RandoL26/ENMT301_RoboCup/Solidworks/Drawings/CraneArm.JPG

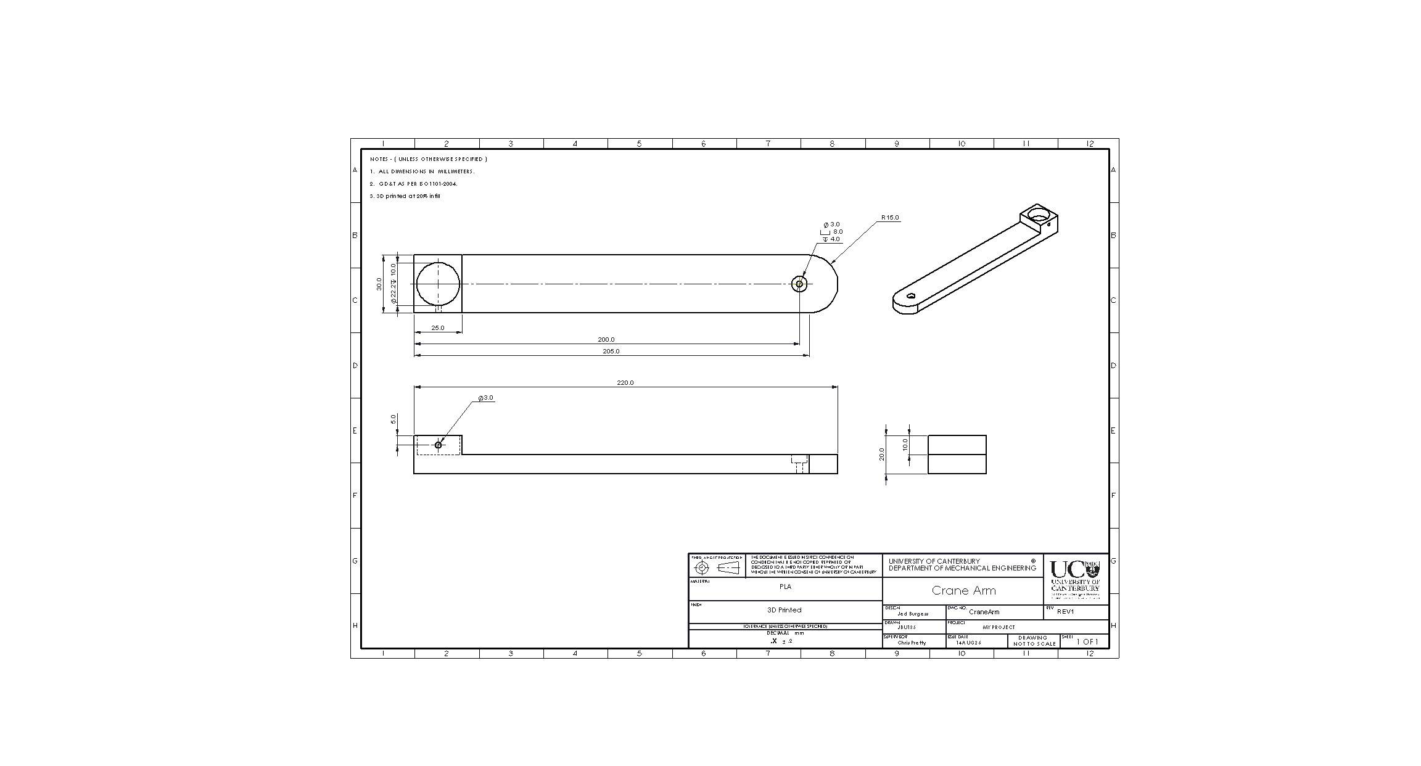
Solidworks/Drawings/CraneArm.JPG
