RandoL26/ENMT301_RoboCup/Solidworks/Drawings/Electronics Bay Upper.JPG

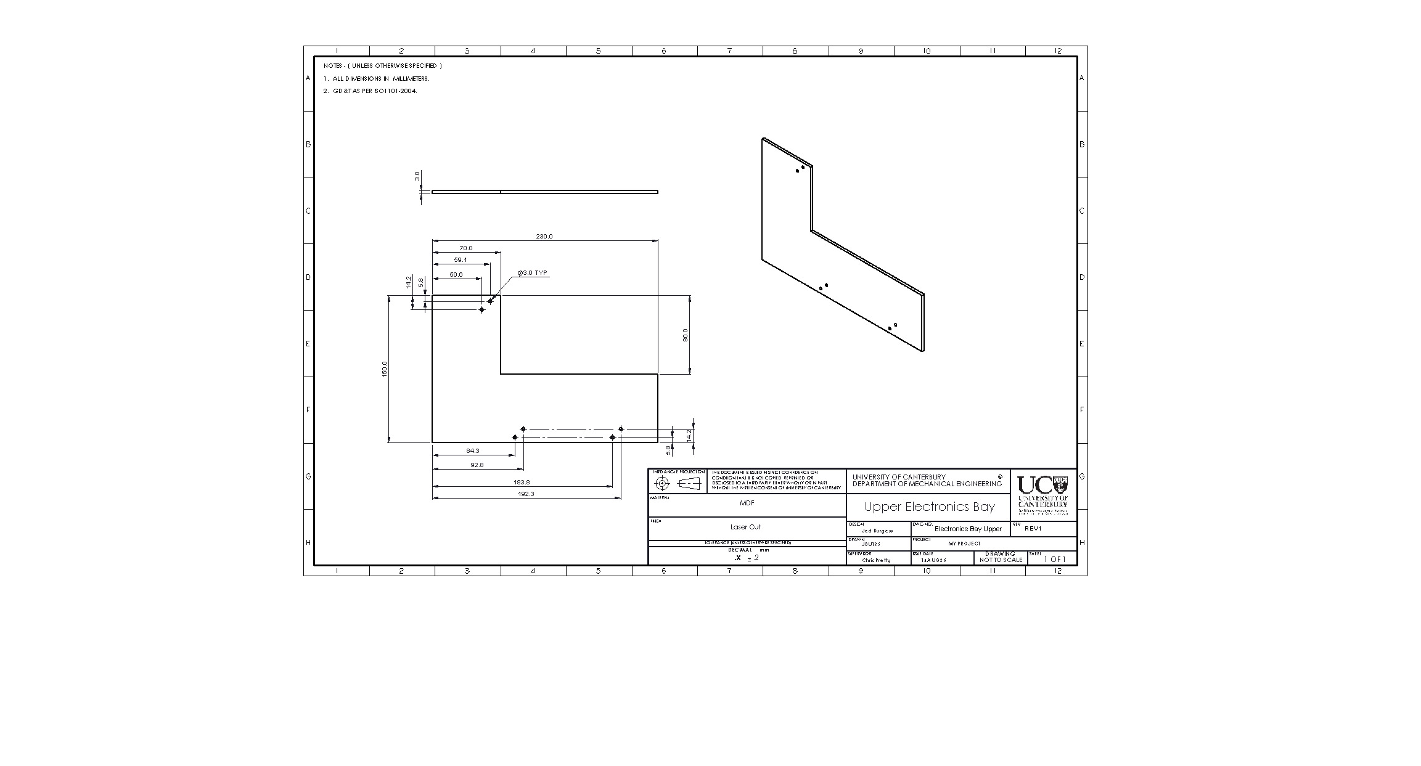
Solidworks/Drawings/Electronics Bay Upper.JPG
