RandoL26/ENMT301_RoboCup/Solidworks/Robot main chassis support 223.5mm_SP.SLDPRT

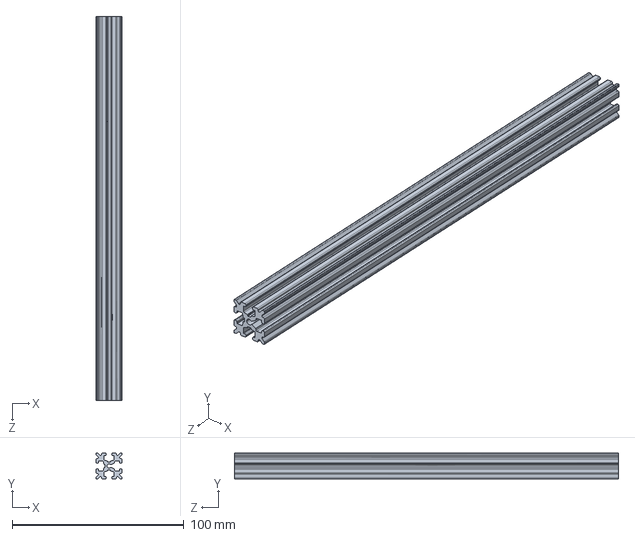
[picture p3: CAD file, 2026-06-23]
Solidworks/Robot main chassis support 223.5mm_SP.SLDPRT
15.0 x 15.0 x 223.5 mm
