RandoL26/ENMT301_RoboCup/Solidworks/Storage/Storage Assembly.SLDASM

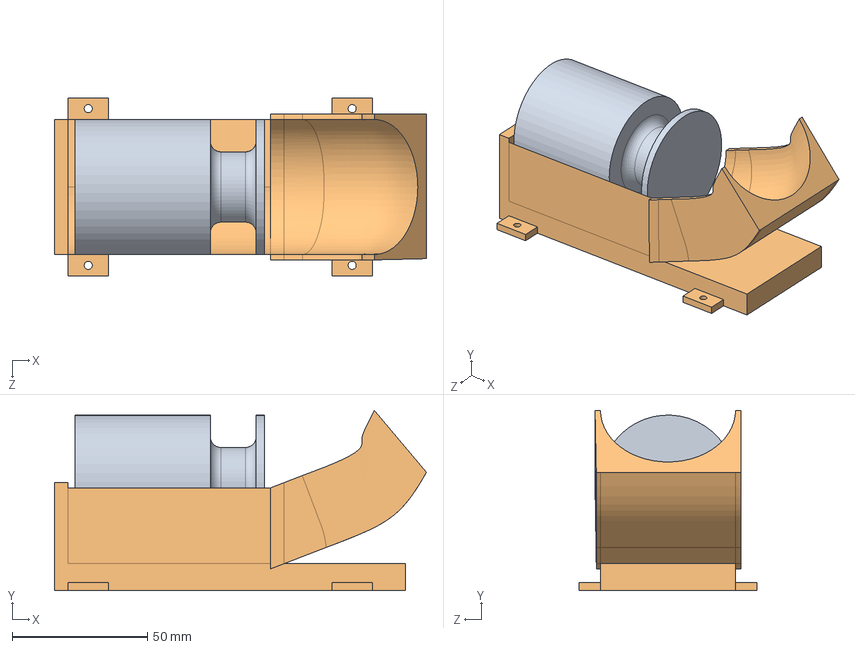
[picture p4: CAD file, 2026-08-28]
Solidworks/Storage/Storage Assembly.SLDASM
137.7 x 66.8 x 66.0 mm
Storage
WeightModel
