RandoL26/ENMT301_RoboCup/Solidworks/Weight Rejection/WeightRejectionAssembly.SLDASM

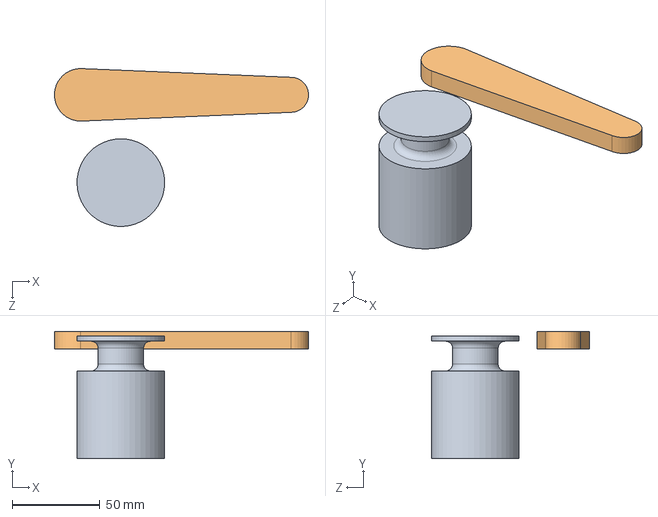
[picture p5: CAD file, 2026-08-07]
Solidworks/Weight Rejection/WeightRejectionAssembly.SLDASM
144.9 x 72.6 x 90.1 mm
RejectionArm
WeightModel
