RandoL26/ENMT301_RoboCup/Solidworks/Storage/StorageAssemblyV2.SLDASM

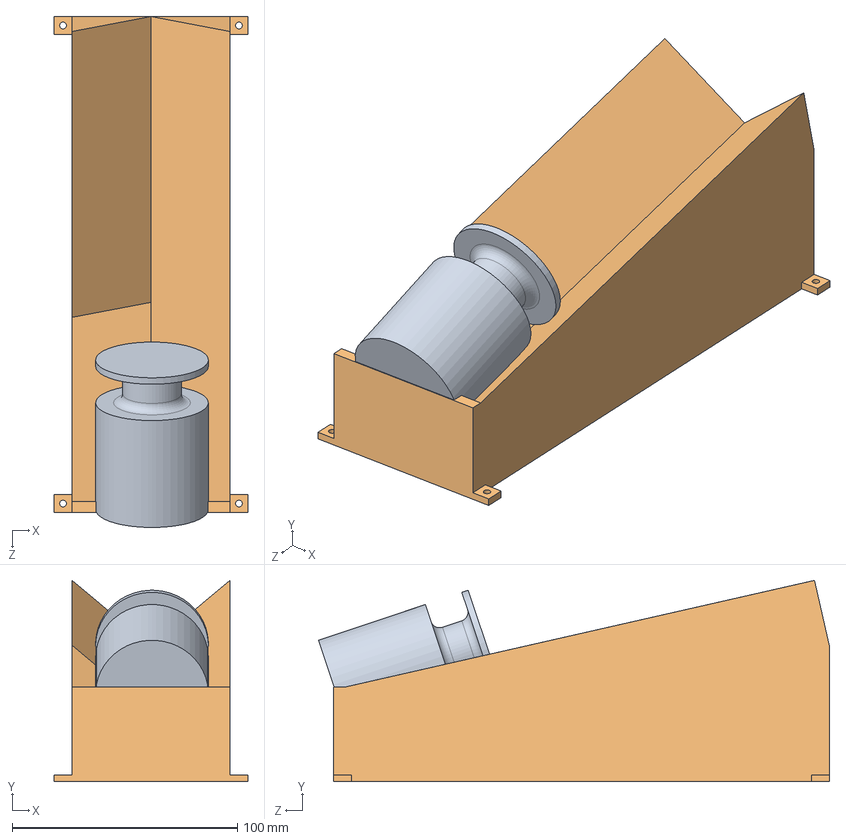
[picture p6: CAD file, 2026-08-28]
Solidworks/Storage/StorageAssemblyV2.SLDASM
86.0 x 89.3 x 226.6 mm
StorageV2
WeightModel
