RandoL26/ENMT301_RoboCup/Solidworks/MainAssembly/Custom Chassis Base.SLDPRT

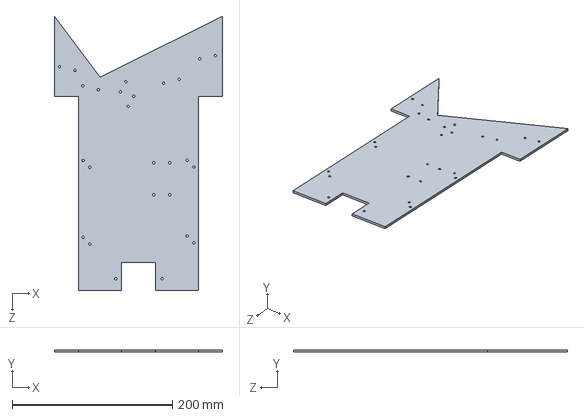
[picture p7: CAD file, 2026-09-27]
Solidworks/MainAssembly/Custom Chassis Base.SLDPRT
210.0 x 3.00 x 343.0 mm
