RandoL26/ENMT301_RoboCup/Solidworks/Printing/10 Teeth Gear 22mm bearing, drivebelt meshing.SLDPRT

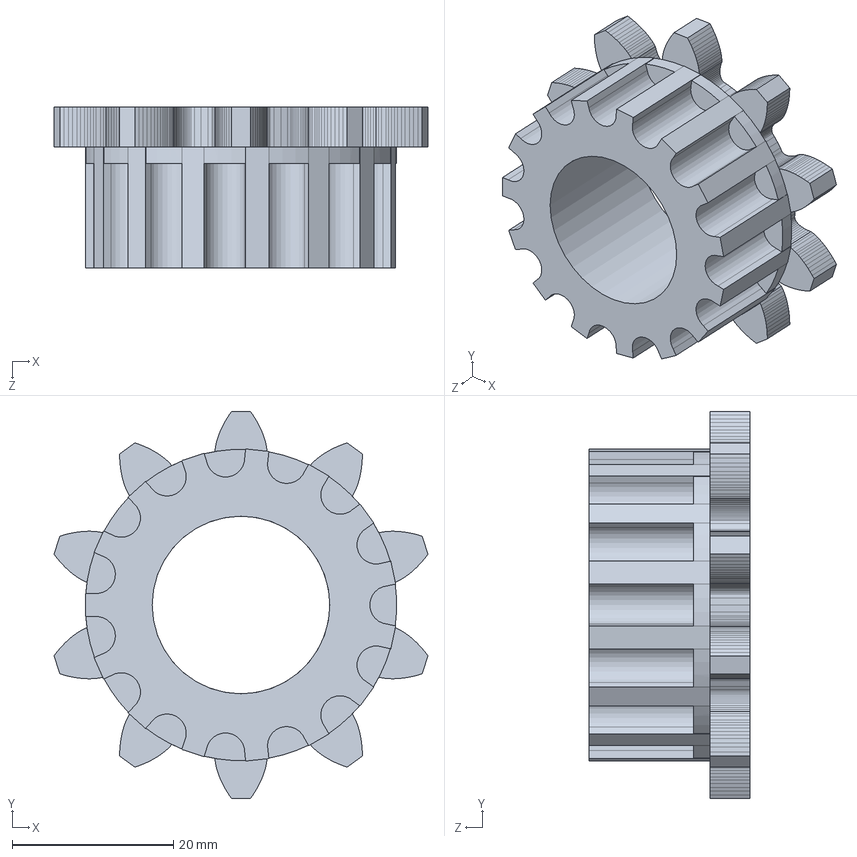
[picture p8: CAD file, 2026-09-29]
Solidworks/Printing/10 Teeth Gear 22mm bearing, drivebelt meshing.SLDPRT
46.3 x 47.9 x 20.0 mm
