RandoL26/ENMT301_RoboCup/Solidworks/Storage/StorageV2.SLDPRT

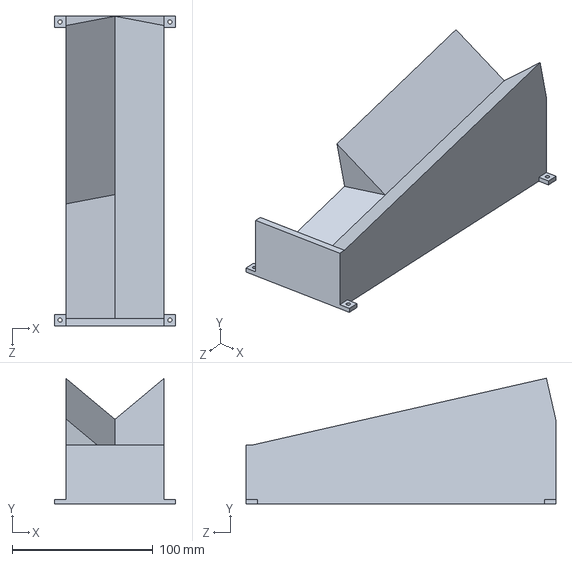
[picture p9: CAD file, 2026-08-28]
Solidworks/Storage/StorageV2.SLDPRT
86.0 x 89.3 x 220.0 mm
