RandoL26/ENMT301_RoboCup/Solidworks/CraneArm/CraneArm.SLDPRT

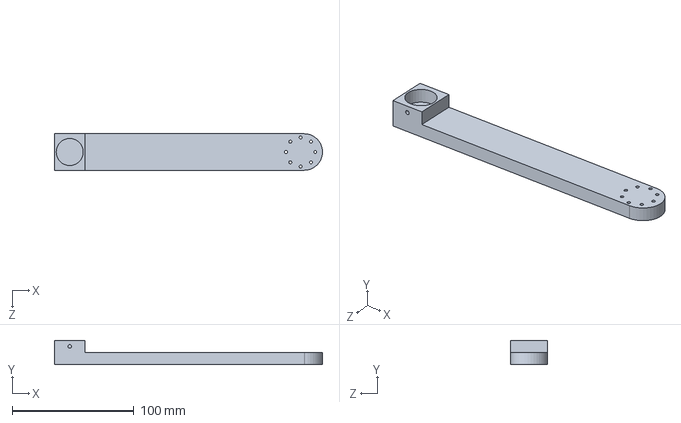
[picture p10: CAD file, 2026-09-29]
Solidworks/CraneArm/CraneArm.SLDPRT
219.9 x 20.0 x 30.0 mm
