RandoL26/ENMT301_RoboCup/Solidworks/DriveBeltAssembly/Custom Side Plate.SLDPRT

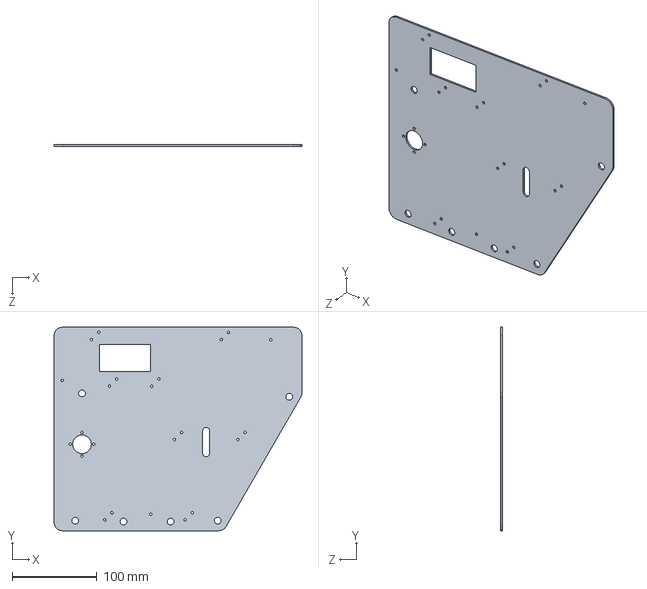
[picture p11: CAD file, 2026-09-29]
Solidworks/DriveBeltAssembly/Custom Side Plate.SLDPRT
292.4 x 240.0 x 2.00 mm
