RandoL26/ENMT301_RoboCup/Solidworks/Electronics/Inductiveshiftmount.SLDPRT

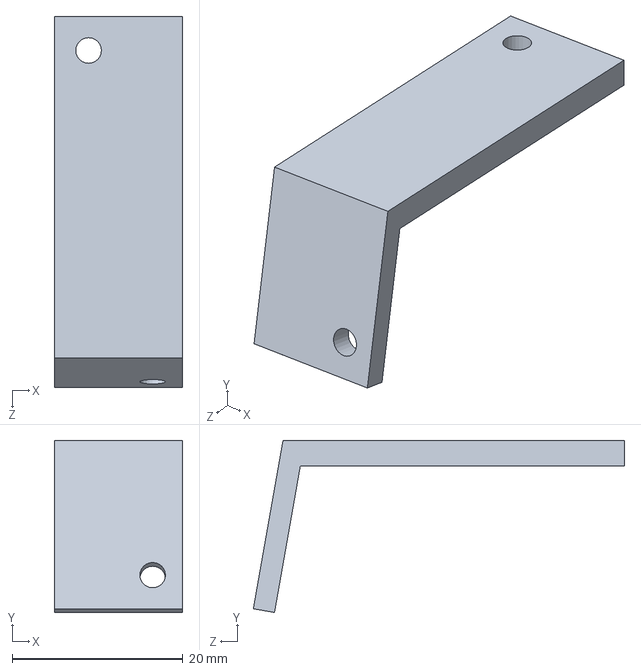
[picture p12: CAD file, 2026-09-29]
Solidworks/Electronics/Inductiveshiftmount.SLDPRT
15.0 x 20.1 x 43.5 mm
