RandoL26/ENMT301_RoboCup/Solidworks/MainAssembly/Opticalflwmount.SLDPRT

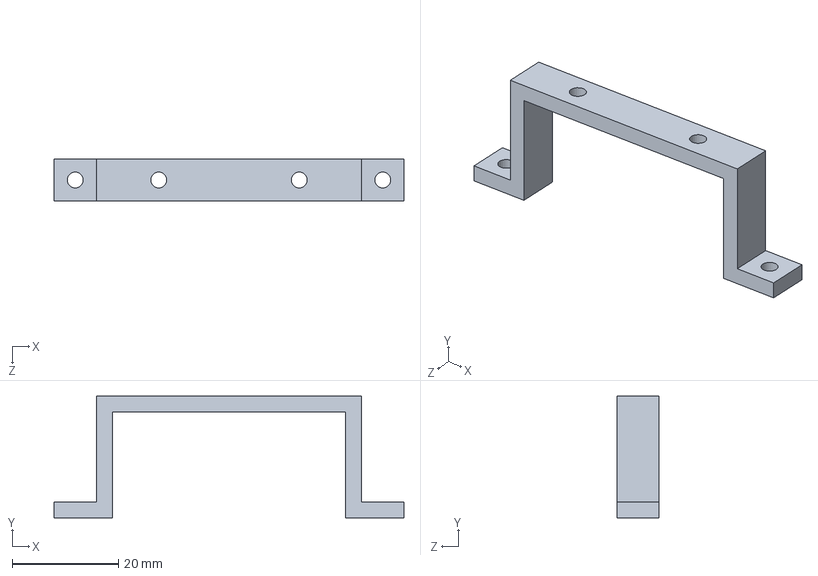
[picture p13: CAD file, 2026-09-25]
Solidworks/MainAssembly/Opticalflwmount.SLDPRT
66.0 x 23.0 x 8.00 mm
