RandoL26/ENMT301_RoboCup/Solidworks/Printing/20 Teeth Gear 6.25mm bore for motor shaft.SLDPRT

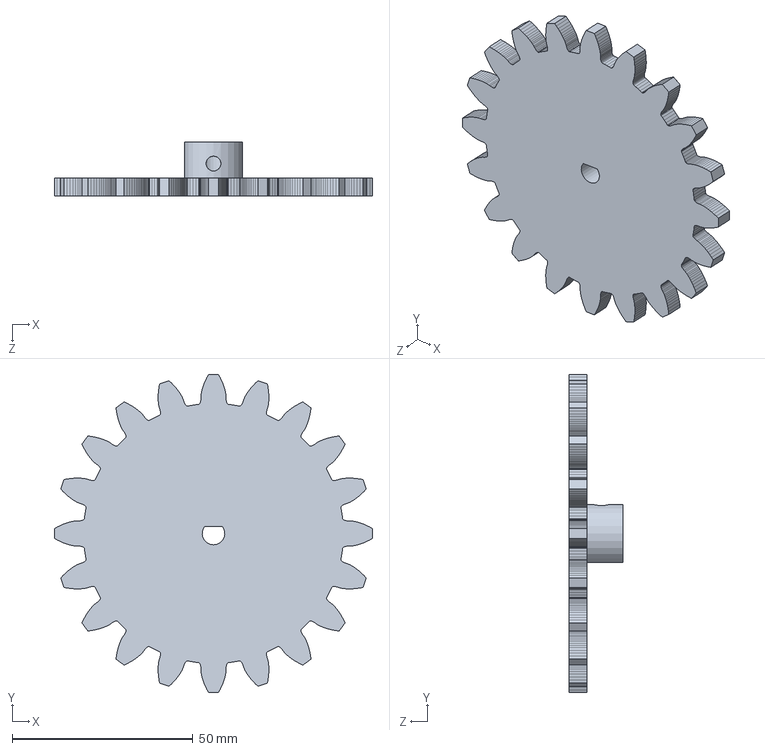
[picture p14: CAD file, 2026-09-29]
Solidworks/Printing/20 Teeth Gear 6.25mm bore for motor shaft.SLDPRT
88.0 x 88.0 x 15.0 mm
