RandoL26/ENMT301_RoboCup/Solidworks/Top Plate_SP.SLDPRT

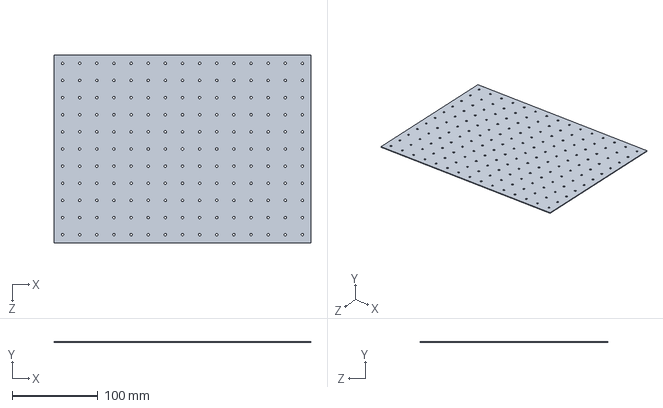
[picture p15: CAD file, 2026-06-23]
Solidworks/Top Plate_SP.SLDPRT
300.0 x 1.00 x 220.0 mm
