RandoL26/ENMT301_RoboCup/Solidworks/Weight Rejection/RejectionArm.SLDPRT

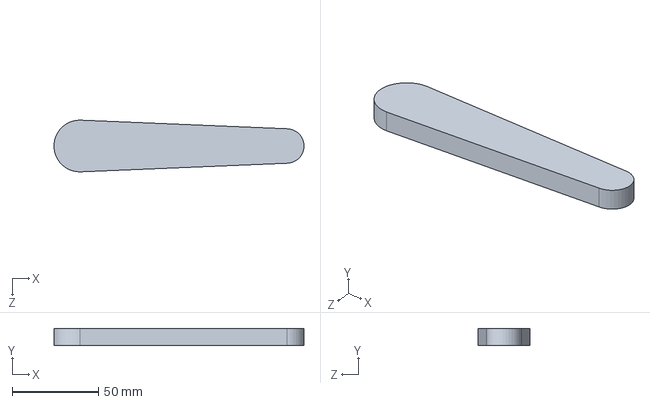
[picture p16: CAD file, 2026-08-07]
Solidworks/Weight Rejection/RejectionArm.SLDPRT
144.9 x 10.0 x 30.0 mm
