RandoL26/ENMT301_RoboCup/Solidworks/CraneArm/CraneArmSupport.SLDPRT

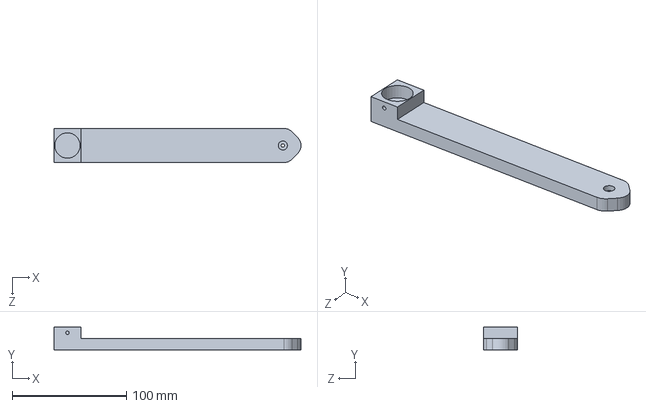
[picture p17: CAD file, 2026-07-13]
Solidworks/CraneArm/CraneArmSupport.SLDPRT
215.9 x 20.0 x 30.0 mm
