RandoL26/ENMT301_RoboCup/Solidworks/DriveBeltAssembly/Custom Side Plate Flipped.SLDPRT

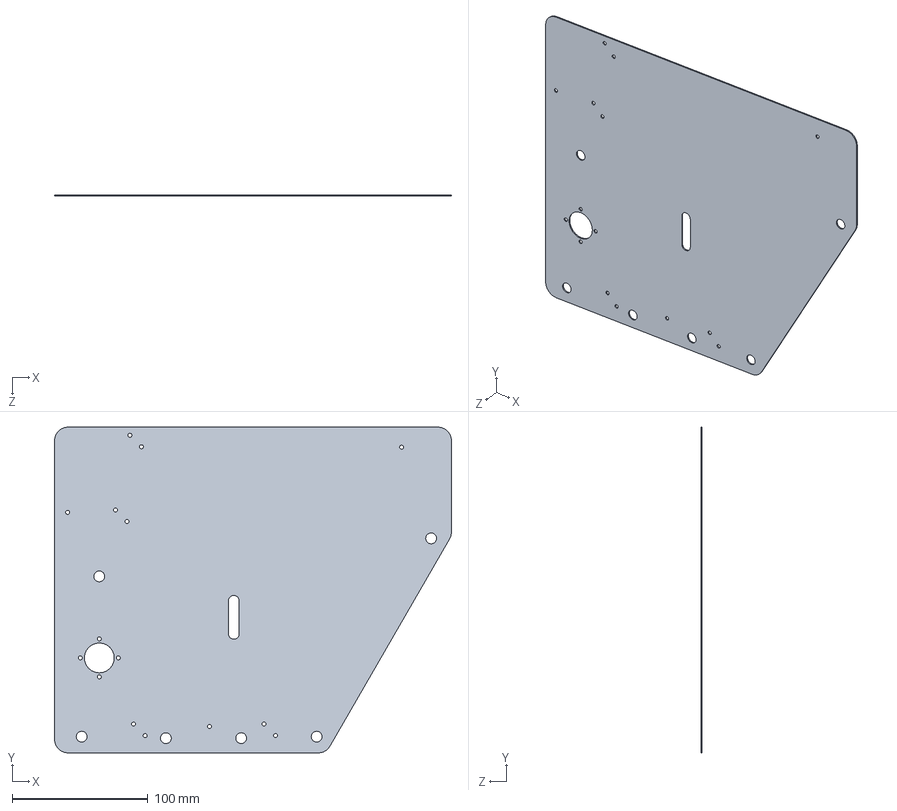
[picture p18: CAD file, 2026-09-29]
Solidworks/DriveBeltAssembly/Custom Side Plate Flipped.SLDPRT
292.4 x 240.0 x 1.00 mm
