RandoL26/ENMT301_RoboCup/Solidworks/Open Beam Aluminum Profile 30mm_SP.SLDPRT

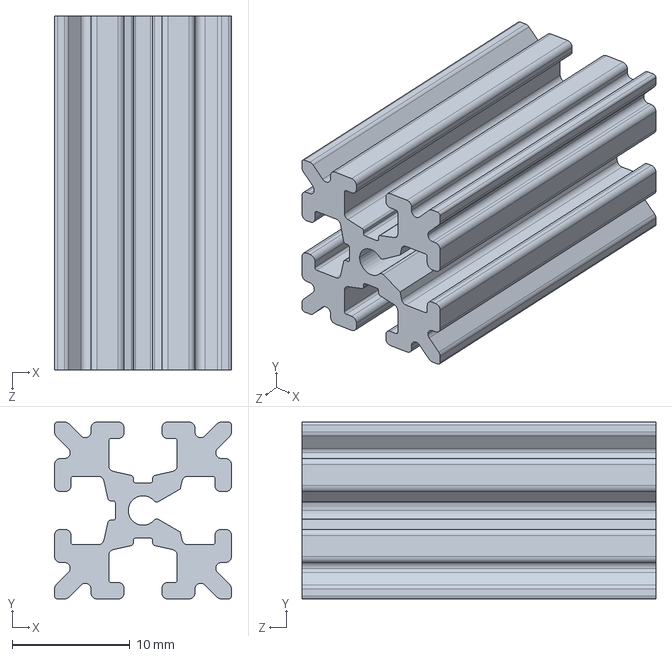
[picture p19: CAD file, 2026-06-23]
Solidworks/Open Beam Aluminum Profile 30mm_SP.SLDPRT
15.0 x 15.0 x 30.0 mm
