RandoL26/ENMT301_RoboCup/Solidworks/Printing/20 Teeth Gear 6.25mm blahblahblah.SLDPRT

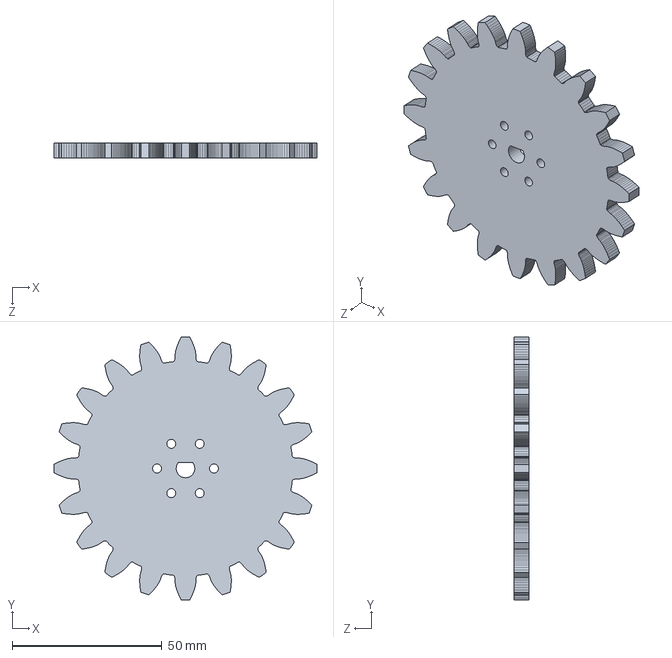
[picture p20: CAD file, 2026-09-29]
Solidworks/Printing/20 Teeth Gear 6.25mm blahblahblah.SLDPRT
88.0 x 88.0 x 5.00 mm
