RandoL26/ENMT301_RoboCup/Solidworks/Storage/Storage.SLDPRT

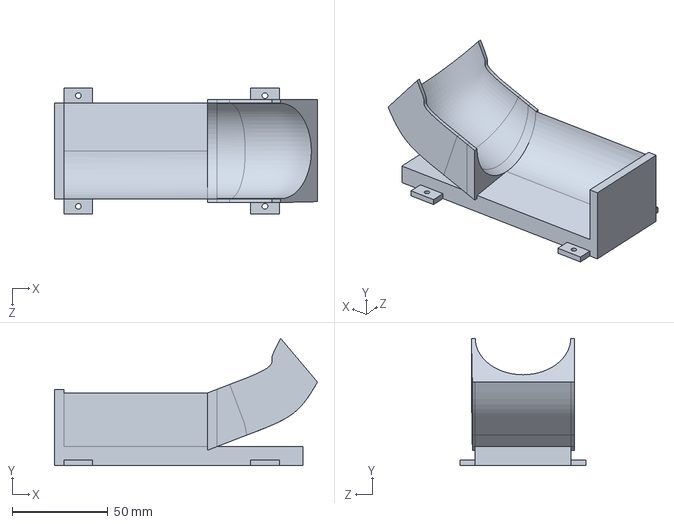
[picture p21: CAD file, 2026-08-28]
Solidworks/Storage/Storage.SLDPRT
137.7 x 66.8 x 66.0 mm
