RandoL26/ENMT301_RoboCup/Solidworks/Electronics/Electronics Bay Upper.SLDPRT

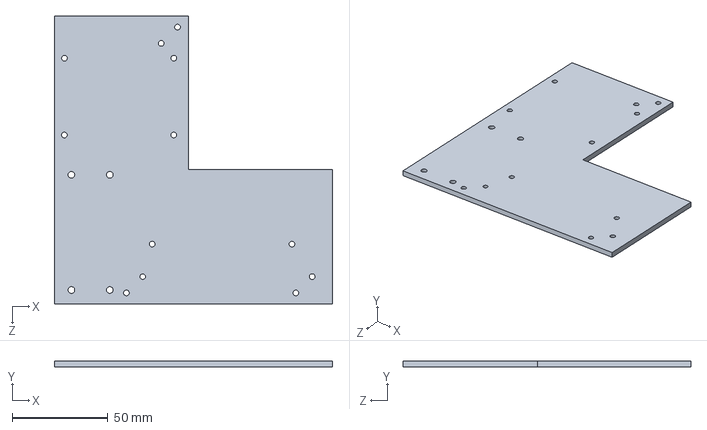
[picture p22: CAD file, 2026-09-29]
Solidworks/Electronics/Electronics Bay Upper.SLDPRT
145.0 x 3.00 x 150.0 mm
