RandoL26/ENMT301_RoboCup/Solidworks/MainAssembly/Open Beam Aluminum Profile 150mm_SP.SLDPRT

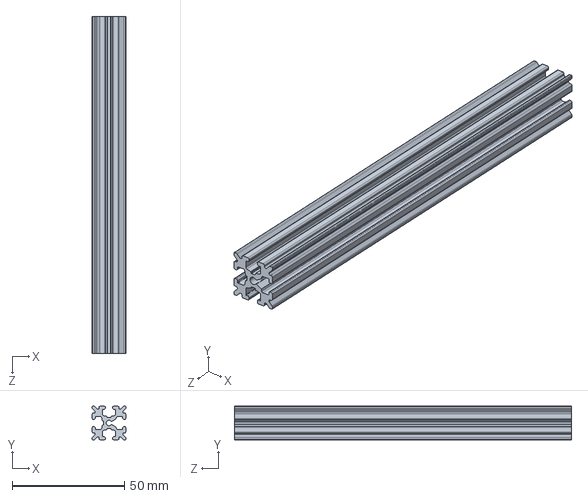
[picture p23: CAD file, 2026-07-15]
Solidworks/MainAssembly/Open Beam Aluminum Profile 150mm_SP.SLDPRT
15.0 x 15.0 x 150.0 mm
