RandoL26/ENMT301_RoboCup/Solidworks/Printing/InductorShiftMount Straight.3MF

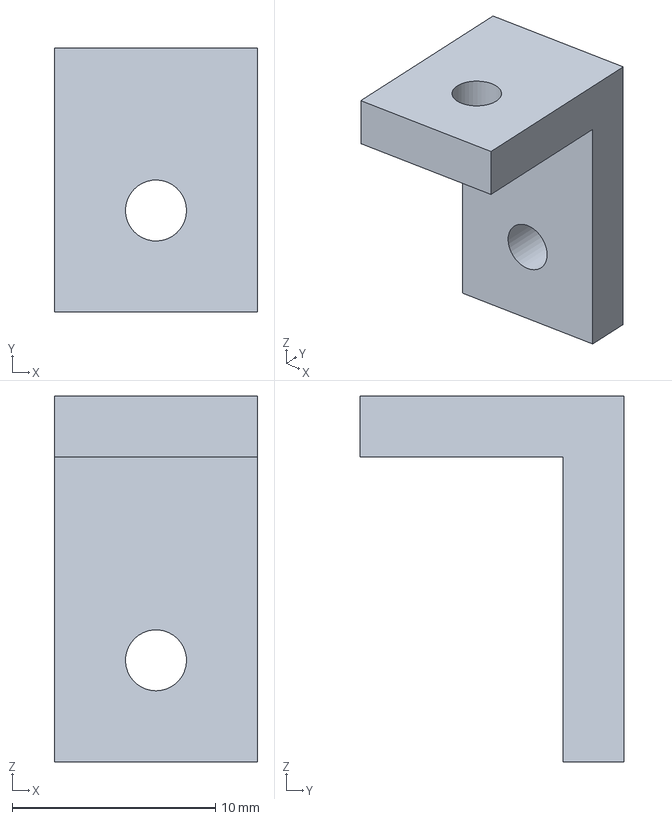
[picture p24: CAD file, 2026-09-29]
Solidworks/Printing/InductorShiftMount Straight.3MF
10.0 x 13.0 x 18.0 mm
