RandoL26/ENMT301_RoboCup/Solidworks/CraneArm/60kgServoMount.SLDPRT

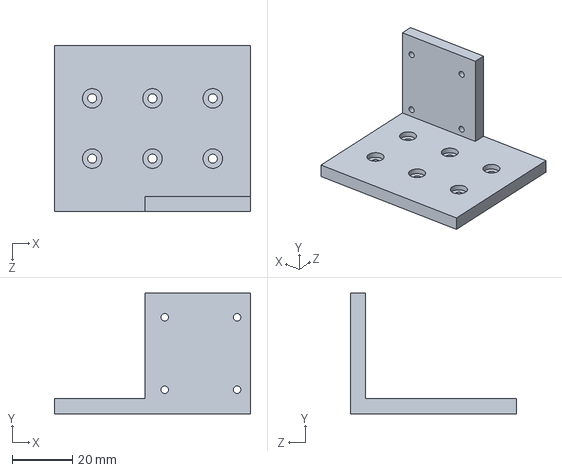
[picture p25: CAD file, 2026-07-13]
Solidworks/CraneArm/60kgServoMount.SLDPRT
65.0 x 40.0 x 55.0 mm
