RandoL26/ENMT301_RoboCup/Solidworks/MainAssembly/Floor.SLDPRT

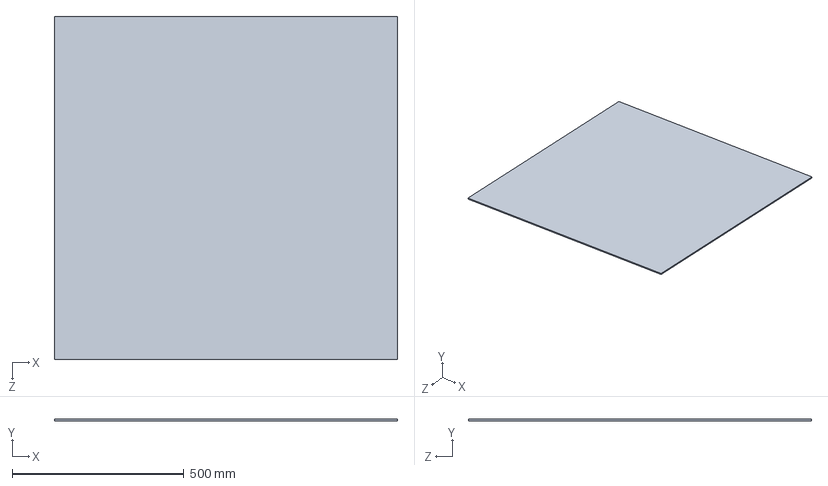
[picture p26: CAD file, 2026-06-27]
Solidworks/MainAssembly/Floor.SLDPRT
1000.0 x 5.00 x 1000.0 mm
