RandoL26/ENMT301_RoboCup/Solidworks/Printing/DrivewheelDraft1.SLDPRT

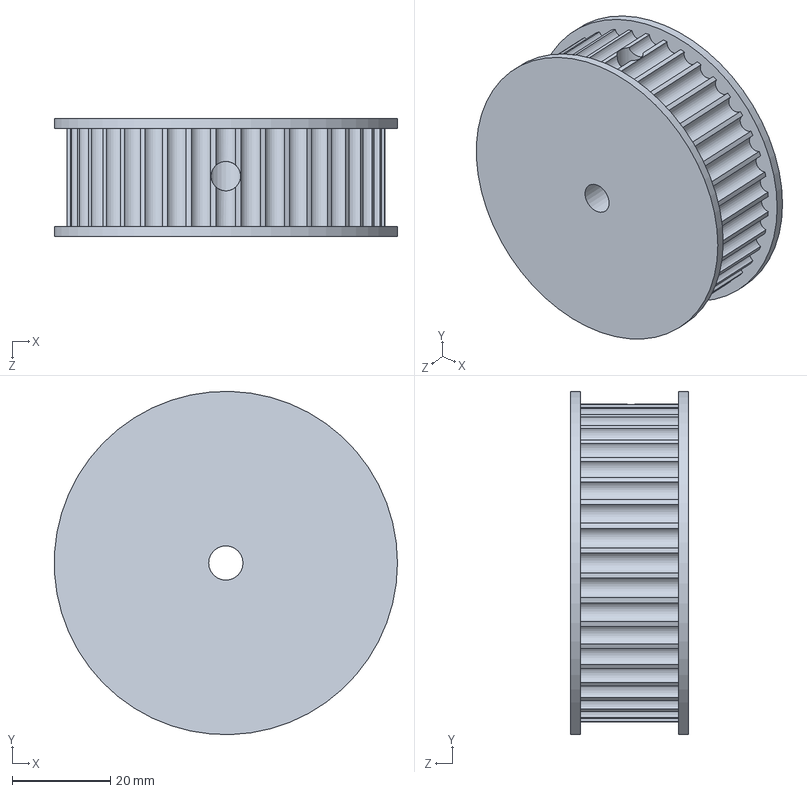
[picture p27: CAD file, 2026-09-29]
Solidworks/Printing/DrivewheelDraft1.SLDPRT
69.9 x 70.0 x 24.0 mm
