RandoL26/ENMT301_RoboCup/Solidworks/Storage/Storagegate.SLDPRT

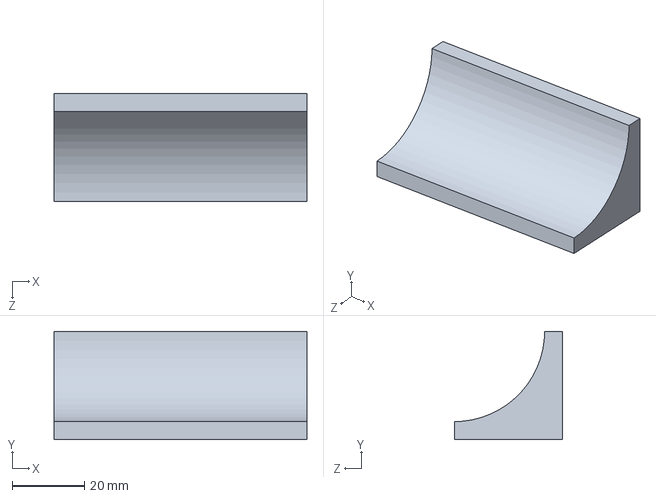
[picture p28: CAD file, 2026-08-07]
Solidworks/Storage/Storagegate.SLDPRT
70.0 x 30.0 x 30.0 mm
