RandoL26/ENMT301_RoboCup/Solidworks/WeightModel.SLDPRT

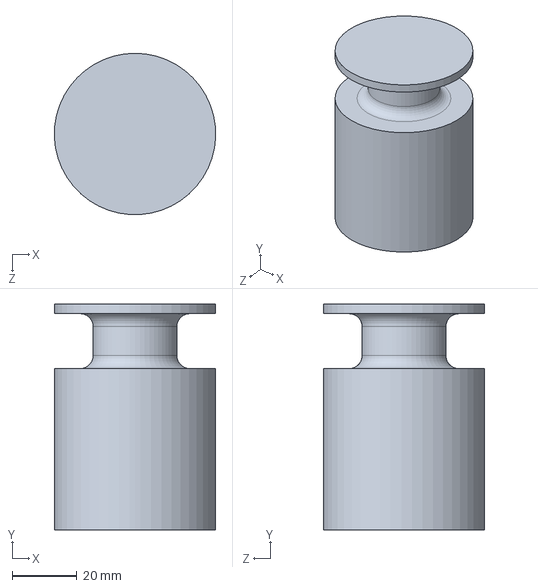
[picture p29: CAD file, 2026-05-20]
Solidworks/WeightModel.SLDPRT
50.0 x 70.0 x 50.0 mm
