RandoL26/ENMT301_RoboCup/Solidworks/CraneArm/WeightGuides.SLDPRT

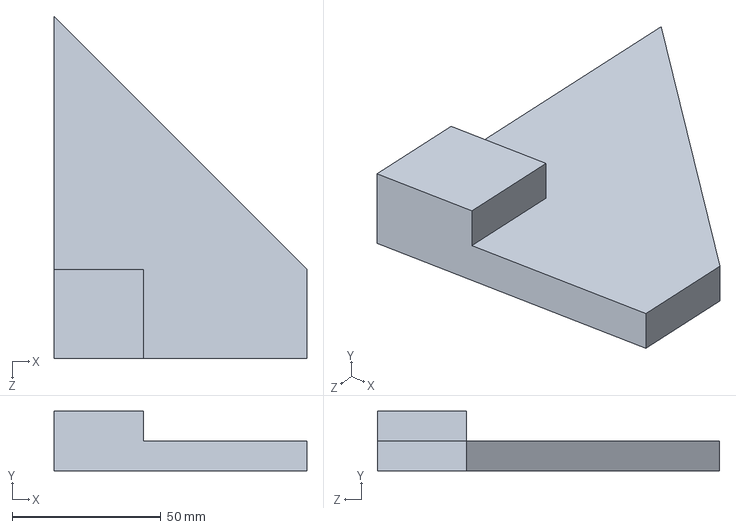
[picture p30: CAD file, 2026-06-27]
Solidworks/CraneArm/WeightGuides.SLDPRT
85.0 x 20.0 x 115.0 mm
