RandoL26/ENMT301_RoboCup/Solidworks/DriveBeltAssembly/Bearing.SLDPRT

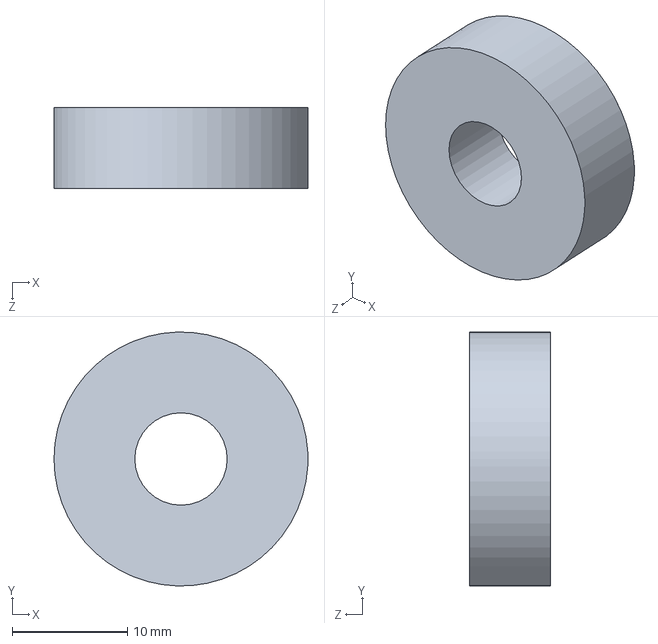
[picture p31: CAD file, 2026-09-27]
Solidworks/DriveBeltAssembly/Bearing.SLDPRT
22.0 x 22.0 x 7.00 mm
