RandoL26/ENMT301_RoboCup/Solidworks/Electronics/Electronics Bay.SLDPRT

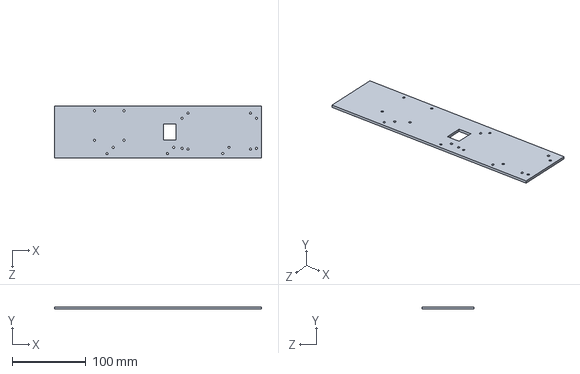
[picture p32: CAD file, 2026-09-25]
Solidworks/Electronics/Electronics Bay.SLDPRT
280.0 x 3.00 x 70.0 mm
