RandoL26/ENMT301_RoboCup/Solidworks/MainAssembly/HolderSmartServoBent_SP.SLDPRT

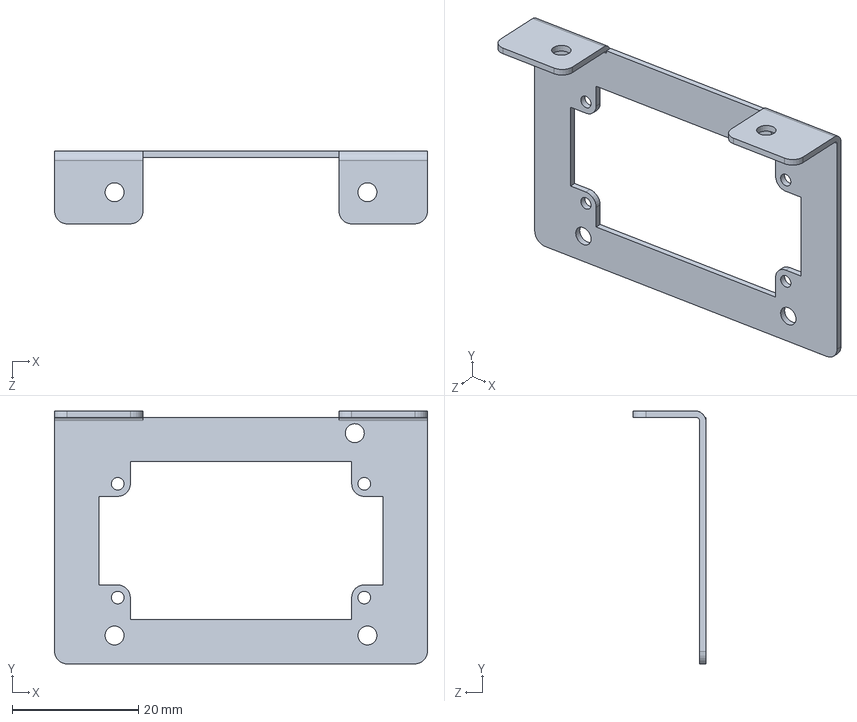
[picture p33: CAD file, 2026-06-23]
Solidworks/MainAssembly/HolderSmartServoBent_SP.SLDPRT
59.0 x 40.0 x 11.5 mm
