RandoL26/ENMT301_RoboCup/Solidworks/Printing/13 Teeth Gear on 22mm bearing improvement on the drivewheel meshing.SLDPRT

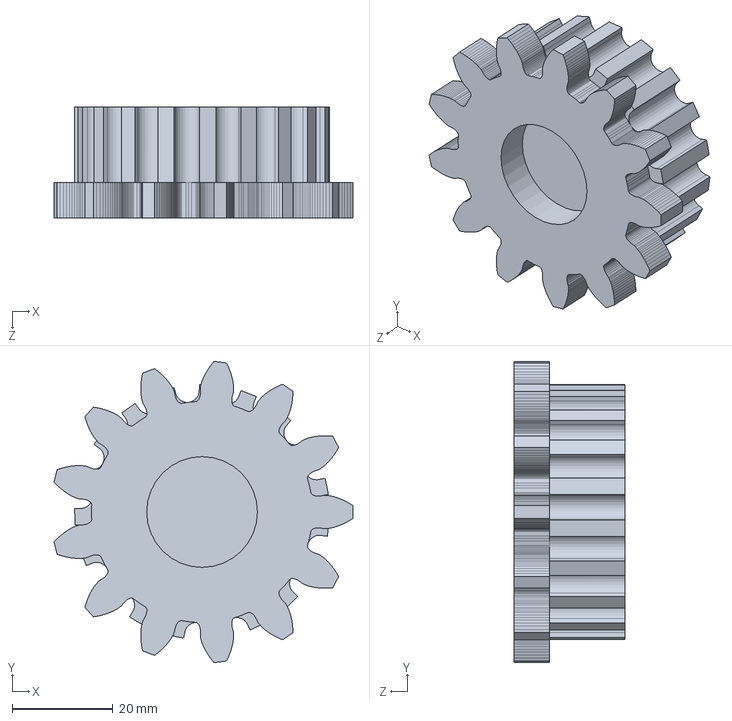
[picture p34: CAD file, 2026-09-27]
Solidworks/Printing/13 Teeth Gear on 22mm bearing improvement on the drivewheel meshing.SLDPRT
59.4 x 59.8 x 22.0 mm
