RandoL26/ENMT301_RoboCup/Solidworks/CraneArm/ElectroMagnetCasingV3.SLDPRT

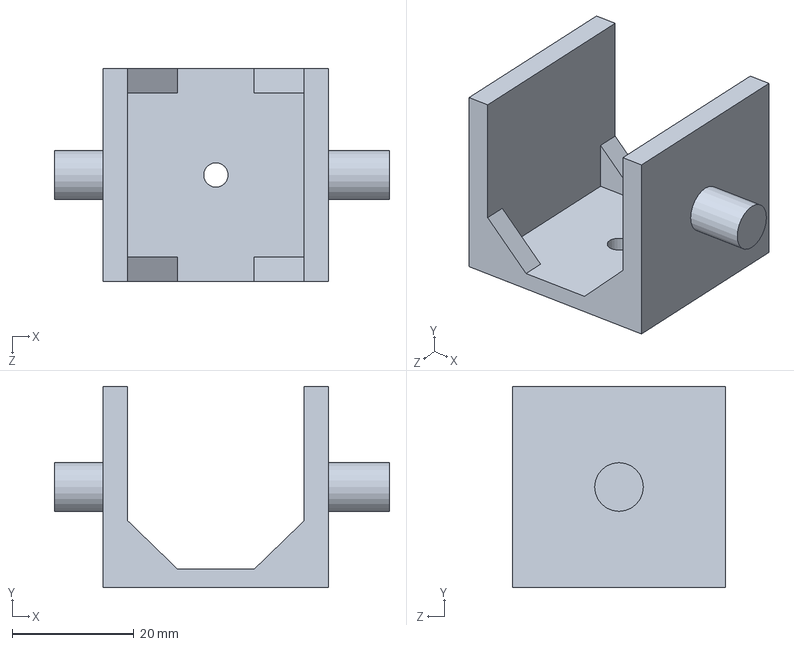
[picture p35: CAD file, 2026-06-23]
Solidworks/CraneArm/ElectroMagnetCasingV3.SLDPRT
55.0 x 33.0 x 35.0 mm
