RandoL26/ENMT301_RoboCup/Solidworks/DriveBeltAssembly/MDFWeightGuides.SLDPRT

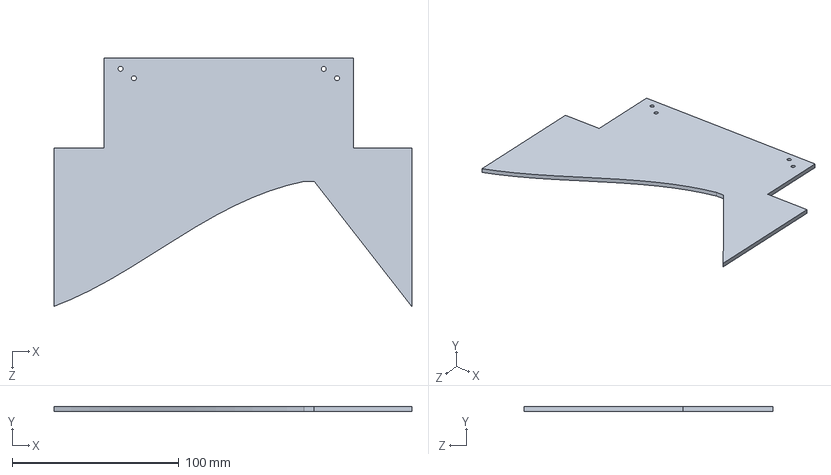
[picture p36: CAD file, 2026-08-13]
Solidworks/DriveBeltAssembly/MDFWeightGuides.SLDPRT
215.0 x 3.00 x 149.4 mm
