RandoL26/ENMT301_RoboCup/Solidworks/DriveTrack/Flanged Bearing F608ZZ_SP.SLDPRT

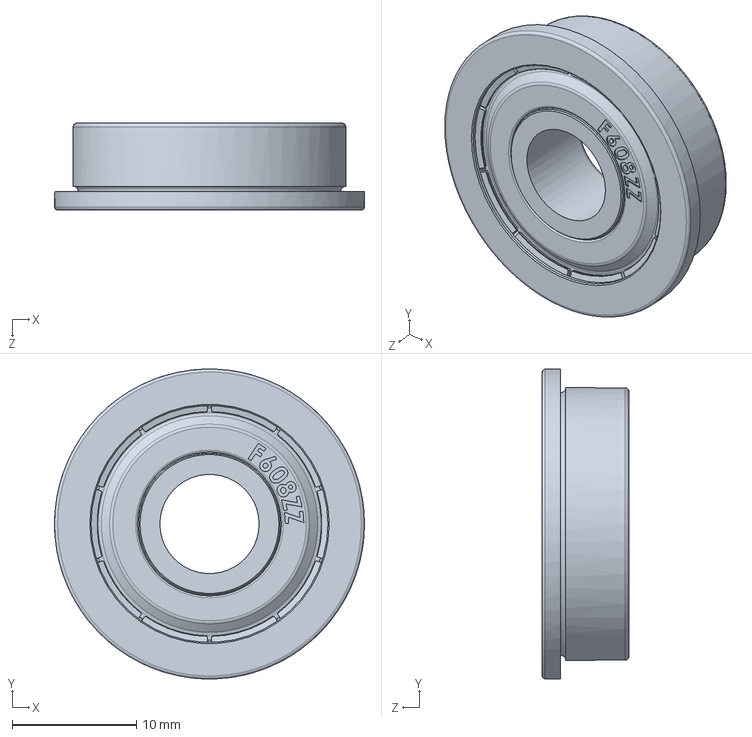
[picture p37: CAD file, 2026-06-23]
Solidworks/DriveTrack/Flanged Bearing F608ZZ_SP.SLDPRT
25.0 x 25.0 x 7.00 mm
