RandoL26/ENMT301_RoboCup/Solidworks/Electronics/new upper upper electronics bay.SLDPRT

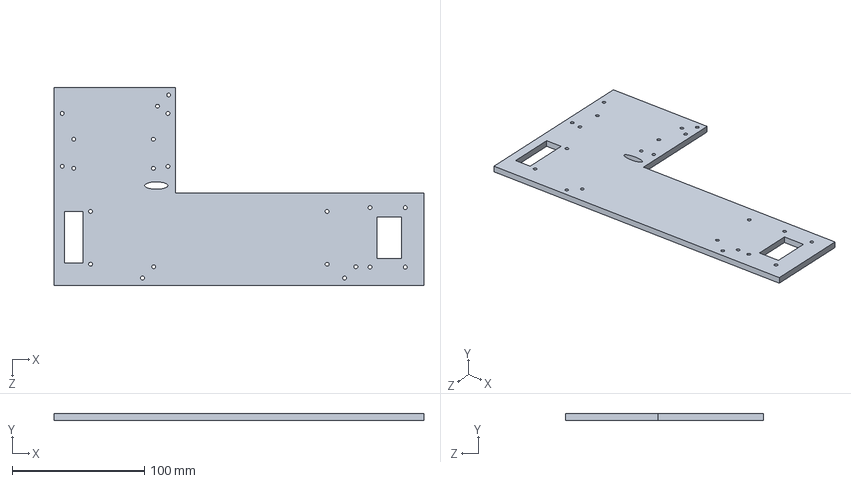
[picture p38: CAD file, 2026-09-25]
Solidworks/Electronics/new upper upper electronics bay.SLDPRT
280.0 x 5.00 x 150.0 mm
