RandoL26/ENMT301_RoboCup/Solidworks/Printing/26 Teeth Gear 6.25mm bore for motor shaft.SLDPRT

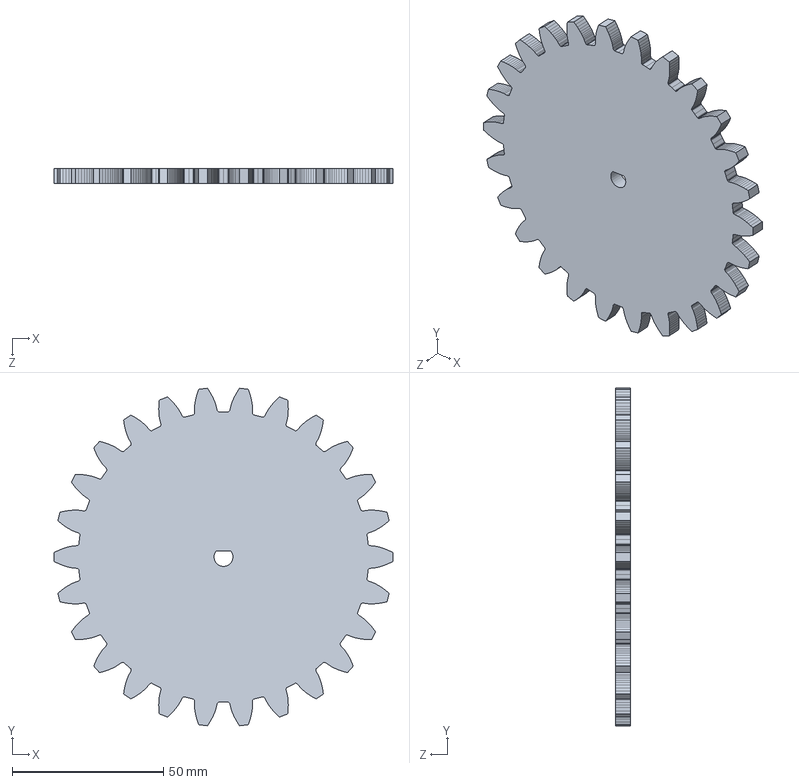
[picture p39: CAD file, 2026-09-27]
Solidworks/Printing/26 Teeth Gear 6.25mm bore for motor shaft.SLDPRT
112.0 x 111.5 x 5.00 mm
