RandoL26/ENMT301_RoboCup/Solidworks/CraneArm/robot-servo-60-kg-rds5160-1 Electric Motor_SP.SLDPRT

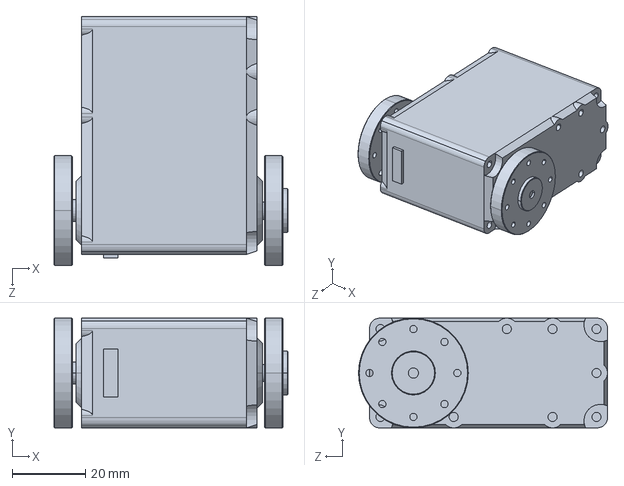
[picture p40: CAD file, 2026-06-23]
Solidworks/CraneArm/robot-servo-60-kg-rds5160-1 Electric Motor_SP.SLDPRT
63.9 x 30.0 x 68.0 mm
