RandoL26/ENMT301_RoboCup/Solidworks/Electronics/IMU.SLDPRT

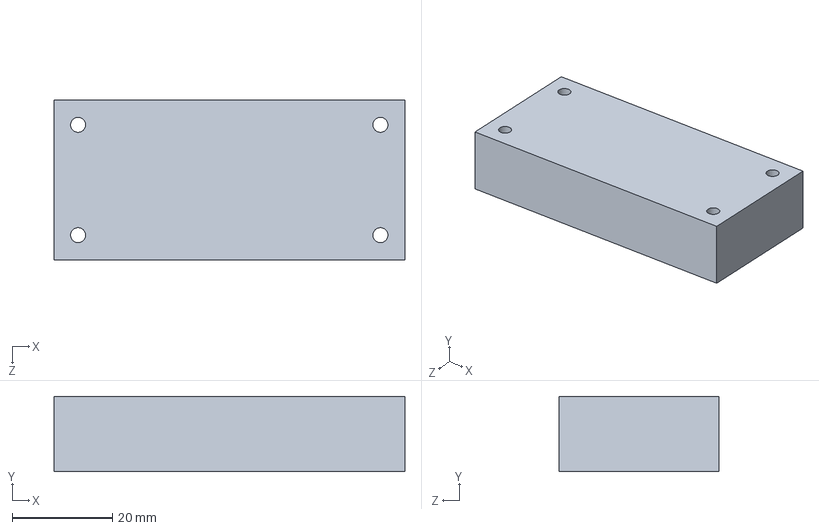
[picture p41: CAD file, 2026-09-25]
Solidworks/Electronics/IMU.SLDPRT
70.0 x 15.0 x 32.0 mm
