RandoL26/ENMT301_RoboCup/Solidworks/CraneArm/ElectroMagnet.SLDPRT

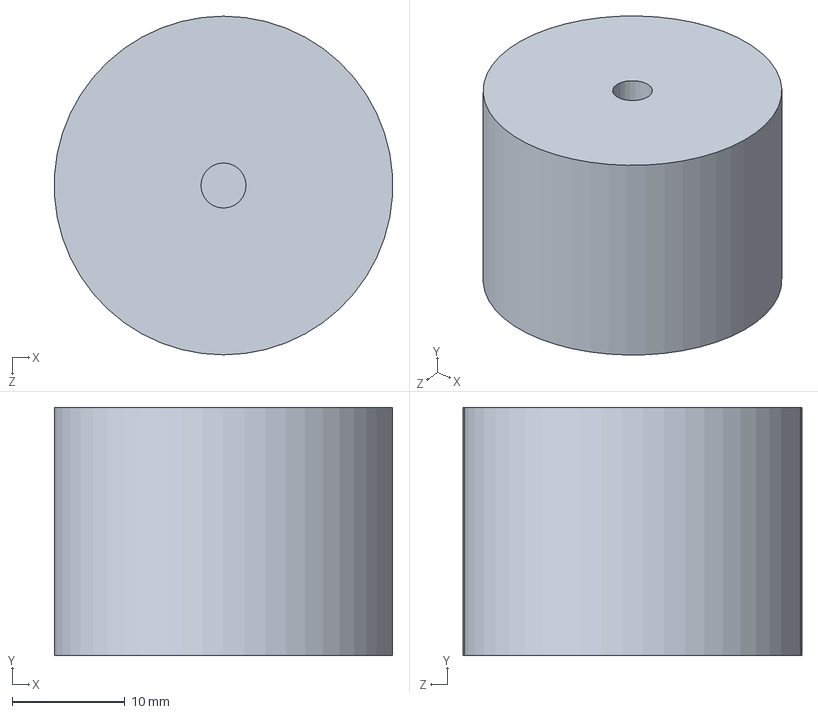
[picture p42: CAD file, 2026-06-23]
Solidworks/CraneArm/ElectroMagnet.SLDPRT
29.9 x 22.0 x 30.0 mm
