RandoL26/ENMT301_RoboCup/Solidworks/Electronics/opticalflow.SLDPRT

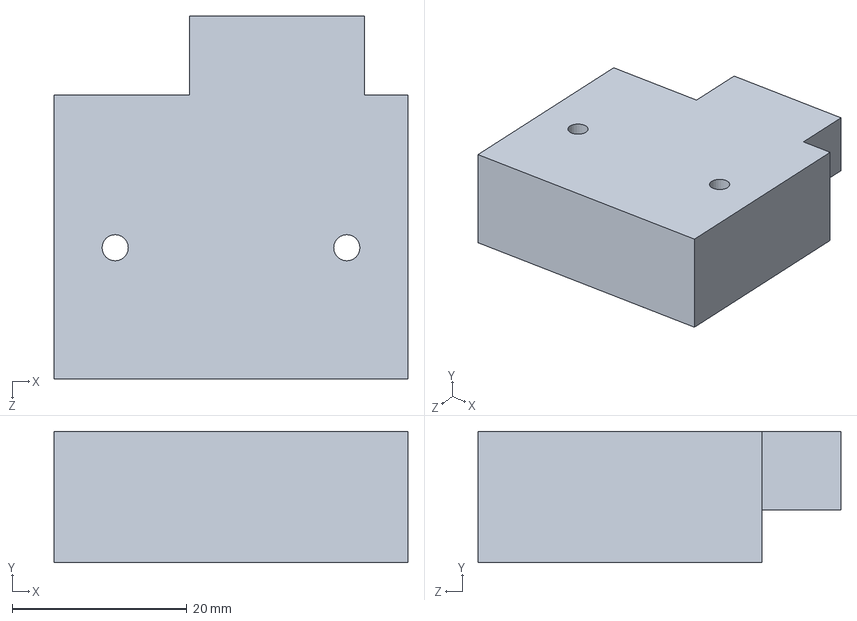
[picture p43: CAD file, 2026-09-25]
Solidworks/Electronics/opticalflow.SLDPRT
40.5 x 15.0 x 41.5 mm
