RandoL26/ENMT301_RoboCup/Solidworks/CraneArm/RotationalBearingM5TestPeice.SLDPRT

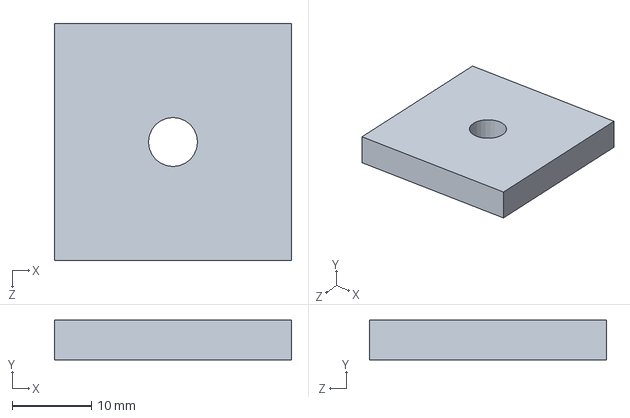
[picture p44: CAD file, 2026-06-23]
Solidworks/CraneArm/RotationalBearingM5TestPeice.SLDPRT
30.0 x 5.00 x 30.0 mm
