RandoL26/ENMT301_RoboCup/Solidworks/Electronics/serial level shift.SLDPRT

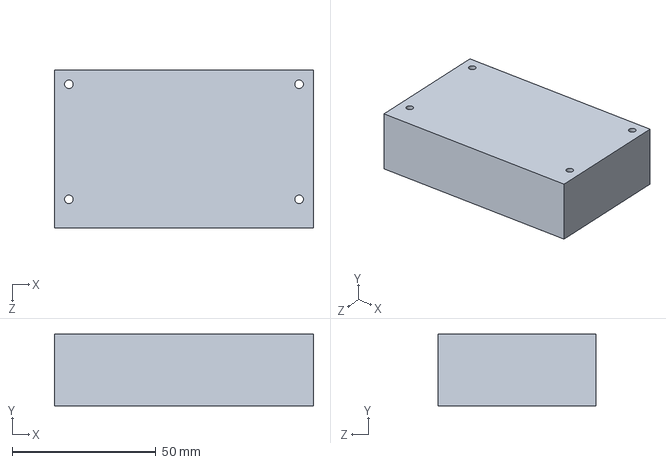
[picture p45: CAD file, 2026-09-24]
Solidworks/Electronics/serial level shift.SLDPRT
90.0 x 25.0 x 55.0 mm
