RandoL26/ENMT301_RoboCup/Solidworks/Printing/Sensor Mount.SLDPRT

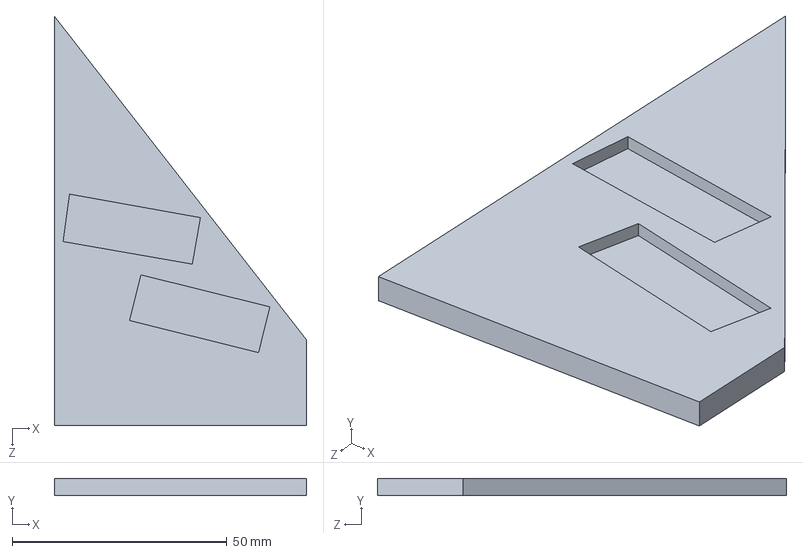
[picture p46: CAD file, 2026-08-28]
Solidworks/Printing/Sensor Mount.SLDPRT
58.7 x 4.00 x 95.4 mm
