RandoL26/ENMT301_RoboCup/Solidworks/DriveBeltAssembly/Robot Side Plate.SLDPRT

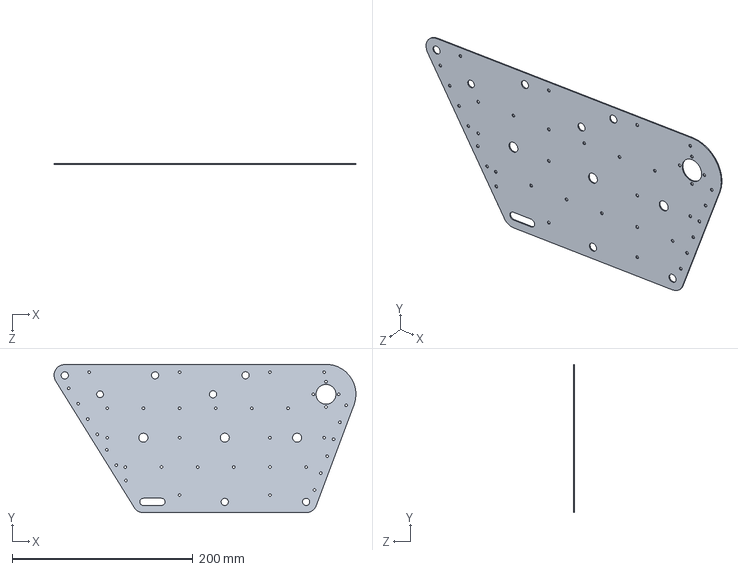
[picture p47: CAD file, 2026-07-28]
Solidworks/DriveBeltAssembly/Robot Side Plate.SLDPRT
334.1 x 164.2 x 1.00 mm
