RandoL26/ENMT301_RoboCup/Solidworks/Electronics/inductive level shift.SLDPRT

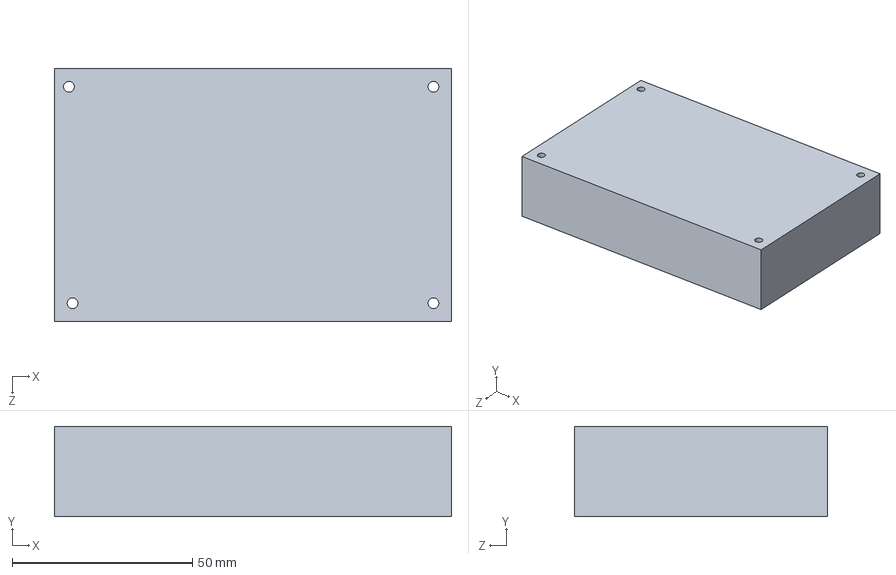
[picture p48: CAD file, 2026-09-22]
Solidworks/Electronics/inductive level shift.SLDPRT
110.0 x 25.0 x 70.0 mm
