RandoL26/ENMT301_RoboCup/Solidworks/CraneArm/ElectromagnetCasing.SLDPRT

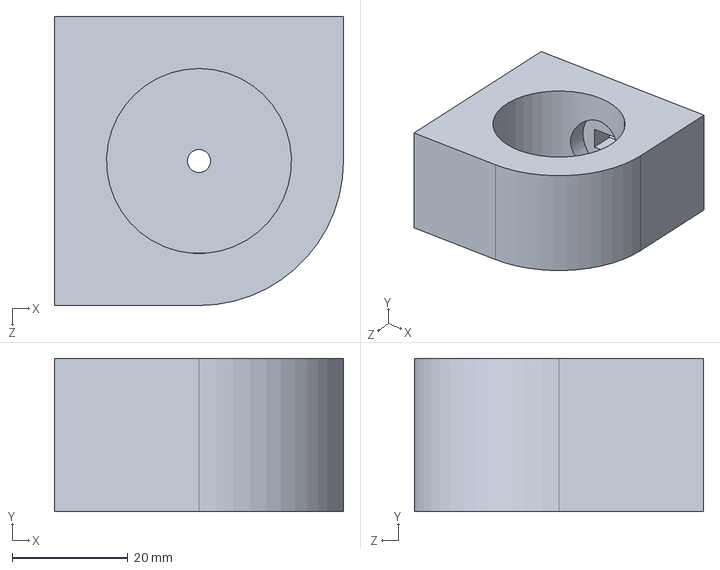
[picture p49: CAD file, 2026-06-23]
Solidworks/CraneArm/ElectromagnetCasing.SLDPRT
50.0 x 26.5 x 50.0 mm
