RandoL26/ENMT301_RoboCup/Solidworks/Electronics/MCUBoard.SLDPRT

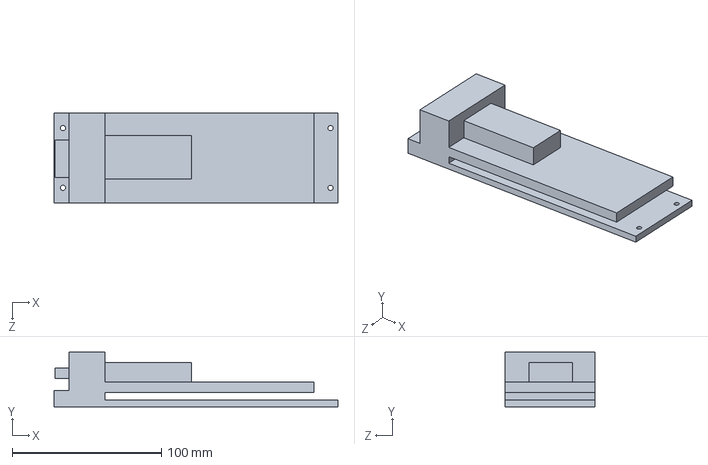
[picture p50: CAD file, 2026-09-19]
Solidworks/Electronics/MCUBoard.SLDPRT
190.0 x 36.5 x 60.0 mm
