RandoL26/ENMT301_RoboCup/Solidworks/Printing/Custom Side Plate.DXF

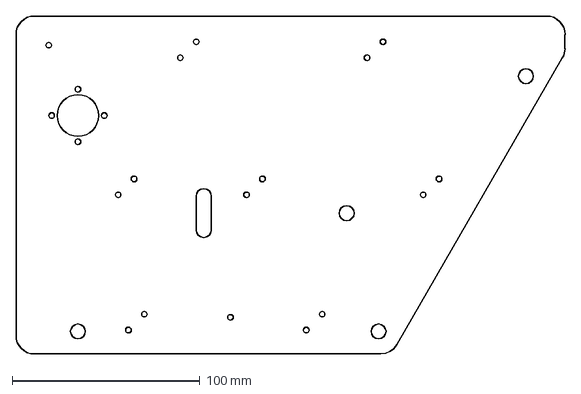
[picture p51: CAD file, 2026-07-19]
Solidworks/Printing/Custom Side Plate.DXF
292.4 x 180.0 mm
