RandoL26/ENMT301_RoboCup/Solidworks/CraneArm/herkulex_motor_sp.SLDPRT

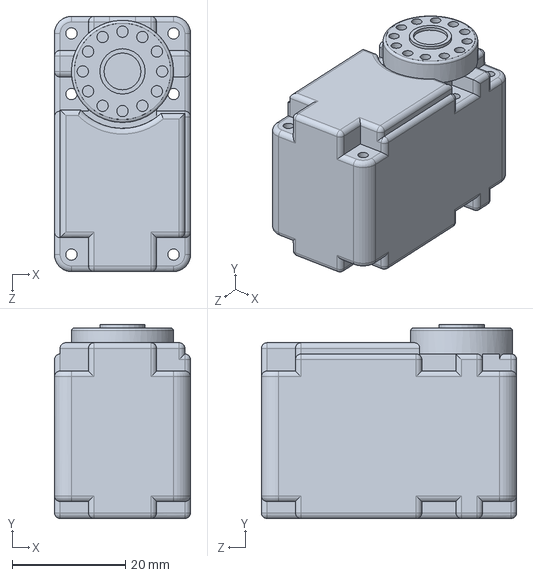
[picture p52: CAD file, 2026-06-23]
Solidworks/CraneArm/herkulex_motor_sp.SLDPRT
24.0 x 34.2 x 45.0 mm
