RandoL26/ENMT301_RoboCup/Solidworks/Electronics/Button Support.SLDPRT

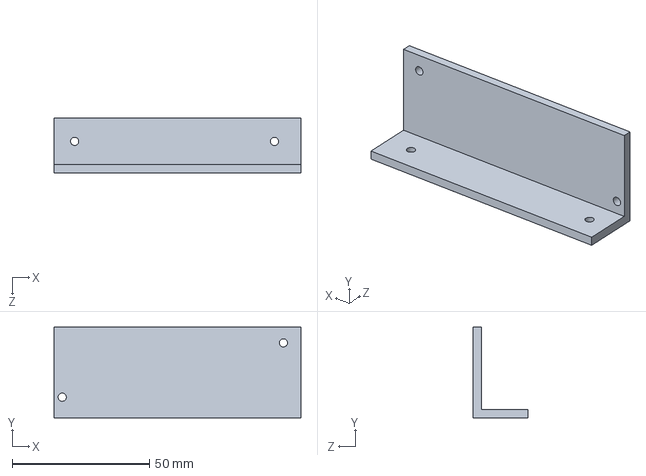
[picture p53: CAD file, 2026-09-19]
Solidworks/Electronics/Button Support.SLDPRT
90.0 x 33.0 x 20.0 mm
