RandoL26/ENMT301_RoboCup/Solidworks/DriveBeltAssembly/FIT0277 Electric Motor_SP.SLDPRT

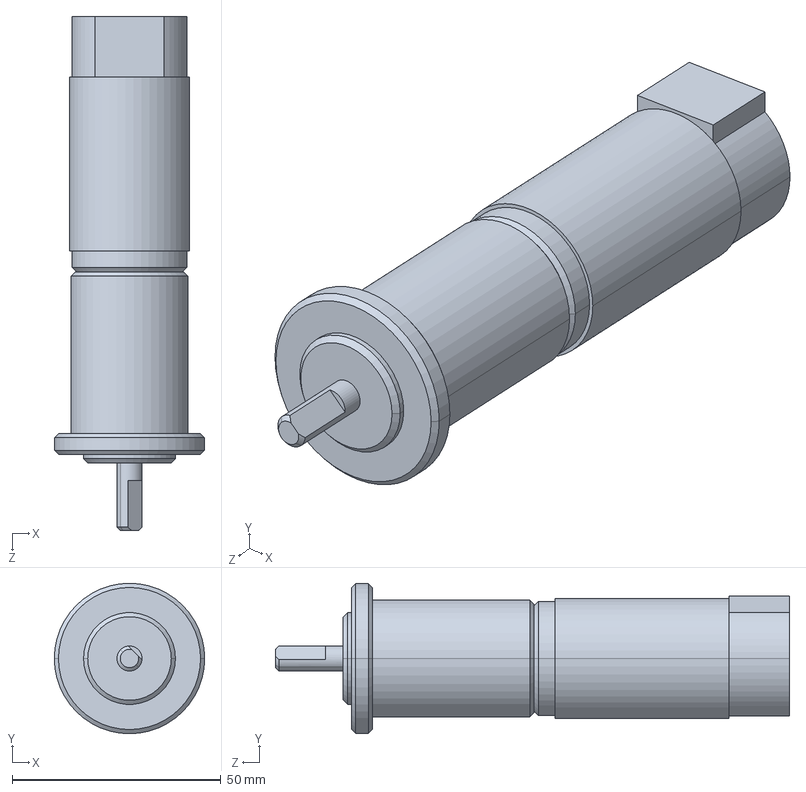
[picture p55: CAD file, 2026-07-10]
Solidworks/DriveBeltAssembly/FIT0277 Electric Motor_SP.SLDPRT
36.0 x 36.0 x 123.0 mm
