RandoL26/ENMT301_RoboCup/Solidworks/Electronics/powerpack.SLDPRT

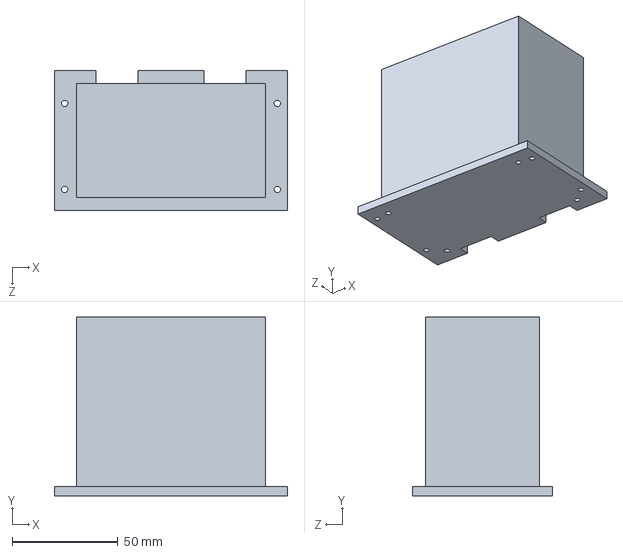
[picture p56: CAD file, 2026-09-19]
Solidworks/Electronics/powerpack.SLDPRT
110.0 x 84.3 x 66.0 mm
