RandoL26/ENMT301_RoboCup/Solidworks/Printing/Custom Chassis Base.DXF

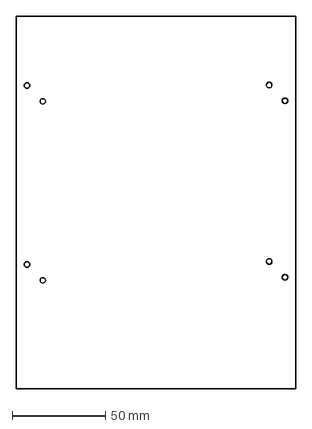
[picture p57: CAD file, 2026-07-19]
Solidworks/Printing/Custom Chassis Base.DXF
150.0 x 200.0 mm
