RandoL26/ENMT301_RoboCup/Solidworks/Electronics/Motor Diver Module.SLDPRT

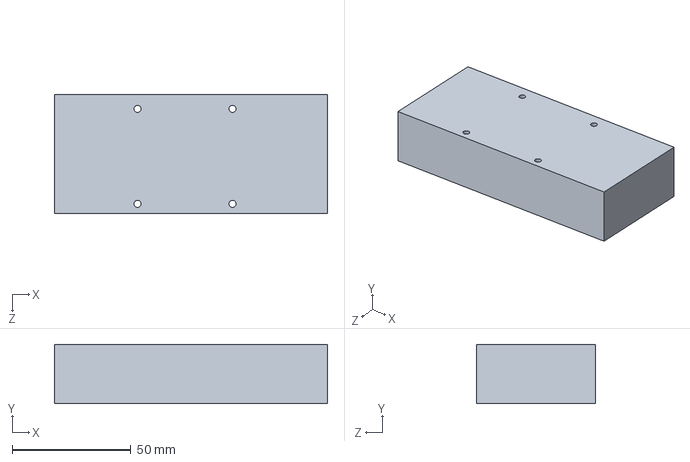
[picture p58: CAD file, 2026-09-19]
Solidworks/Electronics/Motor Diver Module.SLDPRT
115.0 x 25.0 x 50.0 mm
