RandoL26/ENMT301_RoboCup/Solidworks/Printing/ElectromagnetCasing.3MF

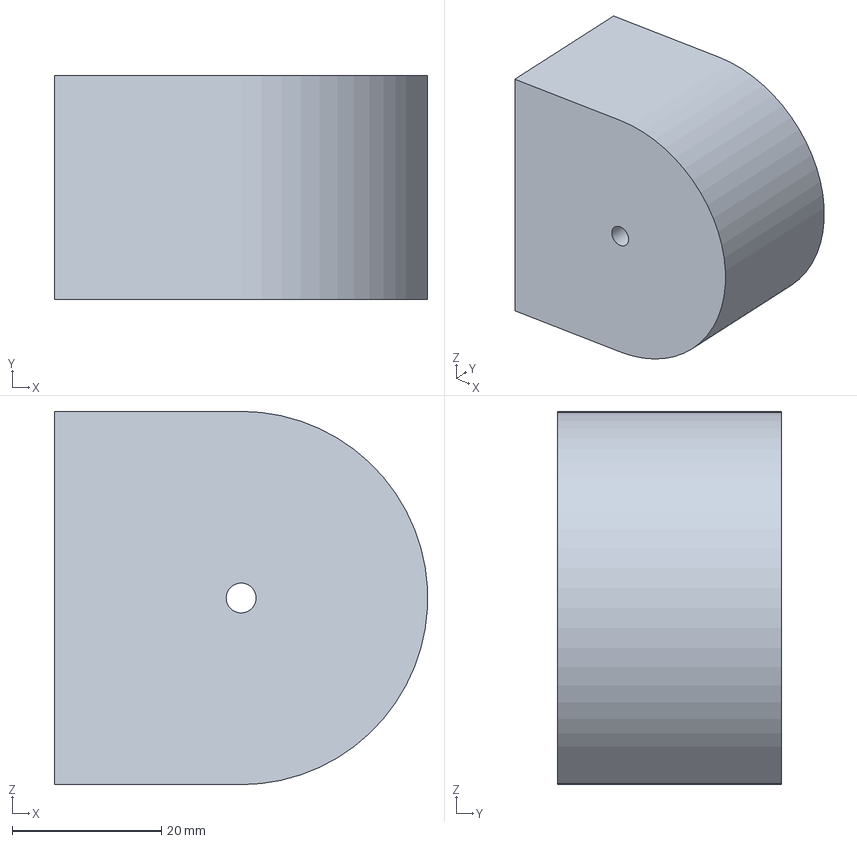
[picture p59: CAD file, 2026-06-23]
Solidworks/Printing/ElectromagnetCasing.3MF
50.0 x 30.0 x 50.0 mm
