RandoL26/ENMT301_RoboCup/Solidworks/DriveBeltAssembly/40-T5-16 timing pulley.SLDPRT

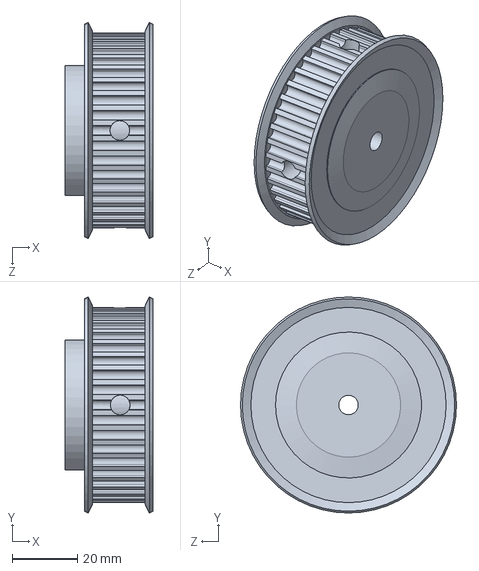
[picture p60: CAD file, 2026-06-23]
Solidworks/DriveBeltAssembly/40-T5-16 timing pulley.SLDPRT
27.0 x 66.3 x 66.3 mm
