RandoL26/ENMT301_RoboCup/Solidworks/Printing/BladeWingV1.3MF

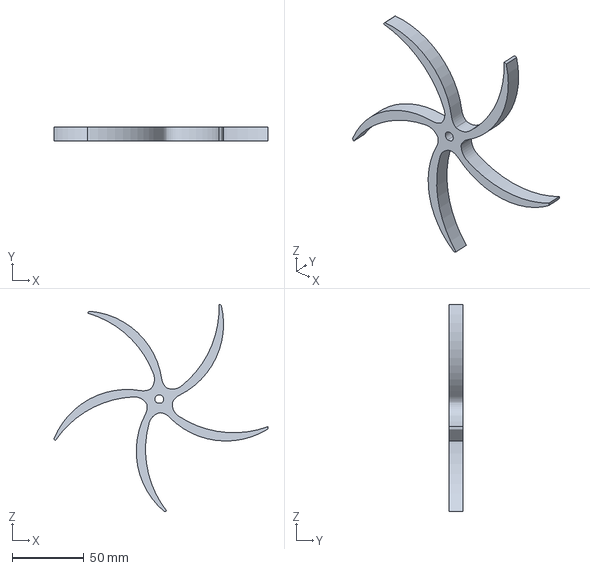
[picture p61: CAD file, 2026-05-20]
Solidworks/Printing/BladeWingV1.3MF
148.8 x 10.0 x 144.0 mm
