RandoL26/ENMT301_RoboCup/Solidworks/Electronics/Encoder.SLDPRT

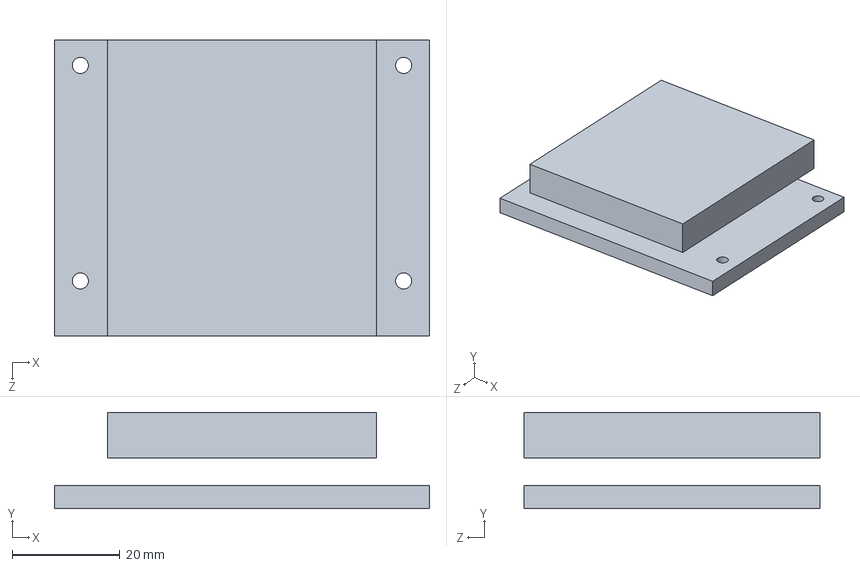
[picture p62: CAD file, 2026-09-19]
Solidworks/Electronics/Encoder.SLDPRT
69.6 x 17.9 x 55.0 mm
