RandoL26/ENMT301_RoboCup/Solidworks/Electronics/Lidar Mount.SLDPRT

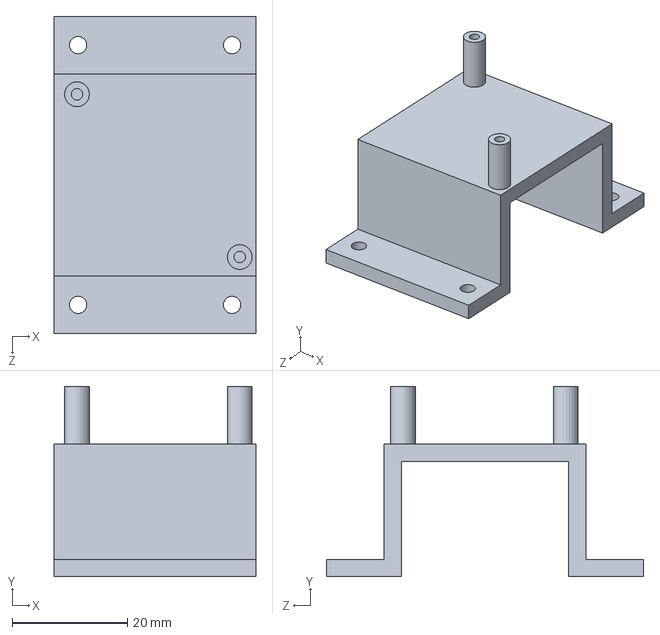
[picture p63: CAD file, 2026-09-16]
Solidworks/Electronics/Lidar Mount.SLDPRT
35.0 x 33.0 x 55.0 mm
