RandoL26/ENMT301_RoboCup/Solidworks/Electronics/switches.SLDPRT

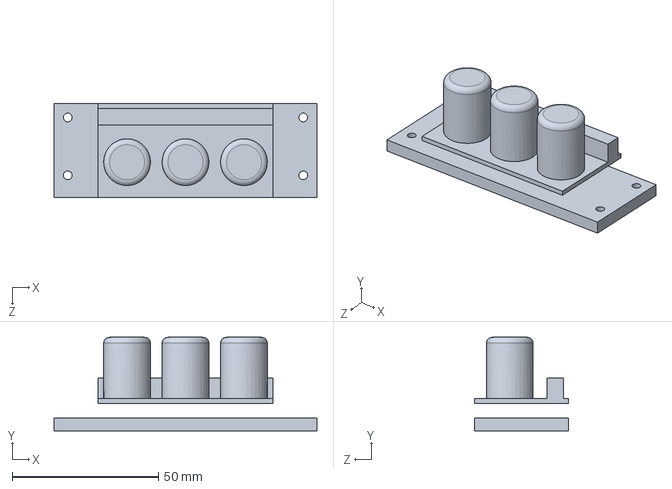
[picture p64: CAD file, 2026-09-16]
Solidworks/Electronics/switches.SLDPRT
90.0 x 32.0 x 32.0 mm
