RandoL26/ENMT301_RoboCup/Solidworks/Electronics/TOF sensor.SLDPRT

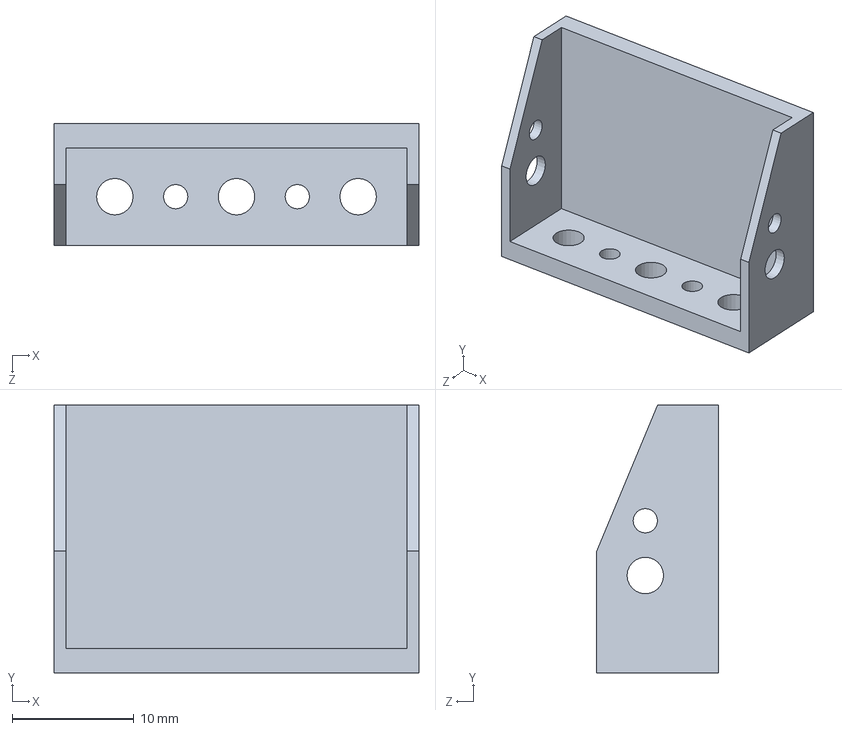
[picture p65: CAD file, 2026-07-28]
Solidworks/Electronics/TOF sensor.SLDPRT
30.0 x 22.0 x 10.0 mm
