RandoL26/ENMT301_RoboCup/Solidworks/Electronics/Inductive Sensor.SLDPRT

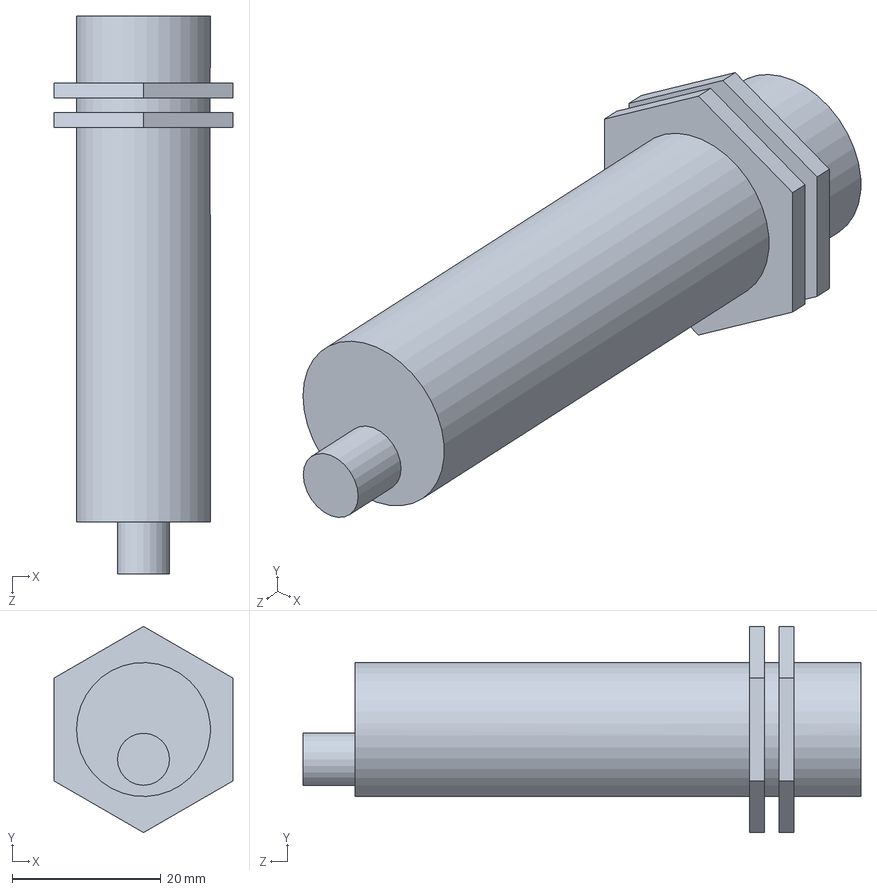
[picture p66: CAD file, 2026-07-16]
Solidworks/Electronics/Inductive Sensor.SLDPRT
24.0 x 27.7 x 75.0 mm
