RandoL26/ENMT301_RoboCup/Solidworks/Electronics/Inductive Sensor Mount.SLDPRT

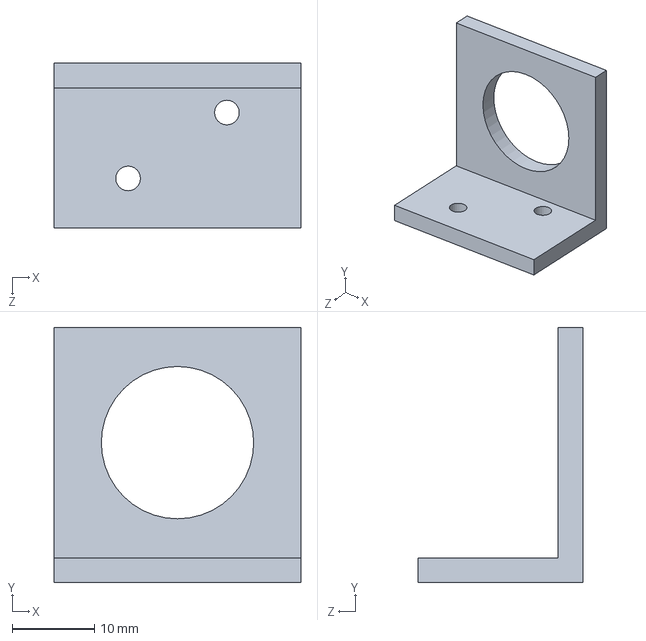
[picture p67: CAD file, 2026-07-16]
Solidworks/Electronics/Inductive Sensor Mount.SLDPRT
30.0 x 31.0 x 20.0 mm
