RandoL26/ENMT301_RoboCup/Solidworks/Electronics/MDF Layer Attachment.SLDPRT

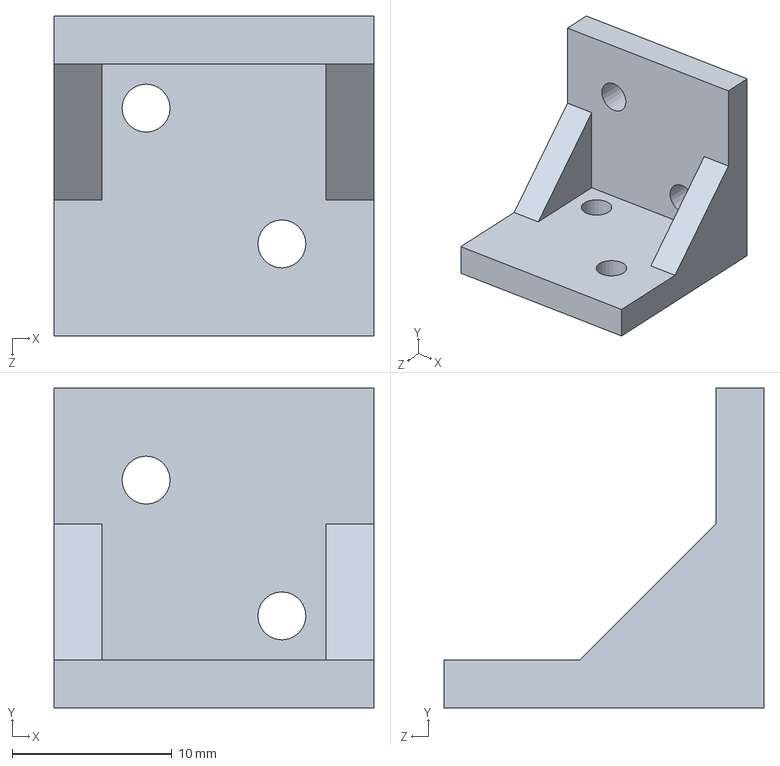
[picture p68: CAD file, 2026-07-15]
Solidworks/Electronics/MDF Layer Attachment.SLDPRT
20.0 x 20.0 x 20.0 mm
