RandoL26/ENMT301_RoboCup/Solidworks/Electronics/MotorDriveBoard.SLDPRT

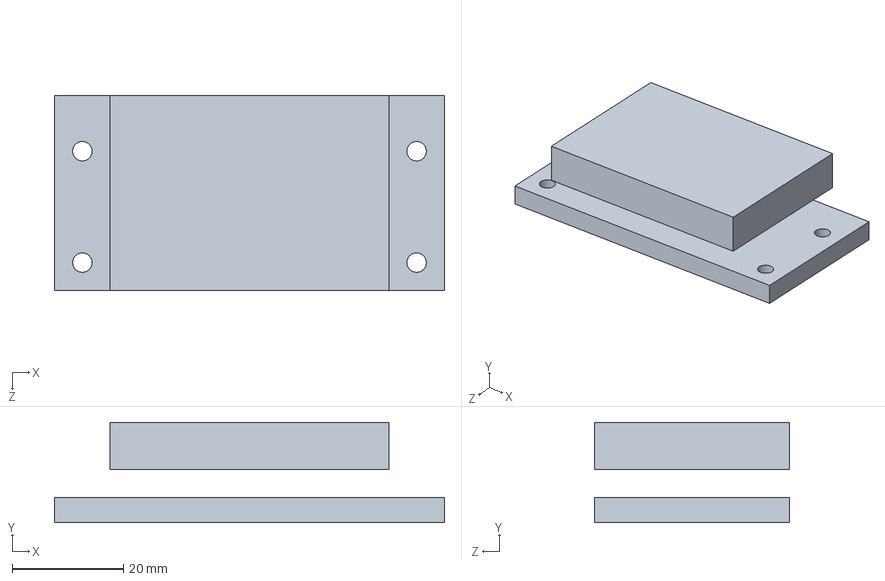
[picture p69: CAD file, 2026-07-13]
Solidworks/Electronics/MotorDriveBoard.SLDPRT
70.0 x 18.0 x 35.0 mm
