RandoL26/ENMT301_RoboCup/Solidworks/CraneArm/CraneAssembly.SLDASM

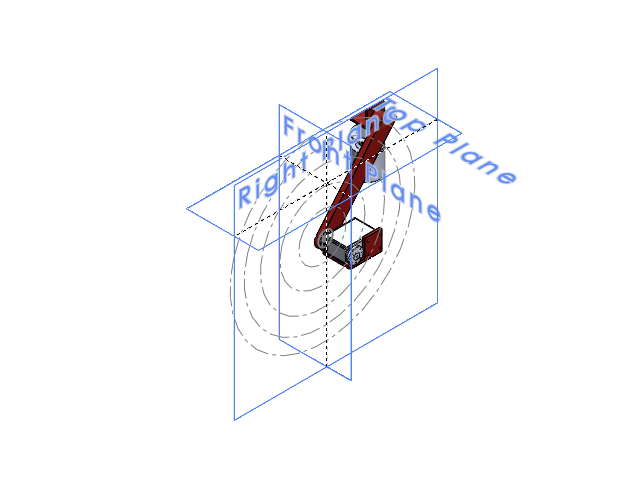
[picture p70: CAD file, 2026-09-29]
Solidworks/CraneArm/CraneAssembly.SLDASM
ElectroMagnetCasingV2
Bearing_sp
WeightModel
ElectroMagnet
CraneArm
robot-servo-60-kg-rds5160-1 Electric Motor_SP
60kgServoMount
