RandoL26/ENMT301_RoboCup/Solidworks/DriveBeltAssembly/CustomDriveBeltAssembly.SLDASM

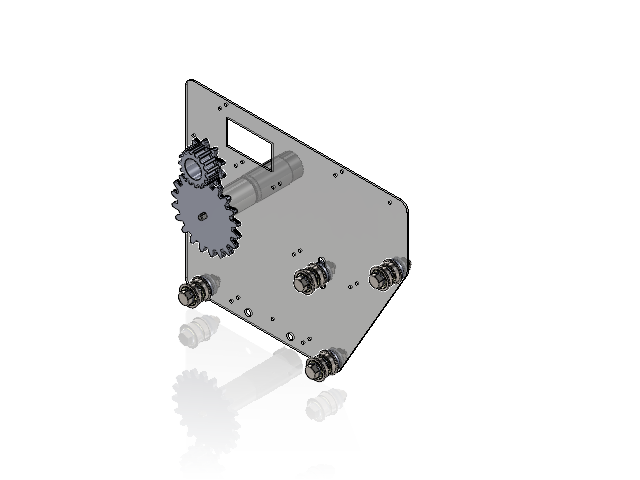
[picture p71: CAD file, 2026-09-29]
Solidworks/DriveBeltAssembly/CustomDriveBeltAssembly.SLDASM
Custom Side Plate
Flanged Bearing F608ZZ_SP x 8
FatWasher x 8
ThinWasher x 20
hex bolt_am x 4
hex nut style 1_am x 4
FIT0277 Electric Motor_SP
20 Teeth Gear 6.25mm bore for motor shaft
10 Teeth Gear 22mm bearing, drivebelt meshing
Bearing
