RandoL26/ENMT301_RoboCup/Solidworks/DriveTrack/DriveTrackBearingAssembly.SLDASM

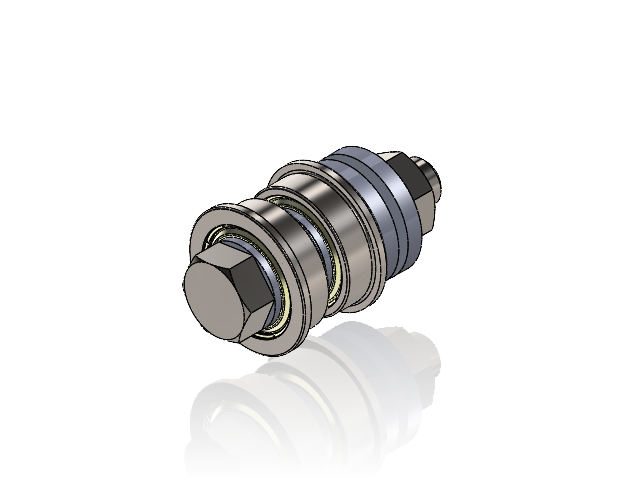
[picture p72: CAD file, 2026-09-29]
Solidworks/DriveTrack/DriveTrackBearingAssembly.SLDASM
Flanged Bearing F608ZZ_SP x 2
FatWasher x 2
ThinWasher x 5
hex bolt_am
hex nut style 1_am
