RandoL26/ENMT301_RoboCup/Solidworks/Electronics/ElectronicsAssembly.SLDASM

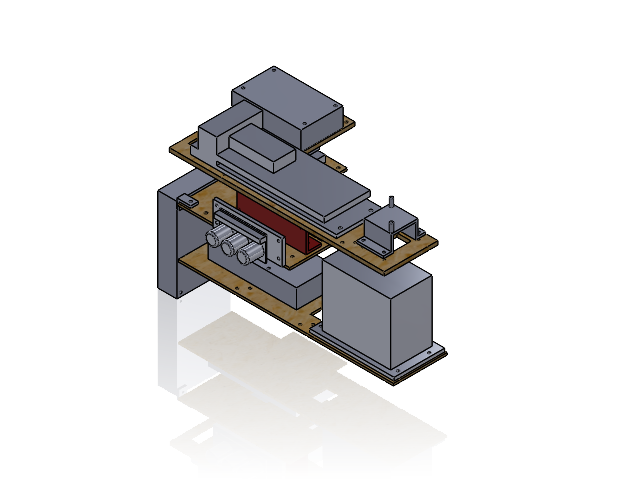
[picture p73: CAD file, 2026-09-29]
Solidworks/Electronics/ElectronicsAssembly.SLDASM
Electronics Bay
powerpack
Electronics Bay Upper
MCUBoard
switches
Encoder
Lidar Mount
Button Support
new upper upper electronics bay
Motor Diver Module
inductive level shift
serial level shift
IMU
InductorShiftMount Straight x 2
