RandoL26/ENMT301_RoboCup/Solidworks/Weight Rejection/wieghtguideassembly.SLDASM

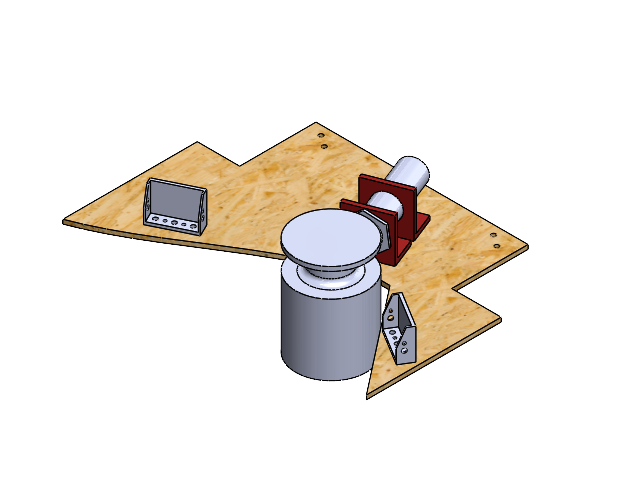
[picture p74: CAD file, 2026-08-13]
Solidworks/Weight Rejection/wieghtguideassembly.SLDASM
MDFWeightGuides
WeightModel
TOF sensor x 2
Inductive Sensor Mount x 2
Inductive Sensor
