RandoL26/ENMT301_RoboCup/Solidworks/MainAssembly/MainAssembly.SLDASM

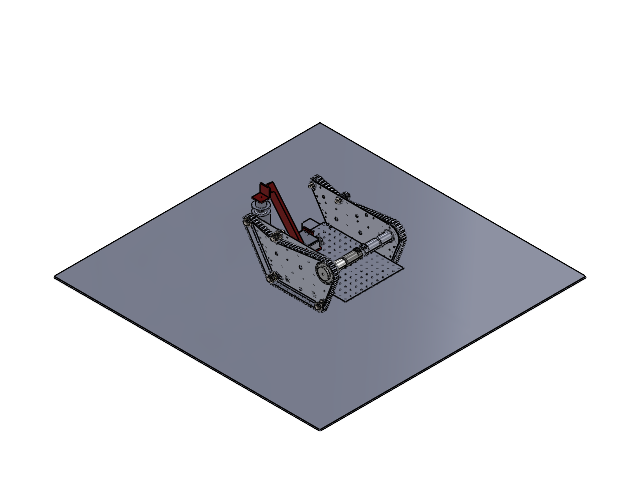
[picture p75: CAD file, 2026-08-02]
Solidworks/MainAssembly/MainAssembly.SLDASM
Robot Side Plate
40-T5-16 timing pulley
FIT0277 Electric Motor_SP
Flanged Bearing F608ZZ_SP x 8
FatWasher x 8
ThinWasher x 20
hex bolt_am x 8
hex nut style 1_am x 8
Belt1-12^DriveBeltAssembly
Robot main chassis support 223.5mm_SP x 2
Top Plate_SP
ElectroMagnetCasingV2
Bearing_sp
WeightModel
ElectroMagnet
CraneArm
robot-servo-60-kg-rds5160-1 Electric Motor_SP
60kgServoMount
Floor
WeightGuides
MirrorRobot Side Plate
Mirror40-T5-16 timing pulley
MirrorFIT0277 Electric Motor_SP
MirrorFlanged Bearing F608ZZ_SP x 8
MirrorFatWasher x 8
MirrorThinWasher x 20
MirrorBelt1-12^MirrorDriveBeltAssembly
