RandoL26/ENMT301_RoboCup/Solidworks/DriveBeltAssembly/CustomDriveBeltAssemblyAlternate.SLDASM

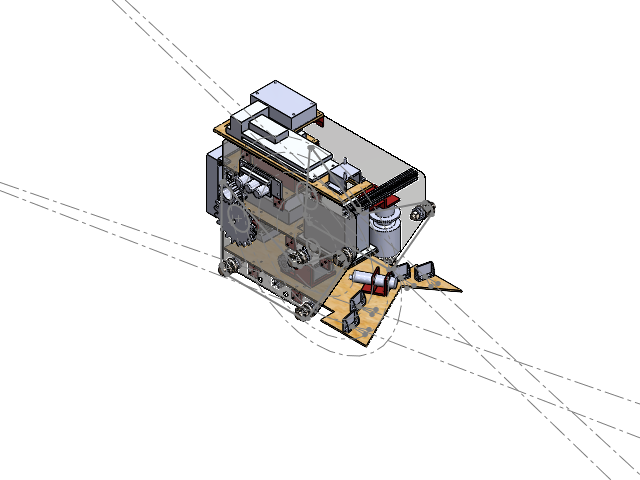
[picture p76: CAD file, 2026-09-29]
Solidworks/DriveBeltAssembly/CustomDriveBeltAssemblyAlternate.SLDASM
Custom Side Plate Flipped
Flanged Bearing F608ZZ_SP x 16
FatWasher x 16
ThinWasher x 40
hex bolt_am x 8
hex nut style 1_am x 8
FIT0277 Electric Motor_SP x 2
Custom Side Plate
20 Teeth Gear 6.25mm bore for motor shaft x 2
10 Teeth Gear 22mm bearing, drivebelt meshing x 2
Bearing x 2
Custom Chassis Base
ElectroMagnetCasingV2
Bearing_sp
WeightModel x 2
ElectroMagnet
CraneArm
robot-servo-60-kg-rds5160-1 Electric Motor_SP
60kgServoMount
Electronics Bay
powerpack
Electronics Bay Upper
MCUBoard
switches
Encoder
Lidar Mount
Button Support
new upper upper electronics bay
Motor Diver Module
inductive level shift
serial level shift
IMU
InductorShiftMount Straight x 2
MDF Layer Attachment x 13
Open Beam Aluminum Profile 150mm_SP x 3
Inductive Sensor Mount x 2
Inductive Sensor
TOF sensor x 4
opticalflow
Opticalflwmount
