RandoL26/ENMT301_RoboCup/Solidworks/DriveBeltAssembly/CustomDriveBeltAssemblyFlipped.SLDASM

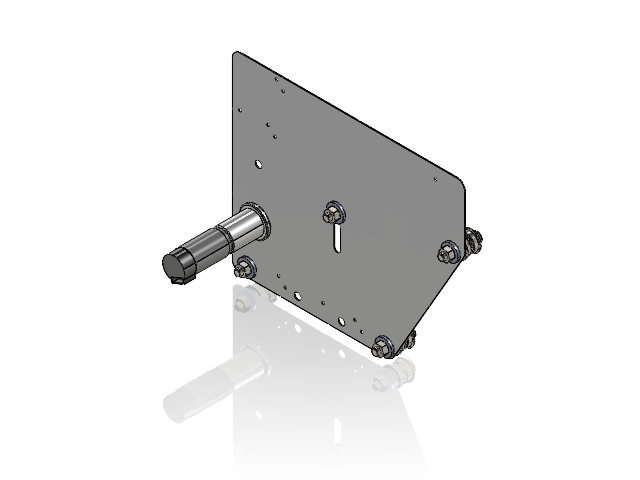
[picture p77: CAD file, 2026-09-29]
Solidworks/DriveBeltAssembly/CustomDriveBeltAssemblyFlipped.SLDASM
Custom Side Plate Flipped
Flanged Bearing F608ZZ_SP x 8
FatWasher x 8
ThinWasher x 20
hex bolt_am x 4
hex nut style 1_am x 4
FIT0277 Electric Motor_SP
