RandoL26/ENMT301_RoboCup/Solidworks/DriveBeltAssembly/DriveBeltAssembly.SLDASM

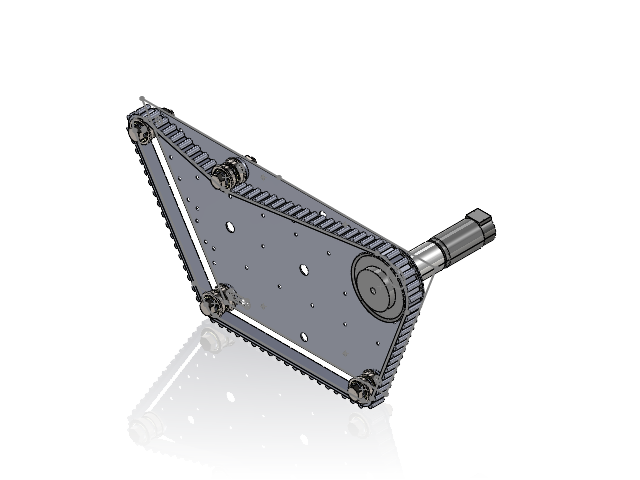
[picture p78: CAD file, 2026-08-02]
Solidworks/DriveBeltAssembly/DriveBeltAssembly.SLDASM
Robot Side Plate
40-T5-16 timing pulley
FIT0277 Electric Motor_SP
Flanged Bearing F608ZZ_SP x 8
FatWasher x 8
ThinWasher x 20
hex bolt_am x 4
hex nut style 1_am x 4
Belt1-12^DriveBeltAssembly
