RandoL26/ENMT301_RoboCup/Solidworks/DriveBeltAssembly/CustomDriveBeltAssemblyRaisedCrane.SLDASM

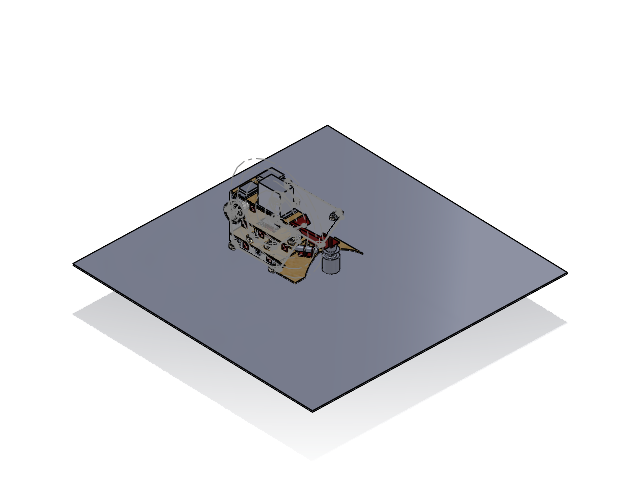
[picture p79: CAD file, 2026-07-28]
Solidworks/DriveBeltAssembly/CustomDriveBeltAssemblyRaisedCrane.SLDASM
Custom Side Plate Flipped
Flanged Bearing F608ZZ_SP x 20
FatWasher x 20
ThinWasher x 50
hex bolt_am x 10
hex nut style 1_am x 10
FIT0277 Electric Motor_SP x 2
40-T5-16 timing pulley x 2
Custom Side Plate
Floor
Custom Chassis Base
ElectroMagnetCasingV2
Bearing_sp
WeightModel x 2
ElectroMagnet
CraneArm
robot-servo-60-kg-rds5160-1 Electric Motor_SP
60kgServoMount
Storage
Electronics Bay
powerpack
Electronics Bay Upper
MotorDriveBoard
Encoder
MDFWeightGuides
MDF Layer Attachment x 10
Open Beam Aluminum Profile 150mm_SP x 2
Inductive Sensor Mount x 2
Inductive Sensor
