RandoL26/ENMT301_RoboCup/Solidworks/Electronics/Inductive Sensor Assembly.SLDASM

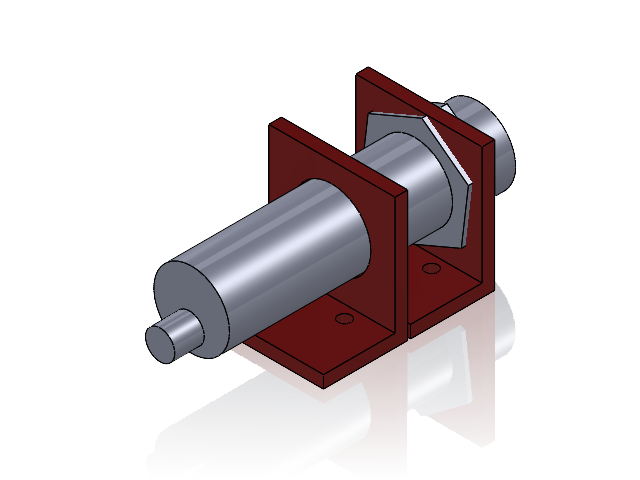
[picture p81: CAD file, 2026-09-19]
Solidworks/Electronics/Inductive Sensor Assembly.SLDASM
Inductive Sensor Mount x 2
Inductive Sensor
