RandoL26/ENMT301_RoboCup/(list of files, cad)

Other CAD files:
Solidworks/DriveTrack/MirrorDriveTrackBearingAssembly3.SLDASM
Solidworks/DriveTrack/MirrorDriveTrackBearingAssembly2.SLDASM
Solidworks/DriveTrack/MirrorDriveTrackBearingAssembly1.SLDASM
Solidworks/DriveTrack/MirrorDriveTrackBearingAssembly.SLDASM
Solidworks/DriveBeltAssembly/MirrorDriveBeltAssembly.SLDASM
Solidworks/Electronics/InductiveshiftmountFlipped.SLDPRT
Solidworks/Robot Top Plate 200mm300mm.SLDPRT
Solidworks/Electronics/InductorShiftMount Straight.SLDPRT
Solidworks/DriveTrack/MirrorFlanged Bearing F608ZZ_SP.SLDPRT
Solidworks/Printing/Drive wheelV1.SLDPRT
Solidworks/Printing/26 Teeth Gear 5mm bore for motor shaft.SLDPRT
Solidworks/DriveBeltAssembly/MirrorRobot Side Plate.SLDPRT
Solidworks/CraneArm/Bearing_sp.SLDPRT
Solidworks/Printing/Sensor Mount L.SLDPRT
Solidworks/DriveBeltAssembly/Mirror40-T5-16 timing pulley.SLDPRT
Solidworks/DriveBeltAssembly/MirrorFIT0277 Electric Motor_SP.SLDPRT
Solidworks/Electronics/Electronics Bay Even more upper.SLDPRT
Solidworks/Printing/RotationalBearingM5TestPeice.3MF
Solidworks/CraneArm/CraneArm.3MF
Solidworks/CraneArm/ElectroMagnetCasingV2.SLDPRT
Solidworks/Drawings/CraneArm.SLDDRW
Solidworks/Drawings/Custom Side Plate.SLDDRW
Solidworks/Drawings/Electronics Bay Upper.SLDDRW
Solidworks/DriveTrack/FatWasher.SLDPRT
Solidworks/DriveTrack/MirrorFatWasher.SLDPRT
Solidworks/DriveTrack/MirrorThinWasher.SLDPRT
Solidworks/DriveTrack/ThinWasher.SLDPRT
Solidworks/Electronics/new upper upper electronics bay.DXF
Solidworks/Printing/10 Teeth Gear 22mm bearing, drivebelt meshing.STL
Solidworks/Printing/13 Teeth Gear on 22mm bearing improvement on the drivewheel meshing.STL
Solidworks/Printing/20 Teeth Gear 6.25mm bore for motor shaft.STL
Solidworks/Printing/26 Teeth Gear 6.25mm bore for motor shaft.STL
Solidworks/Printing/Drive wheelV1.STL
Solidworks/Printing/DrivewheelDraft1.STL
