RandoL26/ENMT301_RoboCup/src/robocup_template.ino

/********************************************************************************
 *                               ROBOCUP TEMPLATE                              
 *        
 *  
 *  This is a template program design with modules for 
 *  different components of the robot, and a task scheduler
 *  for controlling how frequently tasks sholud run
 *  
 *  
 *  written by: Logan Chatfield, Ben Fortune, Lachlan McKenzie, Jake Campbell
 *  
 ******************************************************************************/

#include <Servo.h>                  //control the DC motors
// Herkulex support removed
#include <Adafruit_TCS34725.h>      //colour sensor
#include <Wire.h>                   //for I2C and SPI
#include <TaskScheduler.h>          //scheduler
#include <VL53L1X.h>                //VL53L1X distance sensor
#include <stdarg.h>                 //for va_list in printf functions
#include <stdio.h>                  //for vsnprintf
#include <string.h>                 //for strcmp/sscanf parsing
#include <stdbool.h>
#include "BNO055_support.h"         //IMU sensor 

// Custom headers
#include "motors.h"
#include "imu_sensor.h"
#include "weight_collection.h"
#include "return_to_base.h"
#include "proximity_sensor.h"       //inductive proximity sensor
#include "ultrasonic_sensor.h"      //ultrasonic distance sensor
#include "ultrasonic_sensor_array.h" //ultrasonic sensor array (multiple sensors)
#include "color_sensor.h"           //colour sensor module
#include "ir_xy_position.h"         //IR XY position sensor
#include "ir_distance_sensor.h"     //2Y0A02 IR distance sensor
#include "tof_sensor_array.h"       //TOF (VL53L1X) sensor array
#include "TOF_X8.h"                 // DFRobot 8x8 matrix ToF lidar
#include "dc_motor.h"               //DC motor control 
#include "motor_control.h"          //PID/SYNC command handling
#include "ch9143_bluetooth.h"       //CH9143 Bluetooth module
#include "optical_flow.h"           // PMW3901 optical flow (Bitcraze)
#include "ld06.h"                   // LD06 LiDAR
#include "BigServo.h"               // Big servo
#include "RoboSLAM.h"
#include "POIDetector.h"             // ToF-based POI/weight detection
#include "ToFCoverageMap.h"          // ToF coverage tracking
#include "ToFSearchPlanner.h"        // Search target generation
#include "ToFGeometry.h"             // Shared ToF sensor geometry
#include "telemetry.h"
#include "target_detector.h"

// Debug printouts

#ifndef TELEMETRY_ALLOW_ASCII_TELEPLOT
#define TELEMETRY_ALLOW_ASCII_TELEPLOT 0
#endif

#define OPTICAL_FLOW_DEBUG 0

#define TOF_DEBUG 1

#define PROXIMITY_DEBUG 0

#define DCMOTOR_DEBUG 0

#define LOCALISATION_DEBUG 0

#define OPTICAL_FLOW_SERIAL_TEST 0

//**********************************************************************************
// Local Definitions
//**********************************************************************************

// Task period Definitions
// ALL OF THESE VALUES WILL NEED TO BE SET TO SOMETHING USEFUL !!!!!!!!!!!!!!!!!!!!
#define US_READ_TASK_PERIOD                 40
#define IR_READ_TASK_PERIOD                 40
#define COLOUR_READ_TASK_PERIOD             40
#define IMU_READ_TASK_PERIOD                10
#define SENSOR_AVERAGE_PERIOD               40
#define SET_MOTOR_TASK_PERIOD               40
#define WEIGHT_SCAN_TASK_PERIOD             40
#define COLLECT_WEIGHT_TASK_PERIOD          40
#define RETURN_TO_BASE_TASK_PERIOD          40
#define DETECT_BASE_TASK_PERIOD             40
#define UNLOAD_WEIGHTS_TASK_PERIOD          40
#define CHECK_WATCHDOG_TASK_PERIOD          40
#define VICTORY_DANCE_TASK_PERIOD           40
#define PROXIMITY_SENSOR_READ_PERIOD        40
#define ULTRASONIC_SENSOR_READ_PERIOD       100
#define VL53L1X_SENSOR_READ_PERIOD          100
#define IR_DISTANCE_SENSOR_READ_PERIOD      50
#define DC_MOTOR_CONTROL_PERIOD             40
#define BIG_SERVO_PERIOD                    100


#define OF_READ_TASK_PERIOD                 40
#define OF_READ_TASK_NUM_EXECUTE            -1

#define LD06_READ_TASK_PERIOD               1
#define LD06_READ_TASK_NUM_EXECUTE          -1

#define POSE_PREDICTION_PERIOD               10
#define POSE_PREDICTION_NUM_EXECUTE          -1

#define POI_DETECTOR_UPDATE_PERIOD          100  // 10 Hz: process ToF readings
#define POI_DETECTOR_UPDATE_NUM_EXECUTE     -1

#define TOF_SEARCH_PLANNER_PERIOD           500  // 2 Hz: generate search targets less frequently
#define TOF_SEARCH_PLANNER_NUM_EXECUTE      -1

// Herkulex test period removed




// Task execution amount definitions
// -1 means indefinitely
#define US_READ_TASK_NUM_EXECUTE           -1
#define IR_READ_TASK_NUM_EXECUTE           -1
#define COLOUR_READ_TASK_NUM_EXECUTE       -1
#define IMU_READ_TASK_NUM_EXECUTE          -1
#define SENSOR_AVERAGE_NUM_EXECUTE         -1
#define SET_MOTOR_TASK_NUM_EXECUTE         -1
#define WEIGHT_SCAN_TASK_NUM_EXECUTE       -1
#define COLLECT_WEIGHT_TASK_NUM_EXECUTE    -1
#define RETURN_TO_BASE_TASK_NUM_EXECUTE    -1
#define DETECT_BASE_TASK_NUM_EXECUTE       -1
#define UNLOAD_WEIGHTS_TASK_NUM_EXECUTE    -1
#define CHECK_WATCHDOG_TASK_NUM_EXECUTE    -1
#define VICTORY_DANCE_TASK_NUM_EXECUTE     -1
#define PROXIMITY_SENSOR_NUM_EXECUTE        -1
#define ULTRASONIC_SENSOR_NUM_EXECUTE       -1
#define VL53L1X_SENSOR_NUM_EXECUTE          -1
#define IR_DISTANCE_SENSOR_NUM_EXECUTE      -1
#define DC_MOTOR_CONTROL_NUM_EXECUTE        -1
#define BIG_SERVO_NUM_EXECUTE               -1

// Pin deffinitions
#define IO_POWER  49
#define PROXIMITY_SENSOR_PIN  20  // A6Z
// #define ULTRASONIC_TRIGGER_PIN_1  3   // D2Z - Sensor 1 Trigger
// #define ULTRASONIC_ECHO_PIN_1     2   // D3Z - Sensor 1 Echo
// #define ULTRASONIC_TRIGGER_PIN_2  5   // Sensor 2 Trigger (adjust as needed)
// #define ULTRASONIC_ECHO_PIN_2     4   // Sensor 2 Echo (adjust as needed)
#define IR_DISTANCE_SENSOR_PIN    A9  // Analog pin for 2Y0A02 IR distance sensor

// VL53L1X sensor configuration
const uint8_t VL53L1X_SENSOR_COUNT = 4;  // Update this if you add more sensors
const uint8_t VL53L1X_XSHUT_PINS[VL53L1X_SENSOR_COUNT] = {0, 3, 2, 1};  // Update this with the XSHUT pins for each sensor

#define START_BUTTON_PIN 25

// ============================================================
// ROBOT START POSITION
// ============================================================

enum RobotStartSide {
    START_LEFT = 0,
    START_RIGHT = 1
};

// Change this to START_LEFT or START_RIGHT
RobotStartSide robotStartSide = START_LEFT;

// IMPORTANT:
// Replace these with the actual coordinates from your
// RoboCup arena/brief once confirmed.

const float START_LEFT_X_M = 0.55f;
const float START_LEFT_Y_M = 0.51f;
const float START_LEFT_THETA_RAD = 0.0f;

const float START_RIGHT_X_M = 1.95f;
const float START_RIGHT_Y_M = 0.51f;
const float START_RIGHT_THETA_RAD = 0.0f;

// ============================================================
// SENSOR STATUS
// ============================================================

bool telemetry_lidar_ok = false;
bool telemetry_imu_ok = false;
bool telemetry_tof_ok = false;
bool telemetry_optical_flow_ok = false;
bool telemetry_ultrasonic_ok = false;
bool binary_telemetry_active = OPTICAL_FLOW_SERIAL_TEST;


bool robotStarted = false;
// Set true to route USB/Bluetooth MOTOR commands directly to the motor task.
// Leave false to use the autonomous navigator.
bool manual_motor_control_enabled = false;
static bool autonomous_stop_requested = false;
static bool weight_detection_latched = false;
static bool weight_search_forward_requested = false;
static const unsigned long AUTONOMOUS_SCAN_INTERVAL_MS = 10000;
static const float AUTONOMOUS_SCAN_TARGET_RAD = 6.28319f; // One full rotation
static const int16_t AUTONOMOUS_SCAN_SPEED = 28;
static bool autonomous_scan_active = false;
static unsigned long autonomous_last_scan_ms = 0;
static float autonomous_scan_rotation_rad = 0.0f;
static unsigned long autonomous_scan_last_sample_ms = 0;
static unsigned long last_lidar_scan_ms = 0;

bool pickingUp = false;
int collect_time = 0;
// DC Motor PIN definitions
#define DC_M1_PIN 0              //PWM pin for DC motor control (can be extended to 2 motors)
#define DC_M2_PIN 1              //PWM pin for DC motor control (can be extended to 2 motors)
#define DC_M1_ENC_A 2            //Encoder A pin for motor 1 (D2)
#define DC_M1_ENC_B 3            //Encoder B pin for motor 1 (D3)
#define DC_M2_ENC_A 4            //Encoder A pin for motor 2 (D4)
#define DC_M2_ENC_B 5            //Encoder B pin for motor 2 (D5)
#define MOTOR_SPEED 80           // Example motor speed (set to desired value)

//electromagnet PIN definition
#define MAGNET_PIN 26

// Herkulex support removed

// Serial deffinitions
#define BAUD_RATE 115200
#define BLUETOOTH_BAUD 115200  // CH9143 factory default UART baud rate
#define BLUETOOTH_RX_PIN 28  // Serial7 RX
#define BLUETOOTH_TX_PIN 29  // Serial7 TX

Servo right_motor;
Servo left_motor;

// Centralized motor control instance (includes straight-line sync PID)
MotorControl driveMotor(DC_M1_PIN, DC_M1_ENC_A, DC_M1_ENC_B,
                        DC_M2_PIN, DC_M2_ENC_A, DC_M2_ENC_B);

// BNO055 IMU structure
struct bno055_t bno055;

// Global IMU data storage (for inter-task communication)
IMU_Data current_imu_data;
// Initial heading offset (set at IMU init to make headings relative to startup)
float imu_heading_offset = 0.0f;

// Proximity Sensor instance
ProximitySensor proximitySensor(PROXIMITY_SENSOR_PIN);

// Optical flow sensor (PMW3901) using SPI: CS on D10, MOSI D11, MISO D12, SCK D13
OpticalFlow opticalFlow(10);

// LD06 LiDAR on Serial2 (UART @ 230400 configured in ld06.init())
LD06 ld06(Serial2);

// Mapping and on-board SLAM
MappingNav mappingNav;
RoboSLAM roboSlam(mappingNav, driveMotor);

// Ultrasonic Sensor instance (kept for backwards compatibility)
// UltrasonicSensor ultrasonicSensor(ULTRASONIC_TRIGGER_PIN_1, ULTRASONIC_ECHO_PIN_1);

// Ultrasonic Sensor Array for 2 sensors
UltrasonicSensorArray ultrasonicArray(2);

// Color Sensor instance
ColorSensor colorSensor;

// IR XY Position Sensor instance
IRXYPosition irXYSensor;

// IR Distance Sensor instance (2Y0A02)
IRDistanceSensor irDistanceSensor(IR_DISTANCE_SENSOR_PIN);

// TOF Sensor Array instance
TOFSensorArray tofSensorArray(VL53L1X_SENSOR_COUNT);

// ToF sensor indices
constexpr uint8_t TOF_NEAR_A = 0;
constexpr uint8_t TOF_NEAR_B = 1;
constexpr uint8_t TOF_FAR_A  = 2;
constexpr uint8_t TOF_FAR_B  = 3;

TieredTargetDetector targetDetector(
    tofSensorArray,
    ld06,
    TOF_NEAR_A,
    TOF_NEAR_B,
    TOF_FAR_A,
    TOF_FAR_B
);

// POI detection system
POIDetector poiDetector;
ToFCoverageMap tofCoverageMap;
ToFSearchPlanner searchPlanner;
bool target_navigation_active = false;
static bool exploration_goal_needs_update = true;
bool visualiser_path_preview_active = false;

// ToF sensor calibration (MUST BE CALIBRATED FOR YOUR ROBOT)
ToFExtrinsics tof_extrinsics = {0.0f, 0.0f, 0.0f};  // x_offset_m, y_offset_m, yaw_offset_rad

// Additional diagnostic counters for testing
uint32_t optical_flow_update_count = 0;  // Tracks optical flow updates
uint32_t tof_reading_count = 0;          // Tracks ToF readings processed
uint32_t poi_candidate_count = 0;        // Tracks POI candidates created
uint32_t poi_confirmed_count = 0;        // Tracks confirmed POIs

// Note: scan_ready_count, scan_telemetry_call_count, last_scan_point_count are defined in telemetry.cpp

// CH9143 Bluetooth instance
CH9143Bluetooth bluetooth(&Serial7, BLUETOOTH_RX_PIN, BLUETOOTH_TX_PIN, BLUETOOTH_BAUD);

// Motor command state (received from Serial or Bluetooth)
int16_t cmd_left_motor = 0;
int16_t cmd_right_motor = 0;
unsigned long cmd_last_rx_ms = 0;

// Output shaping for smooth motion (applied to all command sources)
// tDC_motor runs every 40 ms, so step 8 ~= 200 speed-units/second.
static int16_t applied_left_motor = 0;
static int16_t applied_right_motor = 0;
static const int16_t MOTOR_SLEW_STEP = 8;

// Forward declarations for command handling
void process_bluetooth_motor_commands(void);
void process_usb_motor_commands(void);
void handle_motor_line(const char* line, Print* ackPort);
int16_t slew_toward(int16_t current, int16_t target, int16_t step);

// Task wrapper for proximity sensor reading
void proximity_sensor_callback(void) {
    proximitySensor.update();
    #if PROXIMITY_DEBUG
    proximitySensor.printStatus();
    #endif
}

// Task wrapper for ultrasonic sensor reading (array with 2 sensors)
void ultrasonic_sensor_callback(void) {
    // The ultrasonic array is not configured in robot_init() yet.
    if (!ultrasonicArray.isInitialized()) {
        static bool warned = false;
        if (!warned) {
            Serial.println("WARNING: Ultrasonic sensor array is not initialized");
            warned = true;
        }
        return;
    }

    TOFSensorArray::TOFData tofData = tofSensorArray.readDistances();

    // Print VL53L1X distances inline
    Serial.print("\t");
    for (uint8_t i = 0; i < tofData.sensorCount; i++) {
        Serial.print("S");
        Serial.print(i);
        Serial.print(":");
        if (tofData.distances[i] == 0xFFFF) {
            Serial.print("TIMEOUT");
        } else {
            Serial.print(tofData.distances[i]);
        }
        if (i < tofData.sensorCount - 1) Serial.print("\t");
    }
}

// Task wrapper for optical flow sensor reading
void optical_flow_callback(void) {
    int16_t dx = 0, dy = 0;
    if (opticalFlow.read(dx, dy)) {
        // Accumulate readings without putting recurring text output on the
        // cooperative scheduler's hot path.
        opticalFlow.addMotionCounts(dx, dy);
        optical_flow_update_count++;  // DIAGNOSTIC
#if OPTICAL_FLOW_SERIAL_TEST
        const float tx = opticalFlow.getTotalXmm();
        const float ty = opticalFlow.getTotalYmm();
        static uint32_t lastPrintMs = 0;
        const uint32_t now = millis();
        if (now - lastPrintMs >= 200) {
            Serial.printf("X=%.2f mm, Y=%.2f mm\n", tx, ty);
            lastPrintMs = now;
        }
#endif
        #if OPTICAL_FLOW_DEBUG
        Serial.printf("OpticalFlow totalX: %.2f mm  totalY: %.2f mm\n",
                    totalX, totalY);
        #endif
        // Update localisation with optical flow
        // localisation.updateOpticalFlow(opticalFlow);
    }
}

// Task wrapper for LD06 LiDAR reading
void ld06_lidar_callback(void) {
    // Read lidar and, when a full scan is ready, emit Teleplot-format points
    bool scanReady = ld06.readScan();
    if (scanReady) {
        // increment diagnostic: readScan() returned true
        scan_ready_count++;
    }
    if (scanReady) {
        last_lidar_scan_ms = millis();
        // Feed on-board RoboSLAM then also emit Teleplot for external tools if needed
        roboSlam.processScan(ld06);
        
        // Diagnostic print: number of points available for telemetry

        // Emit a downsampled scan for the visualizer (non-blocking, small)
        // increment diagnostic: about to call telemetry send
        scan_telemetry_call_count++;
        last_scan_point_count = ld06.getNbPointsInScan();
        telemetry_send_downsampled_scan(ld06, mappingNav, 48);

#if TELEMETRY_ALLOW_ASCII_TELEPLOT
        Serial.print("TELEM SCAN POINTS=");
        Serial.println(ld06.getNbPointsInScan());
        // Keep Teleplot for backwards compatibility
        ld06.printScanTeleplot(Serial);
#endif
    }
}

// Temporary LiDAR coordinate test
void lidar_front_test_callback(void) {
    Serial.println("[TARGET TEST CALLBACK]");
    targetDetector.debugPrint();
}

// Task wrapper for localisation sensor fusion update
// void localisation_update_callback(void) {
//     // Perform sensor fusion (prediction from IMU + flow)
//     localisation.updateFromSensors();
    
//     // Optional: print diagnostics periodically (every 1000 ms)
//     static unsigned long last_diag_print = 0;
//     unsigned long now = millis();
//     if (now - last_diag_print >= 1000) {
//         last_diag_print = now;
        
//         // Print fused localisation state
//         RobotPose pose = localisation.getPose();
//         LocalisationDiags diags = localisation.getDiags();
//         #if LOCALISATION_DEBUG
//         printfBoth("LOCALISATION: x=%.1f mm, y=%.1f mm, theta=%.3f rad | "
//                    "flow: dx=%.1f, dy=%.1f | "
//                    "lidar_match=%u, accepted=%u, frames=%lu\n",
//                    pose.x_mm, pose.y_mm, pose.theta_rad,
//                    diags.flow_dx_mm, diags.flow_dy_mm,
//                    diags.lidar_match_score, diags.lidar_correction_accepted,
//                    diags.frame_count);
//         #endif
//     }
// }
// 100 Hz authoritative pose prediction task
void pose_prediction_callback(void) {
    roboSlam.updatePrediction(current_imu_data, millis());
}

// Task wrapper for VL53L1X sensor reading
void vl53l1x_sensor_callback(void) {
    if (!tofSensorArray.isInitialized()) {
        static bool warned = false;

        if (!warned) {
            Serial.println(
                "WARNING: VL53L1X sensor array not initialized, "
                "no S0-S3 data available"
            );
            warned = true;
        }

        return;
    }

    TOFSensorArray::TOFData tofData =
        tofSensorArray.readDistances();

    #if TOF_DEBUG
    #if TELEMETRY_ALLOW_ASCII_TELEPLOT
    Serial.print("\t");

    for (uint8_t i = 0; i < tofData.sensorCount; i++) {
        Serial.print("S");
        Serial.print(i);
        Serial.print(":");

        if (tofData.distances[i] == 0xFFFF) {
            Serial.print("TIMEOUT");
        } else {
            Serial.print(tofData.distances[i]);
        }

        if (i < tofData.sensorCount - 1) {
            Serial.print("\n");
        }
    }
    #endif
    #endif

    targetDetector.update();

    if (!robotStarted) {
        target_navigation_active = false;
        return;
    }

    const bool target_confirmed = targetDetector.isTargetConfirmed();
    if (!target_confirmed) {
        if (target_navigation_active) {
            exploration_goal_needs_update = true;
        }
        target_navigation_active = false;
        return;
    }

    visualiser_path_preview_active = false;

    if (target_navigation_active) return;

    const TieredTargetDetector::DetectionDebug& detection = targetDetector.getDebug();
    GridPoint target_point;
    if (detection.nearPairMatch && detection.nearAPoint.valid &&
        detection.nearBPoint.valid) {
        target_point.x = 0.5f * (detection.nearAPoint.x + detection.nearBPoint.x);
        target_point.y = 0.5f * (detection.nearAPoint.y + detection.nearBPoint.y);
        target_point.valid = true;
    } else if (detection.farPairMatch && detection.farAPoint.valid &&
               detection.farBPoint.valid) {
        target_point.x = 0.5f * (detection.farAPoint.x + detection.farBPoint.x);
        target_point.y = 0.5f * (detection.farAPoint.y + detection.farBPoint.y);
        target_point.valid = true;
    }

    if (!target_point.valid) return;

    // GridPoint uses +X right and +Y rear; MappingNav's pose uses
    // +X forward and +Y left, with heading measured counter-clockwise.
    const MappingNav::Pose2D pose = mappingNav.getPose();
    const float forward_m = -target_point.y / 1000.0f;
    const float left_m = -target_point.x / 1000.0f;
    const float cos_heading = cosf(pose.theta_rad);
    const float sin_heading = sinf(pose.theta_rad);
    const float goal_x_m = pose.x_m + forward_m * cos_heading - left_m * sin_heading;
    const float goal_y_m = pose.y_m + forward_m * sin_heading + left_m * cos_heading;
    if (mappingNav.setGoalWorld(goal_x_m, goal_y_m)) {
        target_navigation_active = true;
        exploration_goal_needs_update = false;
    }
}

// Task wrapper for POI detector (processes ToF readings)
void poi_detector_callback(void) {
    if (tofSensorArray.isInitialized()) {
        TOFSensorArray::TOFData tofData = tofSensorArray.readDistances();
        tof_reading_count++;  // DIAGNOSTIC
        
        // Get latest ToF reading (assume single sensor for now)
        float tof_distance_m = (tofData.sensorCount > 0) ? (tofData.distances[0] / 1000.0f) : 0.0f;
        
        // Update POI detector with fused pose and occupancy map
        poiDetector.update(mappingNav, tof_distance_m);
        
        // Update ToF coverage map if reading is valid
        if (tof_distance_m > 0.0f) {
            const MappingNav::Pose2D navPose = mappingNav.getPose();
            float sensor_x_m, sensor_y_m, sensor_yaw_rad;
            ToFGeometry::getSensorWorldFrame(navPose, tof_extrinsics,
                                             sensor_x_m, sensor_y_m, sensor_yaw_rad);
            tofCoverageMap.markBeamCovered(sensor_x_m, sensor_y_m, sensor_yaw_rad, tof_distance_m);
        }
    }
}

// Task wrapper for ToF search planner (generates next search target)
void tof_search_planner_callback(void) {
    if (!robotStarted) return;

    if (targetDetector.isTargetConfirmed()) {
        visualiser_path_preview_active = false;
        target_navigation_active = true;
        exploration_goal_needs_update = false;
        return;
    }
    if (target_navigation_active) {
        target_navigation_active = false;
        exploration_goal_needs_update = true;
    }
    if (visualiser_path_preview_active) return;

    // Hold an existing exploration goal until reached or its path is invalid.
    // This avoids needless full-map completion scans and goal changes every
    // planner tick while MappingNav continues bounded replanning in loop().
    if (!exploration_goal_needs_update && mappingNav.getPathLength() > 1) return;

    // Check if search is complete
    if (searchPlanner.isSearchComplete(tofCoverageMap, mappingNav)) {
        // Search complete; no new targets needed
        exploration_goal_needs_update = false;
        return;
    }
    
    // Generate candidate poses from MappingNav, the authoritative pose.
    const uint16_t MAX_CANDIDATES = 30;
    SearchCandidate candidates[MAX_CANDIDATES];
    
    MappingNav::Pose2D current_pose = mappingNav.getPose();
    
    uint16_t candidate_count = searchPlanner.generateCandidates(
        current_pose, tofCoverageMap, mappingNav, candidates, MAX_CANDIDATES);
    
    // Prefer planner candidates whose destination is still uncovered and
    // traversable. A tiny random tie-break avoids repeating the same route.
    int16_t best_idx = -1;
    float best_score = -1.0e9f;
    for (uint16_t i = 0; i < candidate_count; ++i) {
        const uint16_t cell_x = (uint16_t)(candidates[i].x_m / MappingNav::CELL_SIZE_M);
        const uint16_t cell_y = (uint16_t)(candidates[i].y_m / MappingNav::CELL_SIZE_M);
        if (cell_x >= MappingNav::GRID_WIDTH || cell_y >= MappingNav::GRID_HEIGHT) continue;
        const uint16_t cell_idx = cell_y * MappingNav::GRID_WIDTH + cell_x;
        if (tofCoverageMap.isCellCovered(cell_idx) ||
            mappingNav.getOccupancy(cell_idx) == MappingNav::OCC_OCCUPIED ||
            !candidates[i].is_useful) continue;

        const float score = candidates[i].utility_score + random(0, 100) * 0.001f;
        if (score > best_score) {
            best_score = score;
            best_idx = (int16_t)i;
        }
    }

    // If local planner candidates do not land on an uncovered cell, make a
    // bounded random search for one. This is at most 32 cell checks per 500 ms.
    if (best_idx < 0) {
        const uint16_t current_x = (uint16_t)(current_pose.x_m / MappingNav::CELL_SIZE_M);
        const uint16_t current_y = (uint16_t)(current_pose.y_m / MappingNav::CELL_SIZE_M);
        uint16_t best_cell = MappingNav::NUM_CELLS;
        float best_distance = 1.0e9f;
        for (uint8_t attempt = 0; attempt < 32; ++attempt) {
            const uint16_t cell_idx = (uint16_t)random(MappingNav::NUM_CELLS);
            if (tofCoverageMap.isCellCovered(cell_idx) ||
                mappingNav.getOccupancy(cell_idx) == MappingNav::OCC_OCCUPIED) continue;
            const uint16_t cell_x = cell_idx % MappingNav::GRID_WIDTH;
            const uint16_t cell_y = cell_idx / MappingNav::GRID_WIDTH;
            const float dx = (float)cell_x - current_x;
            const float dy = (float)cell_y - current_y;
            const float distance_score = dx * dx + dy * dy + random(0, 100) * 0.01f;
            if (distance_score < best_distance) {
                best_distance = distance_score;
                best_cell = cell_idx;
            }
        }
        if (best_cell < MappingNav::NUM_CELLS) {
            const uint16_t cell_x = best_cell % MappingNav::GRID_WIDTH;
            const uint16_t cell_y = best_cell / MappingNav::GRID_WIDTH;
            exploration_goal_needs_update = mappingNav.setGoalWorld(
                (cell_x + 0.5f) * MappingNav::CELL_SIZE_M,
                (cell_y + 0.5f) * MappingNav::CELL_SIZE_M);
        }
        return;
    }
    // Extract best candidate pose
    SearchCandidate &best = candidates[best_idx];
    
    // Issue navigation goal to D* Lite pathfinder
    bool goal_set = mappingNav.setGoalWorld(best.x_m, best.y_m);
    if (!goal_set) {
        // Goal is unreachable or outside arena
        return;
    }
    exploration_goal_needs_update = false;
    
    // For now, just print diagnostics
    #if TELEMETRY_ALLOW_ASCII_TELEPLOT
    Serial.printf("POI_SEARCH: target=(%.2f, %.2f, %.2f) coverage=%.1f%% score=%.0f\n",
                  best.x_m, best.y_m, best.theta_rad,
                  best.new_coverage_percent, best.utility_score);
    #endif
}

// Task wrapper for IR distance sensor reading
void ir_distance_sensor_callback(void) {
    if (irDistanceSensor.isInitialized()) {
        irDistanceSensor.readDistance();
        irDistanceSensor.printDistance();
    }
}

// Task wrapper for IMU reading
void imu_task_callback(void) {
    if (!telemetry_imu_ok) {
        current_imu_data.gyro_valid = false;
        return;
    }

    current_imu_data = read_imu();
    // Print tidy IMU headings (relative to startup) and accelerations
    float heading_rel = current_imu_data.euler_h - imu_heading_offset;
    // Normalize heading to [-180,180]
    while (heading_rel > 180.0f) heading_rel -= 360.0f;
    while (heading_rel <= -180.0f) heading_rel += 360.0f;
    // Compute accel-derived roll/pitch for sanity check
    float ax = current_imu_data.accel_x;
    float ay = current_imu_data.accel_y;
    float az = current_imu_data.accel_z;
    // Prevent division by zero
    float denom = sqrtf(ay*ay + az*az);
    float pitch_acc = 0.0f;
    if (denom > 1e-6f) pitch_acc = atan2f(-ax, denom) * 180.0f / PI;
    float roll_acc = 0.0f;
    if (fabsf(az) > 1e-6f) roll_acc = atan2f(ay, az) * 180.0f / PI;
        // Choose roll/pitch source: use accel-derived values when stationary (|g|-9.81 small)
        float g = sqrtf(ax*ax + ay*ay + az*az);
        const float G = 9.80665f;
        const float G_THRESH = 0.5f; // m/s^2
        float roll_out, pitch_out;
        const char *src = "BNO";
        if (fabsf(g - G) <= G_THRESH) {
            // stationary: accelerometer gives reliable roll/pitch
            roll_out = roll_acc;
            pitch_out = pitch_acc;
            src = "ACC";
        } else {
            roll_out = current_imu_data.euler_r;
            pitch_out = current_imu_data.euler_p;
        }
        // Single-line output: Heading | roll/pitch(source) | accel XYZ
        // printfBoth("Heading: %.2f\xC2\xB0 | R: %.2f\xC2\xB0 P: %.2f\xC2\xB0 (%s) | Accel(m/s^2): %.2f, %.2f, %.2f\n",
        //                      heading_rel,
        //                      roll_out,
        //                      pitch_out,
        //                      src,
        //                      ax, ay, az);
}

// Task wrapper for DC motor control
static bool lidar_blocks_motion(int16_t left_speed, int16_t right_speed) {
    if (left_speed == 0 && right_speed == 0) return false;

    const unsigned long now = millis();
    if (last_lidar_scan_ms == 0 || now - last_lidar_scan_ms > 500) return true;

    const uint16_t point_count = ld06.getNbPointsInScan();
    if (point_count < 24) return true;

    const bool rotating = (left_speed < 0 && right_speed > 0) ||
                          (left_speed > 0 && right_speed < 0);
    const float robot_half_length = 0.5f * MappingNav::ROBOT_LENGTH_M;
    const float robot_half_width = 0.5f * MappingNav::ROBOT_WIDTH_M;
    const float safety_margin = MappingNav::ROBOT_SAFETY_MARGIN_M;

    for (uint16_t i = 0; i < point_count; ++i) {
        const DataPoint *point = ld06.getPoints(i);
        if (!point || point->distance < 50 || point->distance > 4000) continue;

        const float angle_rad = point->angle * PI / 180.0f;
        const float range_m = point->distance * 0.001f;
        // Same LiDAR offset and angle convention used by RoboSLAM::processScan.
        const float obstacle_x = 0.10f + range_m * cosf(angle_rad);
        const float obstacle_y = -0.04f + range_m * sinf(angle_rad);

        if (rotating) {
            // The robot's rotating footprint is bounded by its circumscribed radius.
            const float sweep_radius = sqrtf(obstacle_x * obstacle_x +
                                             obstacle_y * obstacle_y);
            const float robot_radius = sqrtf(robot_half_length * robot_half_length +
                                             robot_half_width * robot_half_width) +
                                       safety_margin;
            if (sweep_radius < robot_radius) return true;
        } else if (left_speed + right_speed >= 0) {
            // Forward corridor includes the robot footprint and braking clearance.
            if (obstacle_x >= -robot_half_length - safety_margin &&
                obstacle_x <= robot_half_length + 0.20f &&
                fabsf(obstacle_y) <= robot_half_width + 0.08f) return true;
        } else {
            // Apply the same clearance behind the robot for reverse commands.
            if (obstacle_x <= robot_half_length + safety_margin &&
                obstacle_x >= -robot_half_length - 0.20f &&
                fabsf(obstacle_y) <= robot_half_width + 0.08f) return true;
        }
    }

    return false;
}

void dc_motor_callback(void) {
    if (!robotStarted || autonomous_stop_requested) {
        cmd_left_motor = 0;
        cmd_right_motor = 0;
        applied_left_motor = 0;
        applied_right_motor = 0;
        driveMotor.setSpeeds(0, 0);
        return;
    }

    // Hold position while the existing non-blocking servo pickup task runs.
    if (pickingUp) {
        autonomous_scan_active = false;
        autonomous_last_scan_ms = millis();
        cmd_left_motor = 0;
        cmd_right_motor = 0;
        applied_left_motor = 0;
        applied_right_motor = 0;
        driveMotor.stop();
        return;
    }

    int16_t left_target = 0;
    int16_t right_target = 0;

    if (manual_motor_control_enabled) {
        autonomous_scan_active = false;
        left_target = cmd_left_motor;
        right_target = cmd_right_motor;
    } else {
        const unsigned long now = millis();
        const MappingNav::Pose2D pose = mappingNav.getPose();

        if (targetDetector.isTargetConfirmed()) {
            visualiser_path_preview_active = false;
            target_navigation_active = true;
        }

        // Do not begin or continue a blind in-place scan without gyro feedback.
        // Resume straight/path motion instead of rotating indefinitely.
        if (autonomous_scan_active && !current_imu_data.gyro_valid) {
            autonomous_scan_active = false;
            autonomous_last_scan_ms = now;
        }

        if (visualiser_path_preview_active && !target_navigation_active &&
            !autonomous_scan_active &&
            now - autonomous_last_scan_ms < AUTONOMOUS_SCAN_INTERVAL_MS) {
            autonomous_scan_active = false;
        } else if (current_imu_data.gyro_valid &&
                   (autonomous_scan_active ||
                    now - autonomous_last_scan_ms >= AUTONOMOUS_SCAN_INTERVAL_MS)) {
            if (!autonomous_scan_active) {
                autonomous_scan_active = true;
                autonomous_scan_rotation_rad = 0.0f;
                autonomous_scan_last_sample_ms = now;
            }

            const unsigned long sample_elapsed_ms = now - autonomous_scan_last_sample_ms;
            if (current_imu_data.gyro_valid && sample_elapsed_ms <= 250) {
                autonomous_scan_rotation_rad += fabsf(
                    OdometryConfig::IMU_YAW_SIGN * current_imu_data.gyro_z *
                    ((float)sample_elapsed_ms / 1000.0f));
            }
            autonomous_scan_last_sample_ms = now;

            if (autonomous_scan_rotation_rad >= AUTONOMOUS_SCAN_TARGET_RAD) {
                // Correct accumulated gyro drift from the BNO055 heading, relative
                // to the designated start orientation, before navigation resumes.
                if (telemetry_imu_ok) {
                    float heading_delta_deg = current_imu_data.euler_h - imu_heading_offset;
                    while (heading_delta_deg > 180.0f) heading_delta_deg -= 360.0f;
                    while (heading_delta_deg < -180.0f) heading_delta_deg += 360.0f;
                    const float start_heading = robotStartSide == START_LEFT
                        ? START_LEFT_THETA_RAD : START_RIGHT_THETA_RAD;
                    const MappingNav::Pose2D corrected_pose = mappingNav.getPose();
                    const float corrected_theta = start_heading -
                        heading_delta_deg * (PI / 180.0f);
                    mappingNav.setPose(corrected_pose.x_m, corrected_pose.y_m,
                                       corrected_theta);
                }
                autonomous_scan_active = false;
                autonomous_last_scan_ms = now;
            } else {
                // Left track backward and right track forward rotates in place.
                left_target = -AUTONOMOUS_SCAN_SPEED;
                right_target = AUTONOMOUS_SCAN_SPEED;
            }
        } else if (weight_search_forward_requested) {
            // Straight weight-search motion is still routed through this
            // callback so slew limiting and the LiDAR interlock remain active.
            left_target = 80;
            right_target = 80;
        } else {
            // Follow a short look-ahead point on the existing MappingNav path.
            MappingNav::CellCoord path[8];
            const uint16_t path_count = mappingNav.getPathCells(path, 8);
            if (path_count > 1) {
                // Follow the planner's route a few cells ahead so turns and
                // obstacle-driven replans affect steering instead of aiming
                // directly at the distant goal.
                const uint16_t lookahead_index = path_count > 4 ? 4 : path_count - 1;
                const MappingNav::CellCoord &lookahead = path[lookahead_index];
                const float goal_x_m = (lookahead.x + 0.5f) * MappingNav::CELL_SIZE_M;
                const float goal_y_m = (lookahead.y + 0.5f) * MappingNav::CELL_SIZE_M;
                const float goal_dx_m = goal_x_m - pose.x_m;
                const float goal_dy_m = goal_y_m - pose.y_m;
                const float goal_distance_m = sqrtf(goal_dx_m * goal_dx_m +
                                                   goal_dy_m * goal_dy_m);
                const float desired_heading = atan2f(goal_y_m - pose.y_m,
                                                     goal_x_m - pose.x_m);
                float heading_error = desired_heading - pose.theta_rad;
                if (heading_error > PI) heading_error -= 2.0f * PI;
                if (heading_error < -PI) heading_error += 2.0f * PI;

                if (fabsf(heading_error) > 0.9f) {
                    const int16_t turn_speed = 26;
                    if (heading_error > 0.0f) {
                        left_target = -turn_speed;
                        right_target = turn_speed;
                    } else {
                        left_target = turn_speed;
                        right_target = -turn_speed;
                    }
                } else {
                    const int16_t forward_speed = (int16_t)constrain(
                        (int)(goal_distance_m * 100.0f), 10, 32);
                    const int16_t correction = (int16_t)constrain(
                        (int)(heading_error * 22.0f), -18, 18);
                    left_target = forward_speed - correction;
                    right_target = forward_speed + correction;
                }
            } else {
                // With no confirmed target, keep exploring if a goal/path is
                // pending, complete, or unavailable. The LiDAR interlock below
                // still stops for stale scans or an obstacle ahead.
                if (!targetDetector.isTargetConfirmed()) {
                    left_target = 80;
                    right_target = 80;
                }
            }
        }
    }

    if (lidar_blocks_motion(left_target, right_target)) {
        cmd_left_motor = 0;
        cmd_right_motor = 0;
        applied_left_motor = 0;
        applied_right_motor = 0;
        driveMotor.stop();
        return;
    }

    // A visualiser goal is only for path preview. Hold the drivetrain stopped
    // until the preview is cleared or a confirmed target takes priority.
    if (!manual_motor_control_enabled && visualiser_path_preview_active &&
        !autonomous_scan_active &&
        !targetDetector.isTargetConfirmed()) {
        autonomous_scan_active = false;
        cmd_left_motor = 0;
        cmd_right_motor = 0;
        applied_left_motor = 0;
        applied_right_motor = 0;
        driveMotor.stop();
        return;
    }

    cmd_left_motor = left_target;
    cmd_right_motor = right_target;

    // Smoothly approach targets to avoid abrupt jumps and harsh reversals.
    // This ensures transitions like full straight -> full left are gradual.
    applied_left_motor = slew_toward(applied_left_motor, left_target, MOTOR_SLEW_STEP);
    applied_right_motor = slew_toward(applied_right_motor, right_target, MOTOR_SLEW_STEP);

    // Latch behavior: hold last commanded speeds until changed
    driveMotor.setSpeeds(applied_left_motor, applied_right_motor);

    // Print encoder counts only when ASCII diagnostics are enabled. The USB
    // serial port otherwise carries framed binary telemetry.
#if TELEMETRY_ALLOW_ASCII_TELEPLOT
    static unsigned long lastEncoderPrintMs = 0;
    const unsigned long encoderPrintPeriodMs = 200;
    unsigned long now = millis();

    #if DCMOTOR_DEBUG
    if (now - lastEncoderPrintMs >= encoderPrintPeriodMs) {
        Serial.print("ENC L:");
        Serial.print(driveMotor.getLeftEncoderPulses());
        Serial.print(" R:");
        Serial.println(driveMotor.getRightEncoderPulses());
        lastEncoderPrintMs = now;
    }
    #endif 
#endif
}

int16_t slew_toward(int16_t current, int16_t target, int16_t step) {
    if (step <= 0) {
        return target;
    }

    int delta = (int)target - (int)current;
    if (delta > step) {
        delta = step;
    } else if (delta < -step) {
        delta = -step;
    }

    int next = (int)current + delta;
    return (int16_t)constrain(next, -100, 100);
}

// Bluetooth stream test — called every 200 ms by the task scheduler.
// Sends a counter, timestamp, and motor command state so you can verify
// the BT link is live and measure throughput on the remote end.
void bt_stream_test_callback(void) {
    static uint32_t pkt = 0;
    if (!bluetooth.isInitialized()) return;
    bluetooth.printf("PKT:%lu T:%lu L:%d R:%d\n",
        pkt++, millis(), (int)cmd_left_motor, (int)cmd_right_motor);
}

// Read and parse newline-terminated commands from Bluetooth link
void process_bluetooth_motor_commands(void) {
    static char lineBuffer[64];
    static uint8_t idx = 0;

    while (bluetooth.available()) {
        char c = bluetooth.read();

        if (c == '\r') {
            continue;
        }

        if (c == '\n') {
            lineBuffer[idx] = '\0';
            if (idx > 0) {
                handle_motor_line(lineBuffer, bluetooth.isInitialized() ? (Print*)&Serial7 : nullptr);
            }
            idx = 0;
            continue;
        }

        if (idx < (sizeof(lineBuffer) - 1)) {
            lineBuffer[idx++] = c;
        } else {
            // Overflow protection: discard current line
            idx = 0;
        }
    }
}

// Read and parse newline-terminated commands from USB serial monitor
void process_usb_motor_commands(void) {
    static char lineBuffer[64];
    static uint8_t idx = 0;

    while (Serial.available()) {
        char c = (char)Serial.read();

        if (c == '\r') {
            continue;
        }

        if (c == '\n') {
            lineBuffer[idx] = '\0';
            if (idx > 0) {
                handle_motor_line(lineBuffer, &Serial);
            }
            idx = 0;
            continue;
        }

        if (idx < (sizeof(lineBuffer) - 1)) {
            lineBuffer[idx++] = c;
        } else {
            // Overflow protection: discard current line
            idx = 0;
        }
    }
}

// Supported commands:
//   MOTOR <left> <right>           where left/right are in [-100, 100]
//   STOP
//   START                          resume autonomous mode after STOP
//   PID ... / SYNC ...             handled by motor_control.cpp
//   FLOW RESET                     reset accumulated optical-flow totals
//   FLOW STATUS                    print optical-flow totals (mm)
//   FLOW LED <ON|OFF>              enable/disable optical-flow illumination LED
//   FLOW SCALE <mm_per_count>      set millimetres-per-motion-count scale
void handle_motor_line(const char* line, Print* ackPort) {
    // Convert input line to uppercase for case-insensitive command matching
    char upperLine[64];
    strncpy(upperLine, line, sizeof(upperLine) - 1);
    upperLine[sizeof(upperLine) - 1] = '\0';
    for (int i = 0; upperLine[i] != '\0'; i++) {
        upperLine[i] = toupper((unsigned char)upperLine[i]);
    }

    if (strcmp(upperLine, "PREVIEW CLEAR") == 0) {
        visualiser_path_preview_active = false;
        const MappingNav::Pose2D pose = mappingNav.getPose();
        mappingNav.setGoalWorld(pose.x_m, pose.y_m);
        if (ackPort != nullptr) ackPort->println("ACK PREVIEW CLEAR");
        return;
    }

    float preview_x_m = 0.0f;
    float preview_y_m = 0.0f;
    if (sscanf(upperLine, "PREVIEW %f %f", &preview_x_m, &preview_y_m) == 2) {
        if (targetDetector.isTargetConfirmed()) {
            if (ackPort != nullptr) ackPort->println("REJECT PREVIEW TARGET ACTIVE");
            return;
        }
        if (mappingNav.setGoalWorld(preview_x_m, preview_y_m)) {
            target_navigation_active = false;
            visualiser_path_preview_active = true;
            if (ackPort != nullptr) ackPort->println("ACK PREVIEW");
        } else if (ackPort != nullptr) {
            ackPort->println("REJECT PREVIEW OUT OF BOUNDS");
        }
        return;
    }

    if (strcmp(upperLine, "MAP RESET") == 0) {
        mappingNav.reset();
        roboSlam.begin();
        setRobotStartPosition();

        cmd_left_motor = 0;
        cmd_right_motor = 0;
        applied_left_motor = 0;
        applied_right_motor = 0;

        if (ackPort != nullptr) {
            ackPort->println("ACK MAP RESET");
        } else {
            Serial.println("ACK MAP RESET");
        }

        return;
    }

    if (strcmp(upperLine, "STOP") == 0) {
        autonomous_stop_requested = true;
        cmd_left_motor = 0;
        cmd_right_motor = 0;
        applied_left_motor = 0;
        applied_right_motor = 0;
        autonomous_scan_active = false;
        driveMotor.stop();
        if (ackPort != nullptr) ackPort->println("ACK STOP");
        return;
    }

    if (strcmp(upperLine, "START") == 0 || strcmp(upperLine, "AUTO") == 0) {
        autonomous_stop_requested = false;
        robotStarted = true;
        exploration_goal_needs_update = !targetDetector.isTargetConfirmed();
        autonomous_last_scan_ms = millis();
        if (ackPort != nullptr) ackPort->println("ACK AUTO");
        return;
    }

    int left = 0;
    int right = 0;
    printBoth("processing command");
    if (sscanf(upperLine, "MOTOR %d %d", &left, &right) == 2) {
        left = constrain(left, -100, 100);
        right = constrain(right, -100, 100);

        cmd_left_motor = (int16_t)left;
        cmd_right_motor = (int16_t)right;
        cmd_last_rx_ms = millis();
        printBoth("sent command");
        if (ackPort != nullptr) {
            ackPort->print("ACK MOTOR ");
            ackPort->print(cmd_left_motor);
            ackPort->print(" ");
            ackPort->println(cmd_right_motor);
            printBoth("received command");
        }
        return;
    }

    // Optical flow control commands (FLOW ...)
    if (strncmp(upperLine, "FLOW", 4) == 0) {
        if (strcmp(upperLine, "FLOW RESET") == 0) {
            opticalFlow.resetTotals();
            cmd_last_rx_ms = millis();
            if (ackPort != nullptr) ackPort->println("ACK FLOW RESET");
            else Serial.println("ACK FLOW RESET");
            return;
        }

        if (strcmp(upperLine, "FLOW STATUS") == 0) {
            float tx = opticalFlow.getTotalXmm();
            float ty = opticalFlow.getTotalYmm();
            if (ackPort != nullptr) {
                ackPort->printf("FLOW STATUS X: %.2f mm Y: %.2f mm\n", tx, ty);
            } else {
                Serial.printf("FLOW STATUS X: %.2f mm Y: %.2f mm\n", tx, ty);
            }
            return;
        }

        if (strncmp(upperLine, "FLOW LED ", 9) == 0) {
            if (strcmp(upperLine + 9, "ON") == 0) {
                opticalFlow.setLed(true);
                if (ackPort != nullptr) ackPort->println("ACK FLOW LED ON");
                else Serial.println("ACK FLOW LED ON");
                return;
            }
            if (strcmp(upperLine + 9, "OFF") == 0) {
                opticalFlow.setLed(false);
                if (ackPort != nullptr) ackPort->println("ACK FLOW LED OFF");
                else Serial.println("ACK FLOW LED OFF");
                return;
            }
        }

        float scale = 0.0f;
        if (sscanf(upperLine, "FLOW SCALE %f", &scale) == 1) {
            opticalFlow.setScaleMMPerCount(scale);
            if (ackPort != nullptr) {
                ackPort->print("ACK FLOW SCALE ");
                ackPort->println(scale);
            } else {
                Serial.print("ACK FLOW SCALE ");
                Serial.println(scale);
            }
            return;
        }

        if (ackPort != nullptr) ackPort->println("ERR Unknown FLOW command (RESET, STATUS, LED, SCALE)");
        else Serial.println("ERR Unknown FLOW command (RESET, STATUS, LED, SCALE)");
        return;
    }

    if (motorControlHandleCommandLine(upperLine, ackPort)) {
        return;
    }

    if (ackPort != nullptr) {
        ackPort->println("ERR Unknown command (MOTOR <L> <R>, STOP, PID..., SYNC...)");
    }
}


// int collect_time = 0;
void big_servo_callback() {
    if (!(proximitySensor.isObjectDetected())){
        if (!pickingUp) {
            pickingUp = true;
        }
        
    }
    if (pickingUp) {
        collect_time++;
        collect_weight(collect_time);
        if (collect_time >= 70) {
            pickingUp = false;
            collect_time = 0;
        }
    }
    printBoth("collect_time: ");
    
}
//**********************************************************************************
// Task Scheduler and Tasks
//**********************************************************************************

/* The first value is the period, second is how many times it executes
   (-1 means indefinitely), third one is the callback function */

// Tasks for reading sensors 
Task tRead_ultrasonic(US_READ_TASK_PERIOD,       US_READ_TASK_NUM_EXECUTE,        &read_ultrasonic);
Task tRead_infrared(IR_READ_TASK_PERIOD,         IR_READ_TASK_NUM_EXECUTE,        &read_infrared);
Task tRead_colour(COLOUR_READ_TASK_PERIOD,       COLOUR_READ_TASK_NUM_EXECUTE,    &read_colour);
Task tRead_imu(IMU_READ_TASK_PERIOD,             IMU_READ_TASK_NUM_EXECUTE,       &imu_task_callback);
Task tProximity_sensor(PROXIMITY_SENSOR_READ_PERIOD, PROXIMITY_SENSOR_NUM_EXECUTE,  &proximity_sensor_callback);
Task tUltrasonic_sensor(ULTRASONIC_SENSOR_READ_PERIOD, ULTRASONIC_SENSOR_NUM_EXECUTE, &ultrasonic_sensor_callback);
// Task tColor_sensor(COLOUR_READ_TASK_PERIOD, COLOUR_READ_TASK_NUM_EXECUTE, &color_sensor_callback);
// Task tIR_XY_Position(IR_READ_TASK_PERIOD, IR_READ_TASK_NUM_EXECUTE, &ir_xy_position_callback);
Task tVL53L1X_sensor(VL53L1X_SENSOR_READ_PERIOD, VL53L1X_SENSOR_NUM_EXECUTE, &vl53l1x_sensor_callback);
Task tIR_Distance_sensor(IR_DISTANCE_SENSOR_READ_PERIOD, IR_DISTANCE_SENSOR_NUM_EXECUTE, &ir_distance_sensor_callback);
Task tOpticalFlow(OF_READ_TASK_PERIOD, OF_READ_TASK_NUM_EXECUTE, &optical_flow_callback);
Task tLD06_lidar(LD06_READ_TASK_PERIOD, LD06_READ_TASK_NUM_EXECUTE, &ld06_lidar_callback);
Task tLidarFrontTest(500, -1, &lidar_front_test_callback); // Temporary pls remove
Task tPosePrediction(POSE_PREDICTION_PERIOD, POSE_PREDICTION_NUM_EXECUTE, &pose_prediction_callback);
Task tPOI_Detector(POI_DETECTOR_UPDATE_PERIOD, POI_DETECTOR_UPDATE_NUM_EXECUTE, &poi_detector_callback);
Task tToF_SearchPlanner(TOF_SEARCH_PLANNER_PERIOD, TOF_SEARCH_PLANNER_NUM_EXECUTE, &tof_search_planner_callback);
Task tSensor_average(SENSOR_AVERAGE_PERIOD,      SENSOR_AVERAGE_NUM_EXECUTE,      &sensor_average);
// Herkulex test task removed
Task tBT_stream_test(200, -1, &bt_stream_test_callback);  // Stream test: every 200ms

// Task for DC motor control
Task tDC_motor(DC_MOTOR_CONTROL_PERIOD,          DC_MOTOR_CONTROL_NUM_EXECUTE,    &dc_motor_callback);

// Task to set the motor speeds and direction
Task tSet_motor(SET_MOTOR_TASK_PERIOD,           SET_MOTOR_TASK_NUM_EXECUTE,      &set_motor);

// Tasks to scan for weights and collection upon detection
Task tWeight_scan(WEIGHT_SCAN_TASK_PERIOD,       WEIGHT_SCAN_TASK_NUM_EXECUTE,    &weight_scan);
//Task tCollect_weight(COLLECT_WEIGHT_TASK_PERIOD, COLLECT_WEIGHT_TASK_NUM_EXECUTE, &collect_weight);

// Tasks to search for bases and unload weights
Task tReturn_to_base(RETURN_TO_BASE_TASK_PERIOD, RETURN_TO_BASE_TASK_NUM_EXECUTE, &return_to_base);
Task tDetect_base(DETECT_BASE_TASK_PERIOD,       DETECT_BASE_TASK_NUM_EXECUTE,    &detect_base);
Task tUnload_weights(UNLOAD_WEIGHTS_TASK_PERIOD, UNLOAD_WEIGHTS_TASK_NUM_EXECUTE, &unload_weights);

// Tasks to check the 'watchdog' timer (These will need to be added in)
//Task tCheck_watchdog(CHECK_WATCHDOG_TASK_PERIOD, CHECK_WATCHDOG_TASK_NUM_EXECUTE, &check_watchdog);
//Task tVictory_dance(VICTORY_DANCE_TASK_PERIOD,   VICTORY_DANCE_TASK_NUM_EXECUTE,  &victory_dance);
Task tBig_Servo(BIG_SERVO_PERIOD, BIG_SERVO_NUM_EXECUTE, &big_servo_callback);

Scheduler taskManager;

//**********************************************************************************
// Function Definitions
//**********************************************************************************
void pin_init();
void robot_init();
void task_init();


// Helper functions to stream output to both Serial and Bluetooth
void printBoth(const char* data) {
    if (!binary_telemetry_active || TELEMETRY_ALLOW_ASCII_TELEPLOT) {
        Serial.print(data);
    }
    if (bluetooth.isInitialized()) {
        bluetooth.print(data);
    }
}

void printlnBoth(const char* data) {
    if (!binary_telemetry_active || TELEMETRY_ALLOW_ASCII_TELEPLOT) {
        Serial.println(data);
    }
    if (bluetooth.isInitialized()) {
        bluetooth.println(data);
    }
}

void printfBoth(const char* format, ...) {
    char buffer[256];
    va_list args;
    
    // Once framed telemetry is active, keep diagnostic text off USB Serial.
    if (!binary_telemetry_active || TELEMETRY_ALLOW_ASCII_TELEPLOT) {
        va_start(args, format);
        vsnprintf(buffer, sizeof(buffer), format, args);
        va_end(args);
        Serial.print(buffer);
    }
    
    // Print to Bluetooth
    if (bluetooth.isInitialized()) {
        va_start(args, format);
        vsnprintf(buffer, sizeof(buffer), format, args);
        va_end(args);
        bluetooth.print(buffer);
    }
}

void setRobotStartPosition()
{
    if (robotStartSide == START_LEFT)
    {
        mappingNav.setPose(
            START_LEFT_X_M,
            START_LEFT_Y_M,
            START_LEFT_THETA_RAD
        );

    }
    else
    {
        mappingNav.setPose(
            START_RIGHT_X_M,
            START_RIGHT_Y_M,
            START_RIGHT_THETA_RAD
        );

    }
}

//**********************************************************************************
// put your setup code here, to run once:
//**********************************************************************************
void setup() {
  Serial.begin(BAUD_RATE);
  Serial.println("\n\n=== RoboCup Robot Starting ===");
  
  // CH9143 two-chip bridge architecture:
  //   PC (USB-C) --> CH9143 [USB chip]  ~~~BLE~~~  CH9143 [UART chip] --> Serial7 --> Teensy
  // The UART chip communicates at 115200 (CH9143 factory default).
  // No Bluetooth pairing needed on the PC \u2014 it connects via USB-C to the USB chip.
    // Serial7 is initialized by bluetooth.begin() during robot_init().
  
  Wire.begin();        // MUST be called FIRST - before any I2C operations
  pin_init();
  robot_init();        // robot_init() calls BNO_Init() which needs I2C
  task_init();
  bigServo_setup();
  // Power-on is the start command: do not gate autonomous mode on D25 or IMU
  // telemetry status. RoboSLAM ignores invalid IMU samples and can still use
  // encoder odometry; LiDAR continues to guard every nonzero motor command.
  const unsigned long now = millis();
  cmd_left_motor = 0;
  cmd_right_motor = 0;
  applied_left_motor = 0;
  applied_right_motor = 0;
  target_navigation_active = false;
  exploration_goal_needs_update = true;
  visualiser_path_preview_active = false;
  autonomous_scan_active = false;
  autonomous_last_scan_ms = now;
  autonomous_stop_requested = false;
  robotStarted = true;
  printlnBoth("POWER-ON AUTONOMY STARTED");
  // Now that Bluetooth is initialized, send startup message
  if (bluetooth.isInitialized()) {
    bluetooth.println("Setup Complete");
  }
}

//**********************************************************************************
// Initialise the pins as inputs and outputs (otherwise, they won't work) 
// Set as high or low
//**********************************************************************************
void pin_init(){
    
    printlnBoth("Pins have been initialised \n"); 

    pinMode(IO_POWER, OUTPUT);              //Pin 49 is used to enable IO power
    digitalWrite(IO_POWER, 1);              //Enable IO power on main CPU board
    // Initialise electromagnet pin (analog connector used as digital output)
    pinMode(MAGNET_PIN, OUTPUT);
    digitalWrite(MAGNET_PIN, LOW); // ensure off by default
    printlnBoth("Electromagnet pin initialised\n");
    pinMode(START_BUTTON_PIN, INPUT_PULLUP);
    // Optional startup test pulse; leave the magnet safely off afterward.
    digitalWrite(MAGNET_PIN, HIGH);
    delay(100);
    digitalWrite(MAGNET_PIN, LOW);
}

//**********************************************************************************
// Set default robot state
//**********************************************************************************
void robot_init() {
    printlnBoth("Initialising Proximity Sensor...");
    proximitySensor.begin();
    
    // printlnBoth("Initialising Ultrasonic Sensor Array...");
    // ultrasonicArray.addSensor(0, ULTRASONIC_TRIGGER_PIN_1, ULTRASONIC_ECHO_PIN_1);
    // ultrasonicArray.addSensor(1, ULTRASONIC_TRIGGER_PIN_2, ULTRASONIC_ECHO_PIN_2);
    // ultrasonicArray.begin();
    
    printlnBoth("Initialising Color Sensor...");
    colorSensor.begin();
    
    printlnBoth("Initialising CH9143 Bluetooth...");
    if (bluetooth.begin()) {
        Serial.println("✓ Bluetooth module initialized");
        bluetooth.println("=== Bluetooth Ready ===");
    } else {
        Serial.println("✗ Bluetooth initialization failed!");
    }

    // Herkulex support removed: initialization omitted
    
    // Initialise Herkulex smart servo using a hardware UART (avoids SoftwareSerial)
    // On Teensy/Mega use Serial1 (pins 0/1 on many boards)
    /*
    printlnBoth("Initialising Herkulex Smart Servo on Serial1...");
    Herkulex.begin(115200, HERKULEX_RX_PIN, HERKULEX_TX_PIN);
    delay(100);
    Herkulex.reboot(HERKULEX_ID);
    delay(500);
    Herkulex.clearError(HERKULEX_ID);
    Herkulex.ACK(1);  // Set ACK mode to 1 (ACK on error only)
    Herkulex.set_ID(HERKULEX_ID, HERKULEX_ID);  // Ensure servo ID is set correctly
    Herkulex.torqueON(HERKULEX_ID);
    Herkulex.initialize();

    delay(200);
    printlnBoth("Herkulex Smart Servo initialized\n");
    // Diagnostics: read status, model and position
    int hk_stat = Herkulex.stat(HERKULEX_ID);
    int hk_model = Herkulex.model();
    int hk_pos = Herkulex.getPosition(HERKULEX_ID);
    printfBoth("Herkulex stat: %d | model: %d | position: %d\n", hk_stat, hk_model, hk_pos);

    // If status OK (0) then perform startup test move
    
    printlnBoth("Herkulex startup test move: moving to -100 then 100\n");
    Herkulex.moveOneAngle(HERKULEX_ID, -100, 1000, LED_BLUE);
    delay(1200);
    Herkulex.moveOneAngle(HERKULEX_ID, 100, 1000, LED_GREEN);
    delay(1200);
    printlnBoth("Herkulex test move complete\n");
    */
    
    printlnBoth("Initialising IR XY Position Sensor...");
    irXYSensor.begin();
    
    printlnBoth("Initialising Optical Flow (PMW3901) on SPI CS D10...");
    if (!opticalFlow.begin()) {

    telemetry_optical_flow_ok = false;

    printlnBoth(
        "WARNING: Optical Flow init failed"
    );

    } else {

    telemetry_optical_flow_ok = true;
    opticalFlow.setLed(true);

    printlnBoth(
        "Optical Flow initialized"
    );
    }

    printlnBoth("Initialising LD06 LiDAR on Serial2...");
    ld06.init();

    ld06.enableCRC();
    ld06.enableFullScan();

    telemetry_lidar_ok = true;

    printlnBoth(
        "LD06 LiDAR initialized "
        "(CRC enabled, full-scan enabled)"
    );

    printlnBoth("Initialising IR Distance Sensor (2Y0A02)...");
    irDistanceSensor.begin();
    
    printlnBoth("Initialising TOF (VL53L1X) Sensor Array...");
    Wire.setClock(400000); // use 400 kHz I2C

    // Initialize VL53L1X sensor array.
    printlnBoth("Initialising VL53L1X Sensor Array...");
    tofSensorArray.setXSHUTPins(VL53L1X_XSHUT_PINS, VL53L1X_SENSOR_COUNT);
    
    // Initialize the TOF sensor array
    if (!tofSensorArray.begin()) {

        telemetry_tof_ok = false;

    printlnBoth("WARNING: Failed to initialize TOF sensor array");

    } else {

        telemetry_tof_ok = true;

    printlnBoth("TOF sensor array initialized successfully");
        tofSensorArray.setDistanceOffset(0, 0);   // Sensor 0 offset
        tofSensorArray.setDistanceOffset(1, -35); // Sensor 1 offset
        tofSensorArray.setDistanceOffset(2, 0);  // Sensor 2 offset
        tofSensorArray.setDistanceOffset(3, -5);  // Sensor 3 offset
    }

        TieredTargetDetectorConfig targetConfig;
        targetConfig.nearIntersectMm = 200;
        targetConfig.farIntersectMm = 400;
        targetConfig.intersectionToleranceMm = 50;
        // Map the prior "top sensor" semantics into the new lidar-based
        // config: treat the old clearance/reject-margin as an expected
        // target height and tolerance, and tighten lidar matching accordingly.
        targetConfig.targetHeightMm = 80;
        targetConfig.targetHeightToleranceMm = 40;
        targetConfig.toleratedWidthMm = 50; // tolerated target lateral width (mm)
        // Lidar matching tolerances (how closely a lidar return must match a TOF
        // hit to be considered the same surface / an obstacle)
        targetConfig.maxDetectionRangeMm = 800;
        targetConfig.lidarMatchToleranceMm = 40;
        targetConfig.lidarBearingToleranceDeg = 1.0f;
        targetConfig.useAngleGate = false;

        // Separate LiDAR obstacle required before ToF target tracking can start.
        targetConfig.lidarObstacleMinMm = 80;
        targetConfig.lidarObstacleMaxMm = 700;
        targetConfig.minimumSeparateLidarPoints = 3;
        targetConfig.separateObstacleDistanceMm = 100;
        targetConfig.lidarClusterRadiusMm = 80;
        targetDetector.setConfig(targetConfig);
    
    printlnBoth("Initialising IMU (BNO055)...");
    BNO055_RETURN_FUNCTION_TYPE init_result = BNO_Init(&bno055);
    
    if (init_result == SUCCESS) {
        telemetry_imu_ok = true;
        printlnBoth("IMU initialised successfully");
        delay(500);
        
        // Set operation mode to NDOF (Nine Degrees of Freedom)
        bno055_set_operation_mode(OPERATION_MODE_NDOF);
        delay(50);  // Wait for mode transition
        
        // Calibrate gyroscope to zero on startup
        calibrate_gyroscope();
        // Read IMU once to capture initial fused heading as offset
        delay(100);
        IMU_Data init_imu = read_imu();
        imu_heading_offset = init_imu.euler_h;
        // Print calibration status (0..3 for each: sys, gyro, accel, mag)
        unsigned char sys_cal=0, gyr_cal=0, acc_cal=0, mag_cal=0;
        bno055_get_syscalib_status(&sys_cal);
        bno055_get_gyrocalib_status(&gyr_cal);
        bno055_get_accelcalib_status(&acc_cal);
        bno055_get_magcalib_status(&mag_cal);
        printfBoth("BNO055 calib status - SYS:%u GYR:%u ACC:%u MAG:%u\n", sys_cal, gyr_cal, acc_cal, mag_cal);
        
    } else {

        telemetry_imu_ok = false;

        printfBoth(
            "ERROR: Failed to initialise IMU! Error code: %d\n",
            init_result
        );
    }

    // These systems must be initialized even when the IMU is unavailable:
    // the scheduler still needs a live motor driver and an exploration map.
    // RoboSLAM will use valid encoder deltas and reject invalid IMU samples.
    printlnBoth("Initialising DC Motor...");
    driveMotor.begin();
    roboSlam.begin();
    setRobotStartPosition();

    printlnBoth("Initialising POI Detector...");
    tof_extrinsics.x_offset_m = 0.0f;   // TODO: measure forward offset from robot center
    tof_extrinsics.y_offset_m = 0.0f;   // TODO: measure lateral offset
    tof_extrinsics.yaw_offset_rad = 0.0f;  // TODO: measure sensor yaw angle
    poiDetector.begin(tof_extrinsics);
    tofCoverageMap.begin();
    searchPlanner.begin();

    // Initialize telemetry over USB Serial unless running a text-only sensor test.
#if !OPTICAL_FLOW_SERIAL_TEST
    telemetry_init(Serial);
    binary_telemetry_active = true;
#endif

    printlnBoth("Robot is ready \n");
}

//**********************************************************************************
// Initialise the tasks for the scheduler
//**********************************************************************************
void task_init() {  
  
  // This is a class/library function. Initialise the task scheduler
  taskManager.init();     
 
  // Add tasks to the scheduler
  // taskManager.addTask(tRead_ultrasonic);   //reading ultrasonic 
  // taskManager.addTask(tRead_infrared);
  // taskManager.addTask(tRead_colour);
  taskManager.addTask(tRead_imu);          //reading IMU
    taskManager.addTask(tProximity_sensor);  //reading proximity sensor
    // taskManager.addTask(tUltrasonic_sensor);  //reading ultrasonic sensor
    // taskManager.addTask(tColor_sensor);       //reading color sensor
    // taskManager.addTask(tIR_XY_Position);     //reading IR XY position sensor
    taskManager.addTask(tVL53L1X_sensor);     //reading VL53L1X sensors
    //taskManager.addTask(tIR_Distance_sensor); //reading IR distance sensor (2Y0A02)  
    // taskManager.addTask(tSensor_average);
    taskManager.addTask(tDC_motor);          //DC motor control
    //taskManager.addTask(tSet_motor); 
  // taskManager.addTask(tWeight_scan);
  // taskManager.addTask(tCollect_weight);
  // taskManager.addTask(tReturn_to_base);
  // taskManager.addTask(tDetect_base);
  // taskManager.addTask(tUnload_weights);

  //taskManager.addTask(tCheck_watchdog);
  //taskManager.addTask(tVictory_dance);      

    // taskManager.addTask(tHerkulexTest);
    //taskManager.addTask(tBT_stream_test);  // Disabled for control reliability
    // taskManager.addTask(tOpticalFlow);        //reading optical flow sensor
    // taskManager.addTask(tLD06_lidar);          //reading LD06 lidar
    // taskManager.addTask(tLidarFrontTest); // Disabled to avoid debug spam.
    // taskManager.addTask(tLocalisation);        //sensor fusion localisation update
    // taskManager.addTask(tPosePrediction);
    // taskManager.addTask(tPOI_Detector);        //POI detection from ToF
    // taskManager.addTask(tToF_SearchPlanner);   //search target generation
    taskManager.addTask(tBig_Servo);
    //enable the tasks
//   tRead_ultrasonic.enable();
//   tRead_infrared.enable();
//   tRead_colour.enable();
  tRead_imu.enable();
  tProximity_sensor.enable();
  //tUltrasonic_sensor.enable();
  //tColor_sensor.enable();
  //tIR_XY_Position.enable();
  tVL53L1X_sensor.enable();
//   tIR_Distance_sensor.enable();
//   tSensor_average.enable();
  tDC_motor.enable();
  //tSet_motor.enable();
//   tWeight_scan.enable();
//   tCollect_weight.enable();
//   tReturn_to_base.enable();
//   tDetect_base.enable();
//   tUnload_weights.enable();
  tBig_Servo.enable();
//   tCheck_watchdog.enable();
//   tVictory_dance.enable();
    // Herkulex test task removed
   //tHerkulexTest.enable();
    //tBT_stream_test.enable();  // Disabled for control reliability
    // tOpticalFlow.enable();
    // tLD06_lidar.enable();
    // tLidarFrontTest.enable(); // Disabled to avoid debug spam.
    // tPosePrediction.enable();
    // tPOI_Detector.enable();
    // tToF_SearchPlanner.enable();

 printlnBoth("Tasks have been initialised \n");
}


void send_robot_status_telemetry()
{
    uint8_t start_side;

    if (robotStartSide == START_LEFT)
        start_side = TELEMETRY_START_LEFT;
    else
        start_side = TELEMETRY_START_RIGHT;

    bool goal_set =
        mappingNav.isGoalSet();

    uint16_t goal_cell = 0;

    if (goal_set)
    {
        goal_cell =
            mappingNav.getGoalCellIndex();
    }

    telemetry_send_status(

        start_side,

        telemetry_lidar_ok,
        telemetry_imu_ok,
        telemetry_tof_ok,
        telemetry_optical_flow_ok,
        telemetry_ultrasonic_ok,

        cmd_left_motor,
        cmd_right_motor,

        driveMotor.getMeasuredLeftRPM(),
        driveMotor.getMeasuredRightRPM(),

        goal_set,

        goal_cell,

        mappingNav.getPathLength(),

        robotStarted,
        digitalRead(START_BUTTON_PIN) == HIGH,
        target_navigation_active,
        visualiser_path_preview_active
    );
}
//**********************************************************************************
// put your main code here, to run repeatedly
//**********************************************************************************
void loop() {
    taskManager.execute();

    if (pickingUp) {
        // Big Servo pickup is active → STOP motors
        driveMotor.setSpeeds(0, 0);
    } else {
        // Normal hard-coded movement
        driveMotor.setSpeeds(80, 80);
    }
}
