RandoL26/ENMT301_RoboCup/include/MappingNav.h

//************************************
//         MappingNav.h
//************************************

#ifndef MAPPING_NAV_H_
#define MAPPING_NAV_H_

#include <stdint.h>

class MappingNav {
public:
  // Arena and grid constants
  static const uint16_t GRID_WIDTH = 48;   // 2.4 m / 0.05 m
  static const uint16_t GRID_HEIGHT = 98;  // 4.9 m / 0.05 m
  static const uint16_t NUM_CELLS = GRID_WIDTH * GRID_HEIGHT;
  static constexpr float CELL_SIZE_M = 0.05f;
  static constexpr float ARENA_WIDTH_M = 2.4f;
  static constexpr float ARENA_HEIGHT_M = 4.9f;

  // Robot footprint
  // Change these values if the robot dimensions change.
  static constexpr float ROBOT_LENGTH_M = 0.370f;
  static constexpr float ROBOT_WIDTH_M  = 0.210f;

  // Navigation cost tuning
  // Unknown cells are still traversable, but more expensive.
  static constexpr float UNKNOWN_CELL_COST = 1.50f;

  // Terrain penalties.
  static constexpr float RAMP_COST = 1.10f;
  static constexpr float SPEED_BUMP_COST = 1.05f;

  // Additional clearance around the robot.
  static constexpr float ROBOT_SAFETY_MARGIN_M = 0.030f;

  // LiDAR filtering
  // Change these values to tune the usable LiDAR range.
  static constexpr float LIDAR_MIN_RANGE_M = 0.05f;
  static constexpr float LIDAR_MAX_RANGE_M = 8.0f;

    // LiDAR occupancy confidence
  // Closer returns receive stronger confidence.
  static constexpr float LIDAR_CLOSE_RANGE_M = 1.0f;
  static constexpr int8_t LIDAR_CLOSE_HIT_SCORE = 3;
  static constexpr int8_t LIDAR_FAR_HIT_SCORE = 2;

    // Sensor fusion weights
  static constexpr float IMU_HEADING_WEIGHT = 0.8f;

  // Bit-packed cell format (1 byte/cell)
  // bits 0..1: occupancy, bits 2..3: terrain
  enum Occupancy : uint8_t {
    OCC_UNKNOWN = 0,
    OCC_FREE = 1,
    OCC_OCCUPIED = 2
  };

  enum Terrain : uint8_t {
    TERRAIN_FLAT = 0,
    TERRAIN_RAMP = 1,
    TERRAIN_SPEED_BUMP = 2
  };

  struct Pose2D {
    float x_m;
    float y_m;
    float theta_rad;
  };

  struct CellCoord {
    uint16_t x;
    uint16_t y;
  };

  // Per-cycle differential-drive odometry; distances are metres and angles radians.
  struct PoseUpdateInput {
    float encoder_left_delta_m;
    float encoder_right_delta_m;
    float encoder_dtheta_rad;
    float imu_gyro_dtheta_rad;
    bool encoder_translation_valid;
    bool encoder_heading_valid;
    bool imu_heading_valid;
  };

  enum SensorKind : uint8_t {
    SENSOR_TOF = 0,
    SENSOR_ULTRASONIC = 1,
    SENSOR_LIDAR = 2
  };

  // Generic ray-like range reading.
  // Assumptions:
  // - angle_offset_rad is relative to robot heading (+CCW).
  // - distance_m is along the beam.
  // - has_hit=true means a definite obstacle return at distance_m.
  // - has_hit=false means no return up to max_range_m (free-space only update).
  struct SensorRay {
    bool valid;
    bool has_hit;
    SensorKind kind;

    float angle_offset_rad;
    float distance_m;
    float max_range_m;
  };

  MappingNav();

  void reset();

  void setPose(float x_m, float y_m, float theta_rad);
  Pose2D getPose() const;
  float getPositionUncertaintyM() const;
  float getHeadingUncertaintyRad() const;

  // Encoder distances provide translation; gyro and calibrated wheel geometry
  // provide complementary heading. Optical flow is not part of localisation.
  void updatePose(const PoseUpdateInput &input,
                  float heading_imu_weight = IMU_HEADING_WEIGHT);
  void applyPoseCorrection(float dx_m, float dy_m, float dtheta_rad);
  bool isOccupiedWorld(float x_m, float y_m) const;

  // Occupancy update by ray-casting each reading.
  void updateGridFromSensors(const SensorRay *rays, uint16_t ray_count);

  // Uses known outer walls to reduce drift when a reading agrees with boundary geometry.
  // correction_gain in [0,1], match_tolerance_m is max |expected-measured| for correction.
  void applyBoundaryCorrection(const SensorRay *rays,
                              uint16_t ray_count,
                              float correction_gain = 0.3f,
                              float match_tolerance_m = 0.12f,
                              float lidar_offset_x_m = 0.0f,
                              float lidar_offset_y_m = 0.0f);

  // Terrain flags are separate from occupancy and remain traversable.
  bool setTerrainAtCell(uint16_t cell_x, uint16_t cell_y, Terrain terrain);

  // Goal selection for planner.
  bool setGoalCell(uint16_t goal_x, uint16_t goal_y);
  bool setGoalWorld(float goal_x_m, float goal_y_m);

  // Inflate occupied cells by robot radius, update D* Lite incrementally, and solve.
  // Returns true if a path to goal exists.
  bool replanPath(float robot_radius_m);

  // Path query helpers.
  bool getNextWaypoint(float &x_m, float &y_m) const;
  uint16_t getPathCells(CellCoord *out_cells, uint16_t max_cells) const;

  // Raw map access (1 byte per cell)
  const uint8_t *getGridData() const;

  // Inflated obstacle map.
  // 1 = blocked after robot-radius inflation
  // 0 = traversable
  const uint8_t *getInflatedGridData() const;

  // Planner status
  bool isGoalSet() const;
  uint16_t getGoalCellIndex() const;
  uint16_t getPathLength() const;
  
  // Cell occupancy query (needed for POI detection and search planning)
  Occupancy getOccupancy(uint16_t idx) const;

private:
  // Cell packing helpers
  static const uint8_t OCC_MASK = 0x03;
  static const uint8_t TERRAIN_MASK = 0x0C;

  // D* Lite constants
  static constexpr float INF = 1.0e9f;
  static constexpr float EPS = 1.0e-4f;

  struct Key {
    float k1;
    float k2;
  };

  // Map storage
  uint8_t m_grid[NUM_CELLS];            // occupancy + terrain (1 byte/cell)
  uint8_t m_inflated_blocked[NUM_CELLS]; // 1 if occupied in config-space

  // Occupancy confidence score for each cell.
  // Negative = evidence for free space.
  // Positive = evidence for an obstacle.
  int8_t m_occupancy_score[NUM_CELLS];

  // Pose
  Pose2D m_pose;
  // Qualitative dead-reckoning uncertainty, not a statistical covariance.
  float m_position_uncertainty_m;
  float m_heading_uncertainty_rad;

  // D* Lite state
  float m_g[NUM_CELLS];
  float m_rhs[NUM_CELLS];

  // Fixed-size open set (binary heap with at most one entry per node)
  uint16_t m_open_heap[NUM_CELLS];
  uint16_t m_open_pos[NUM_CELLS]; // 0xFFFF if not in heap
  uint16_t m_open_size;

  bool m_goal_set;
  uint16_t m_start_idx;
  uint16_t m_last_start_idx;
  uint16_t m_goal_idx;
  float m_km;

  // Cached extracted path in cells
  CellCoord m_path[NUM_CELLS];
  uint16_t m_path_len;

  // Coordinate helpers
  static float wrapAngle(float a);
  static float absf(float v);
  static float minf(float a, float b);
  static float maxf(float a, float b);

  bool worldToCell(float x_m, float y_m, uint16_t &cx, uint16_t &cy) const;
  void cellToWorldCenter(uint16_t cx, uint16_t cy, float &x_m, float &y_m) const;
  static uint16_t indexOf(uint16_t cx, uint16_t cy);
  static void coordOf(uint16_t idx, uint16_t &cx, uint16_t &cy);
  bool inBoundsCell(int32_t cx, int32_t cy) const;
  bool inBoundsWorld(float x_m, float y_m) const;

  // Cell read/write helpers (occupancy moved to public section above)
  void setOccupancy(uint16_t idx, Occupancy occ);
  Terrain getTerrain(uint16_t idx) const;
  void setTerrain(uint16_t idx, Terrain terrain);
  void updateOccupancyEvidence(uint16_t idx, int8_t delta);

  // Ray update helpers
  void markRay(float start_x, float start_y,
               float end_x, float end_y,
               bool mark_endpoint_occupied);
  void maybeMarkFree(uint16_t idx);

  // Boundary correction helpers
  bool expectedBoundaryDistance(float ray_origin_x,
                                float ray_origin_y,
                                float ray_angle_global,
                                float &out_dist_m) const;
  // Inflation
  void recomputeInflation(float robot_radius_m);

  // D* Lite helpers
  void plannerInitializeIfNeeded();
  void plannerResetAll();
  void updateStartFromPose();

  Key calculateKey(uint16_t s) const;
  float heuristic(uint16_t a, uint16_t b) const;
  bool keyLess(const Key &a, const Key &b) const;
  bool keyEqual(const Key &a, const Key &b) const;

  void openClear();
  bool openContains(uint16_t s) const;
  void openInsertOrUpdate(uint16_t s);
  void openRemove(uint16_t s);
  uint16_t openTop() const;
  Key openTopKey() const;
  uint16_t openPop();
  void openHeapifyUp(uint16_t pos);
  void openHeapifyDown(uint16_t pos);
  void rebuildOpenHeap();

  void forEachNeighbor(uint16_t s, uint16_t *neighbors, uint8_t &count) const;
  float edgeCost(uint16_t from, uint16_t to) const;
  void updateVertex(uint16_t u);
  bool computeShortestPath(uint32_t max_iterations);
  bool extractPath();
};

#endif // MAPPING_NAV_H_
