RandoL26/ENMT301_RoboCup/include/Herkulex.h

/*
 Hekulex.h - Library for Dongbu Herkulex DRS-0101/DRS-0201 
 Copyright (c) 2012 - http://robottini.altervista.org
 Created by Alessandro on 09/12/2012.
 
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
 *****************************************************************************
    PLEASE START READING: Herkulex Servo Manual (http://www.hovis.co.kr/guide/herkulexeng.pdf)
 *****************************************************************************
 
 IMPORTANT:

  The library works on Arduino UNO/2009 - Arduino Mega.
  Please with Arduino UNO/2009 works with SoftwareSerial library modified with baud rate 57.600.
  Use this begin type:
		begin(57600, int rx, int tx);
 
  For Arduino Mega, please use baud rate 115.200

 *****************************************************************************
 Contact: alegiaco@gmail.com
 Web:     http://robottini.altervista.org
 Autor:   Alessandro Giacomel
 *****************************************************************************  
*/

#ifndef Herkulex_h
#define Herkulex_h


#if defined(ARDUINO) && ARDUINO >= 100  // Arduino IDE Version
#include "Arduino.h"
#else
#include "WProgram.h"
#endif


#define DATA_SIZE	 30		// buffer for input data
#define DATA_MOVE  	 50		// max 10 servos <---- change this for more servos!
#define TIME_OUT     100   	//timeout serial communication (ms)

// SERVO HERKULEX COMMAND - See Manual p40
#define HEEPWRITE    0x01 	//Rom write
#define HEEPREAD     0x02 	//Rom read
#define HRAMWRITE	 0x03 	//Ram write
#define HRAMREAD	 0x04 	//Ram read
#define HIJOG		 0x05 	//Write n servo with different timing
#define HSJOG		 0x06 	//Write n servo with same time
#define HSTAT	 	 0x07 	//Read error
#define HROLLBACK	 0x08 	//Back to factory value
#define HREBOOT	 	 0x09 	//Reboot

// HERKULEX LED - See Manual p29
static int LED_GREEN =	 0x01;
static int LED_BLUE  =   0x02;
static int LED_CYAN  =   0x03;
static int LED_RED   = 	 0x04;
static int LED_GREEN2= 	 0x05;
static int LED_PINK  =   0x06;
static int LED_WHITE =   0x07;

// HERKULEX STATUS ERROR - See Manual p39
static byte H_STATUS_OK					= 0x00;
static byte H_ERROR_INPUT_VOLTAGE 		= 0x01;
static byte H_ERROR_POS_LIMIT			= 0x02;
static byte H_ERROR_TEMPERATURE_LIMIT	= 0x04;
static byte H_ERROR_INVALID_PKT			= 0x08;
static byte H_ERROR_OVERLOAD			= 0x10;
static byte H_ERROR_DRIVER_FAULT  		= 0x20;
static byte H_ERROR_EEPREG_DISTORT		= 0x40;

// HERKULEX Broadcast Servo ID
static byte BROADCAST_ID = 0xFE;

class HerkulexClass {
public:
  void  begin(long baud, int rx, int tx);
  void  beginSerial1(long baud);
  void  beginSerial2(long baud);
  void  beginSerial3(long baud);
  void  end();
  
  void  initialize();
  byte  stat(int servoID);
  void  ACK(int valueACK);
  byte  model();
  void  set_ID(int ID_Old, int ID_New);
  void  clearError(int servoID);
  
  void  torqueON(int servoID);
  void  torqueOFF(int servoID);
  
  void  moveAll(int servoID, int Goal, int iLed);
  void  moveSpeedAll(int servoID, int Goal, int iLed);
  void  moveAllAngle(int servoID, float angle, int iLed);
  void  actionAll(int pTime);
  
  void  moveSpeedOne(int servoID, int Goal, int pTime, int iLed);
  void  moveOne(int servoID, int Goal, int pTime, int iLed);
  void  moveOneAngle(int servoID, float angle, int pTime, int iLed);
  
  int   getPosition(int servoID);
  float getAngle(int servoID);
  int   getSpeed(int servoID);
		
  void  reboot(int servoID);
  void  setLed(int servoID, int valueLed);
 
  void  writeRegistryRAM(int servoID, int address, int writeByte);
  void  writeRegistryEEP(int servoID, int address, int writeByte);

  
// private area  
private:
  void sendData(byte* buffer, int lenght);
  void readData(int size);
  void addData(int GoalLSB, int GoalMSB, int set, int servoID);
  int  checksum1(byte* data, int lenghtString);
  int  checksum2(int XOR);
  void clearBuffer();
  void printHexByte(byte x);

  int port;
  
  int pSize;
  int pID;
  int cmd;
  int lenghtString;
  int ck1;
  int ck2;
  
  int conta;
  
  int XOR;
  int playTime;
    
  byte data[DATA_SIZE]; 
  byte dataEx[DATA_MOVE+8];
  byte moveData[DATA_MOVE];
 
};

extern HerkulexClass Herkulex;

#endif    // Herkulex_h
