RandoL26/ENMT301_RoboCup/include/weight_collection.h

/************************************
 *        weight_collection.h       *
 *************************************/

 /* This header is for functions and tasks for
  *  finding and collecting weights  */

#ifndef WEIGHT_COLLECTION_H_
#define WEIGHT_COLLECTION_H_

#include <Servo.h>                  //control the DC motors
//#include <Herkulex.h>               //smart servo
#include <Wire.h>                   //for I2C and SPI


#include "imu_sensor.h"           //will need sensor library to detect weights


//states for swapping between searching and collecting
#define NO_WEIGHT               0   
#define WEIGHT_FOUND            1
#define ELECTROMAGNET_PIN       26

#define PICKUP_ANGLE            169
#define DROPOFF_ANGLE           120

void weight_scan(/* whatever parameters */);


void collect_weight(int collect_time);



#endif /* WEIGHT_COLLECTION_H_ */
