RandoL26/ENMT301_RoboCup/include/return_to_base.h

//************************************
//         return_to_base.h    
//************************************


#ifndef RETURN_TO_BASE_H_
#define RETURN_TO_BASE_H_

// Return to home base
void return_to_base();

// Detect what base (if any) the robot is above
void detect_base();

// Unload weights in home base
void unload_weights();



#endif /* RETURN_TO_BASE_H_ */
