RandoL26/ENMT301_RoboCup/(commit log)

2026-05-06 Added librarys for Ultrasound sensor
2026-05-07 Working Imu Raw Values
2026-05-10 Working Inductive sensor
2026-05-10 Started Ultrasound Sensor
2026-05-11 Working Ultrasound Sensor
2026-05-13 Added Colour, ir_xy_pos, and TOF sensor code
2026-05-14 DC motor drivers
2026-05-15 Fixed Calibration for IR
    [ir_distance_sensor.cpp, robocup_template.ino]
2026-05-19 importing intial solidworks parts
    [BladeAssembly.SLDASM, BladeWingV1.3MF, BladeWingV1.SLDPRT, RampV1.SLDPRT, Robot Side Plate.SLDPRT, Robot Top Plate 200mm300mm.SLDPRT, WeightModel.SLDPRT]
2026-05-29 completed robot track and basically whole movement assembly
    [40-T5-16 timing pulley.SLDPRT, DriveBeltAssembly.SLDASM, DriveTrackBearingAssembly.SLDASM, FIT0277 Electric Motor_SP.SLDPRT, FatWasher.SLDPRT, Flanged Bearing F608ZZ_SP.SLDPRT, Robot Side Plate.SLDPRT, ThinWasher.SLDPRT]
2026-05-29 removed solidworks files of street sweeper design(obsolete)
    [BladeAssembly.SLDASM, BladeWingV1.SLDPRT, RampV1.SLDPRT]
2026-05-29 cleaning up solidworks file, this might break things revert if so
    [40-T5-16 timing pulley.SLDPRT, DriveBeltAssembly.SLDASM, FIT0277 Electric Motor_SP.SLDPRT, Robot Side Plate.SLDPRT]
2026-05-29 main assembly beginning stages
    [DriveBeltAssembly.SLDASM, MainAssembly.SLDASM, Mirror40-T5-16 timing pulley.SLDPRT, MirrorDriveBeltAssembly.SLDASM, MirrorDriveTrackBearingAssembly.SLDASM, MirrorDriveTrackBearingAssembly1.SLDASM, MirrorDriveTrackBearingAssembly2.SLDASM, MirrorDriveTrackBearingAssembly3.SLDASM]
2026-06-01 starting forklift/crane
    [ElectroMagnet.SLDPRT, ElectromagnetCasing.3MF, ElectromagnetCasing.SLDPRT, RotationalBearingM5TestPeice.3MF, RotationalBearingM5TestPeice.SLDPRT, herkulex_motor_sp.SLDPRT]
2026-06-04 electromagnet redesigned, crane assembly begun
    [Bearing_sp.SLDPRT, CraneArm.SLDPRT, CraneAssembly.SLDASM, ElectroMagnetCasingV2.SLDPRT]
2026-06-22 crane solidworks progress + electromagnet/smart servo code progress(unfinished)
    [CraneArm.SLDPRT, CraneAssembly.SLDASM, DriveBeltAssembly.SLDASM, DriveTrackBearingAssembly.SLDASM, HolderSmartServoBent_SP.SLDPRT, MainAssembly.SLDASM, MirrorDriveBeltAssembly.SLDASM, MirrorDriveTrackBearingAssembly.SLDASM]
2026-06-23 Motor control/PID setup/Controller set up
2026-06-23 "adjusted crane arm for new 60kg servo"
    [60kgServoMount.SLDPRT, CraneArm.SLDPRT, CraneAssembly.SLDASM, DriveBeltAssembly.SLDASM, DriveTrackBearingAssembly.SLDASM, ElectroMagnetCasingV3.SLDPRT, MainAssembly.SLDASM, MirrorDriveBeltAssembly.SLDASM]
2026-06-26 More motor control also need to set up encodeers on motor
2026-06-27 updated crane arm to fix collisions
    [CraneArm.SLDPRT, CraneAssembly.SLDASM, DriveBeltAssembly.SLDASM, DriveTrackBearingAssembly.SLDASM, Floor.SLDPRT, MainAssembly.SLDASM, MirrorDriveBeltAssembly.SLDASM, MirrorDriveTrackBearingAssembly.SLDASM]
2026-07-10 custom chassis designed, still need to completetesnioning for flipped side and start teting
    [Custom Side Plate Flipped.SLDPRT, Custom Side Plate.SLDPRT, CustomDriveBeltAssembly.SLDASM, CustomDriveBeltAssemblyComplete.SLDASM, CustomDriveBeltAssemblyFlipped.SLDASM, DriveBeltAssembly.SLDASM, DriveTrackBearingAssembly.SLDASM, FIT0277 Electric Motor_SP.SLDPRT]
2026-07-10 encoder started not working
    [dc_motor.cpp, dc_motor.h, motor_control.cpp, motor_control.h, robocup_template.ino]
2026-07-13 electronics, storage and custom chassis progress
    [CraneArm.SLDPRT, CraneArmSupport.SLDPRT, CraneAssembly.SLDASM, Custom Chassis Base.SLDPRT, CustomDriveBeltAssembly.SLDASM, CustomDriveBeltAssemblyComplete.SLDASM, CustomDriveBeltAssemblyFlipped.SLDASM, DriveTrackBearingAssembly.SLDASM]
2026-07-13 Restored motor control files
2026-07-13 added more electronic components, time to adjust crane arm a lot :(
    [60kgServoMount.SLDPRT, CraneArm.SLDPRT, CraneArmSupport.SLDPRT, CraneAssembly.SLDASM, Custom Chassis Base.SLDPRT, Custom Side Plate Flipped.SLDPRT, Custom Side Plate.SLDPRT, CustomDriveBeltAssembly.SLDASM]
2026-07-14 weight guides included, support layers extended, main assembly now in customdrivebeltassemblyalternate
    [CraneAssembly.SLDASM, CustomDriveBeltAssemblyAlternate.SLDASM, CustomDriveBeltAssemblyComplete.SLDASM, DriveBeltAssembly.SLDASM, Electronics Bay Upper.SLDPRT, ElectronicsAssembly.SLDASM, MDFWeightGuides.SLDPRT, MainAssembly.SLDASM]
2026-07-14 Working motors no encoders yet
2026-07-14 started mdf layer attachment points
    [CraneAssembly.SLDASM, CustomDriveBeltAssembly.SLDASM, CustomDriveBeltAssemblyAlternate.SLDASM, CustomDriveBeltAssemblyFlipped.SLDASM, DriveTrackBearingAssembly.SLDASM, MDF Layer Attachment.SLDPRT]
2026-07-14 adjusted chassis width to 150mm to account for default al extrustion sizes
    [CraneAssembly.SLDASM, Custom Chassis Base.SLDPRT, Custom Side Plate Flipped.SLDPRT, Custom Side Plate.SLDPRT, CustomDriveBeltAssembly.SLDASM, CustomDriveBeltAssemblyAlternate.SLDASM, CustomDriveBeltAssemblyFlipped.SLDASM, DriveTrackBearingAssembly.SLDASM]
2026-07-14 git issues
    [CraneAssembly.SLDASM, Custom Chassis Base.SLDPRT, Custom Side Plate Flipped.SLDPRT, Custom Side Plate.SLDPRT, CustomDriveBeltAssembly.SLDASM, CustomDriveBeltAssemblyAlternate.SLDASM, CustomDriveBeltAssemblyFlipped.SLDASM, DriveTrackBearingAssembly.SLDASM]
2026-07-15 Broken board, started encoder waiting on board fix
    [dc_motor.cpp, dc_motor.h, motor_control.cpp, motor_control.h, robocup_template.ino]
2026-07-15 tset print of mdf layers, flipped holes bc jed is stupid
    [CraneAssembly.SLDASM, CustomDriveBeltAssembly.SLDASM, CustomDriveBeltAssemblyAlternate.SLDASM, CustomDriveBeltAssemblyComplete.SLDASM, CustomDriveBeltAssemblyFlipped.SLDASM, DriveBeltAssembly.SLDASM, DriveTrackBearingAssembly.SLDASM, MDF Layer Attachment.SLDPRT]
2026-07-16 TOF designed, attachment points for perspex chassis added, inductive sensor designed, mount created and added into main assembly
    [CraneAssembly.SLDASM, Custom Chassis Base.SLDPRT, Custom Side Plate Flipped.SLDPRT, Custom Side Plate.SLDPRT, CustomDriveBeltAssembly.SLDASM, CustomDriveBeltAssemblyAlternate.SLDASM, CustomDriveBeltAssemblyFlipped.SLDASM, DriveTrackBearingAssembly.SLDASM]
2026-07-17 Encoder is working, Flipped sign so that encoder readings are consistent in direction. Added another command 'FWRD1' effectively the same as 'MOTOR 50 50' command. I think should add a way to clear/r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
    [robocup_template.ino]
2026-07-19 WORKING ENCODERS, PID CONTROL STARTED NEED TO FINISH
2026-07-19 printing setup for mdf chassis boards
    [CraneAssembly.SLDASM, Custom Chassis Base.DXF, Custom Chassis Base.SLDPRT, Custom Side Plate Flipped.DXF, Custom Side Plate Flipped.SLDPRT, Custom Side Plate.DXF, Custom Side Plate.SLDPRT, CustomDriveBeltAssembly.SLDASM]
2026-07-20 minor changes
    [CraneArm.3MF, Custom Side Plate Flipped.SLDPRT, CustomDriveBeltAssemblyFlipped.SLDASM, DriveTrackBearingAssembly.SLDASM]
2026-07-21 Progress for BT COM Port connectivity issues
    [ch9143_bluetooth.cpp, robocup_template.ino]
2026-07-24 TOF sensor working in VS CODE (Black is 1 and Purple is 0)
2026-07-26 Optical Flow sensor working with distance travelled, set up motor control waiting on track layout
2026-07-26 Controller issues with python libs
    [robocup_template.ino]
2026-07-27 Learned how to add multiple sensors. Found out there were some sensor offset issues. Added a function to remove offset per sensor.
    [robocup_template.ino, tof_sensor_array.cpp, tof_sensor_array.h]
2026-07-28 Added other sensor file
2026-07-28 added first set of TOF sensors, started adjsting weight guides
    [CraneAssembly.SLDASM, Custom Side Plate Flipped.SLDPRT, Custom Side Plate.SLDPRT, CustomDriveBeltAssembly.SLDASM, CustomDriveBeltAssemblyAlternate.SLDASM, CustomDriveBeltAssemblyFlipped.SLDASM, CustomDriveBeltAssemblyRaisedCrane.SLDASM, DriveBeltAssembly.SLDASM]
2026-07-30 tidied max motor values
2026-08-02 adjusted chassis side walls to allow for internally wrapped drive gears
    [CraneAssembly.SLDASM, Custom Side Plate Flipped.SLDPRT, Custom Side Plate.SLDPRT, CustomDriveBeltAssembly.SLDASM, CustomDriveBeltAssemblyAlternate.SLDASM, CustomDriveBeltAssemblyFlipped.SLDASM, DriveBeltAssembly.SLDASM, DriveTrackBearingAssembly.SLDASM]
2026-08-05 DriveWheel made need testing
    [DrivewheelDraft1.SLDPRT]
2026-08-06 Addition of purple sensor cooked the initialisation.
2026-08-07 Other sensor works with target detection now. It now initialises all the sensors regardless of the type.
2026-08-07 added deposit capability to storage
    [CraneAssembly.SLDASM, Custom Side Plate Flipped.SLDPRT, Custom Side Plate.SLDPRT, CustomDriveBeltAssembly.SLDASM, CustomDriveBeltAssemblyAlternate.SLDASM, CustomDriveBeltAssemblyFlipped.SLDASM, DriveTrackBearingAssembly.SLDASM, ElectronicsAssembly.SLDASM]
2026-08-11 begun engineering drawings
    [CraneArm.SLDDRW, CraneArm.SLDPRT, CraneAssembly.SLDASM, Custom Side Plate.SLDDRW, Custom Side Plate.SLDPRT, CustomDriveBeltAssembly.SLDASM, CustomDriveBeltAssemblyAlternate.SLDASM, CustomDriveBeltAssemblyFlipped.SLDASM]
2026-08-13 adjustmetns for report photos
    [CraneAssembly.SLDASM, CustomDriveBeltAssembly.SLDASM, CustomDriveBeltAssemblyAlternate.SLDASM, CustomDriveBeltAssemblyFlipped.SLDASM, DriveTrackBearingAssembly.SLDASM, MDFWeightGuides.SLDPRT, wieghtguideassembly.SLDASM]
2026-08-14 engineering drawings for report
    [CraneArm.SLDDRW, CraneArm.SLDPRT, CustomDriveBeltAssembly.SLDASM, CustomDriveBeltAssemblyAlternate.SLDASM, CustomDriveBeltAssemblyFlipped.SLDASM, DriveTrackBearingAssembly.SLDASM, Electronics Bay Upper.SLDDRW, Electronics Bay Upper.SLDPRT]
2026-08-18 more electornics layers
    [CraneAssembly.SLDASM, Custom Side Plate Flipped.SLDPRT, Custom Side Plate.SLDPRT, CustomDriveBeltAssembly.SLDASM, CustomDriveBeltAssemblyAlternate.SLDASM, CustomDriveBeltAssemblyFlipped.SLDASM, DriveTrackBearingAssembly.SLDASM, Electronics Bay Upper.SLDPRT]
2026-08-18 Added sensor mounts please check
    [CraneAssembly.SLDASM, CustomDriveBeltAssembly.SLDASM, CustomDriveBeltAssemblyAlternate.SLDASM, CustomDriveBeltAssemblyFlipped.SLDASM, DriveTrackBearingAssembly.SLDASM, Sensor Mount L.SLDPRT, Sensor Mount.SLDPRT]
2026-08-18 Working LiDAR using Teleplot extension
2026-08-28 idek anymore
    [CraneArm.SLDPRT, CraneAssembly.SLDASM, Custom Chassis Base.SLDPRT, Custom Side Plate Flipped.SLDPRT, CustomDriveBeltAssembly.SLDASM, CustomDriveBeltAssemblyAlternate.SLDASM, CustomDriveBeltAssemblyFlipped.SLDASM, DriveTrackBearingAssembly.SLDASM]
2026-09-08 Fixed Lidar callback
    [Drive wheelV1.SLDPRT, Drive wheelV1.STL]
2026-09-11 Motor tested with new chassis and tension. Works well, Encoders have similar values throughout. Need testing with Bluetooth and Controller for turning and stuff. Can move to sensor and pathfinding.
2026-09-16 reworked eletroncis storgae
    [CraneAssembly.SLDASM, Custom Chassis Base.SLDPRT, Custom Side Plate Flipped.SLDPRT, Custom Side Plate.SLDPRT, CustomDriveBeltAssembly.SLDASM, CustomDriveBeltAssemblyAlternate.SLDASM, CustomDriveBeltAssemblyFlipped.SLDASM, DriveTrackBearingAssembly.SLDASM]
2026-09-18 most recent rpinted version
    [Button Support.SLDPRT, Custom Chassis Base.SLDPRT, Custom Side Plate Flipped.SLDPRT, Custom Side Plate.SLDPRT, CustomDriveBeltAssembly.SLDASM, CustomDriveBeltAssemblyAlternate.SLDASM, CustomDriveBeltAssemblyFlipped.SLDASM, DriveTrackBearingAssembly.SLDASM]
2026-09-19 fixed prtining issues and prepped for second round of printing
    [Button Support.SLDPRT, CraneAssembly.SLDASM, Custom Chassis Base.SLDPRT, Custom Side Plate.SLDPRT, CustomDriveBeltAssembly.SLDASM, CustomDriveBeltAssemblyAlternate.SLDASM, CustomDriveBeltAssemblyFlipped.SLDASM, DriveTrackBearingAssembly.SLDASM]
2026-09-20 Redid Target detector to accomodate LiDAR sensor instead of Top Sensor to detect obstacles. Some assumptions are made so brace for errors.
    [target_detector.cpp, target_detector.h]
2026-09-22 inductive shift board added to electonrics bay
    [CraneAssembly.SLDASM, CustomDriveBeltAssembly.SLDASM, CustomDriveBeltAssemblyAlternate.SLDASM, CustomDriveBeltAssemblyFlipped.SLDASM, DriveTrackBearingAssembly.SLDASM, ElectronicsAssembly.SLDASM, Inductiveshiftmount.SLDPRT, InductiveshiftmountFlipped.SLDPRT]
2026-09-24 serial level shift
    [CustomDriveBeltAssembly.SLDASM, CustomDriveBeltAssemblyAlternate.SLDASM, CustomDriveBeltAssemblyFlipped.SLDASM, DriveTrackBearingAssembly.SLDASM, ElectronicsAssembly.SLDASM, serial level shift.SLDPRT]
2026-09-25 Made Gears with ratio doubling speed.
    [13 Teeth Gear.SLDPRT, 26 Teeth Gear Drving.SLDPRT, CustomDriveBeltAssembly.SLDASM, CustomDriveBeltAssemblyAlternate.SLDASM, CustomDriveBeltAssemblyFlipped.SLDASM, DriveTrackBearingAssembly.SLDASM]
2026-09-25 positions for optical flow imu
    [Custom Chassis Base.SLDPRT, Custom Side Plate Flipped.SLDPRT, Custom Side Plate.SLDPRT, CustomDriveBeltAssembly.SLDASM, CustomDriveBeltAssemblyAlternate.SLDASM, CustomDriveBeltAssemblyFlipped.SLDASM, DriveTrackBearingAssembly.SLDASM, ElectronicsAssembly.SLDASM]
2026-09-25 Gears for robot
    [13 Teeth Gear on 20mm bearing.SLDPRT, 13 Teeth Gear.SLDPRT, 26 Teeth Gear 5mm bore for motor shaft.SLDPRT, 26 Teeth Gear Drving.SLDPRT]
2026-09-25 wire pathways etc
    [CraneAssembly.SLDASM, Custom Side Plate Flipped.SLDPRT, Custom Side Plate.SLDPRT, CustomDriveBeltAssembly.SLDASM, CustomDriveBeltAssemblyAlternate.SLDASM, CustomDriveBeltAssemblyFlipped.SLDASM, DriveTrackBearingAssembly.SLDASM, Electronics Bay Upper.SLDPRT]
2026-09-26 adjusted carne arm mostly
    [CraneArm.SLDPRT, CraneAssembly.SLDASM, CustomDriveBeltAssembly.SLDASM, CustomDriveBeltAssemblyAlternate.SLDASM, CustomDriveBeltAssemblyFlipped.SLDASM, DriveTrackBearingAssembly.SLDASM]
2026-09-26 Adjusted Gears to fit bearing, motor, and drivebelt meshing
    [13 Teeth Gear on 20mm bearing.SLDPRT, 13 Teeth Gear on 20mm bearing.STL, 26 Teeth Gear 6.25mm bore for motor shaft.SLDPRT, 26 Teeth Gear 6.25mm bore for motor shaft.STL, Drive wheelV1.SLDPRT]
2026-09-27 pickup mechanism code improved
    [CraneArm.SLDPRT]
2026-09-27 Redid chassis to fit gear to double speed.
    [10 Teeth Gear 22mm bearing, drivebelt meshing.SLDPRT, 10 Teeth Gear 22mm bearing, drivebelt meshing.STL, 13 Teeth Gear on 20mm bearing.SLDPRT, 13 Teeth Gear on 20mm bearing.STL, 13 Teeth Gear on 22mm bearing improvement on the drivewheel meshing.SLDPRT, 13 Teeth Gear on 22mm bearing improvement on the drivewheel meshing.STL, 20 Teeth Gear 6.25mm bore for motor shaft.SLDPRT, 20 Teeth Gear 6.25mm b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]
2026-09-27 SOME FUCKING BULLLLLSHIT
    [10 Teeth Gear 22mm bearing, drivebelt meshing.SLDPRT, 10 Teeth Gear 22mm bearing, drivebelt meshing.STL, 13 Teeth Gear on 20mm bearing.SLDPRT, 13 Teeth Gear on 20mm bearing.STL, 13 Teeth Gear on 22mm bearing improvement on the drivewheel meshing.SLDPRT, 13 Teeth Gear on 22mm bearing improvement on the drivewheel meshing.STL, 20 Teeth Gear 6.25mm bore for motor shaft.SLDPRT, 20 Teeth Gear 6.25mm b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]
2026-09-27 Changed Pair detection tolerance to be more forgiving for testing, can be reduced later when system is working
    [target_detector.h]
2026-09-28 Added seek weight state. Current Lane Plan is Lawnmower esc pathing to be changed to a more efficient pathing. Values and Configs needs to be measured and offsets are to be accounted for. Confirm dis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
2026-09-29 Switched the gears to have a metal grubscrew
    [10 Teeth Gear 22mm bearing, drivebelt meshing.SLDPRT, 20 Teeth Gear 6.25mm blahblahblah.SLDPRT, 20 Teeth Gear 6.25mm bore for motor shaft.SLDPRT, CraneAssembly.SLDASM, CustomDriveBeltAssembly.SLDASM, CustomDriveBeltAssemblyAlternate.SLDASM, CustomDriveBeltAssemblyFlipped.SLDASM, DriveTrackBearingAssembly.SLDASM]
2026-09-29 Add rolling average filter for ToF sensor readings
2026-09-29 Implement rolling average ToF noise filter
    [tof_sensor_array.cpp]
2026-09-29 Revert ToF averaging filter
    [tof_sensor_array.h]
2026-09-29 Add separate LiDAR obstacle configuration for target detection
2026-09-29 Require separate 3-point LiDAR obstacle for target candidates
2026-09-29 Configure three-point separate LiDAR obstacle detection
2026-09-29 "fix the big servo"
    [BigServo.cpp, BigServo.h, robocup_template.ino, weight_collection.cpp, weight_collection.h]
